lwa-project/analog_receiver/ARX Rev I/Documentation/Pictures/TB-409-74+ GALI-74+ Eval Boad IMG_9608.JPG

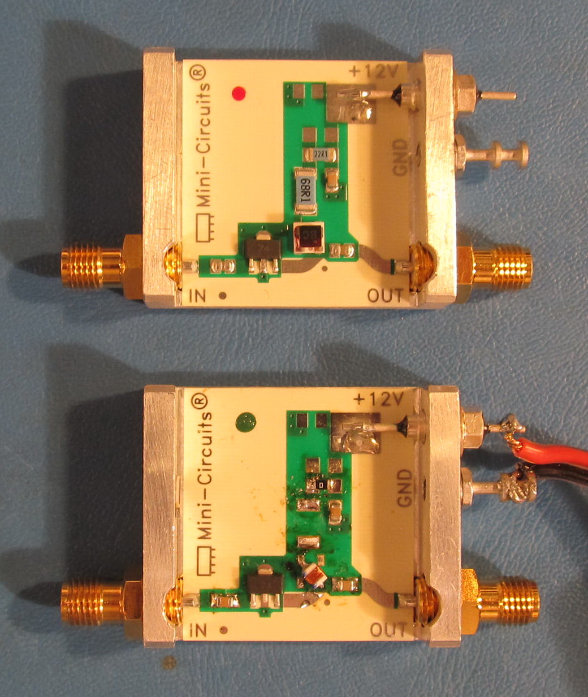
ARX Rev I/Documentation/Pictures/TB-409-74+ GALI-74+ Eval Boad IMG_9608.JPG
