lwa-project/analog_receiver/README.md

LWA Analog Receiver (ARX) Board
===============================
This repo contains the build files for Revision I of the LWA ARX board.
