lwa-project/analog_receiver/ARX Rev I/ARX Rev I Filter Plots/AIO_FB1_10MHz-HPF_2023-08-21_172632.png

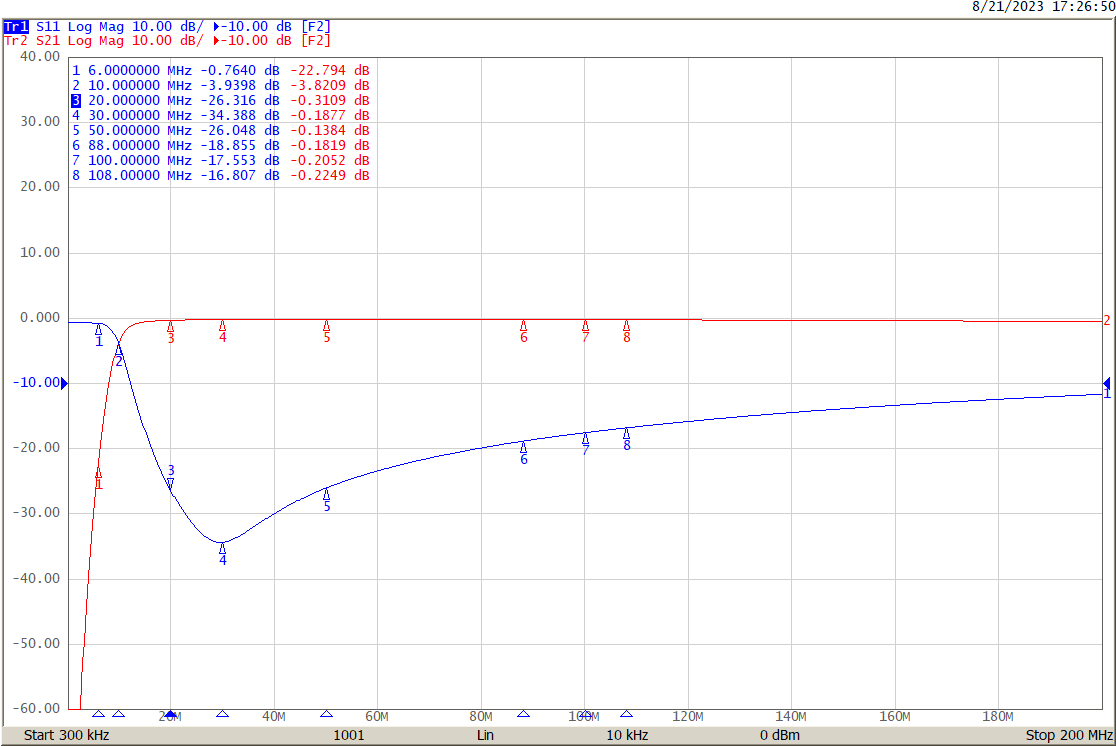
ARX Rev I/ARX Rev I Filter Plots/AIO_FB1_10MHz-HPF_2023-08-21_172632.png
