lwa-project/analog_receiver/ARX Rev I/ARX Rev I Filter Plots/AIO_FB1_30MHz-HPF_2023-08-21_173531.png

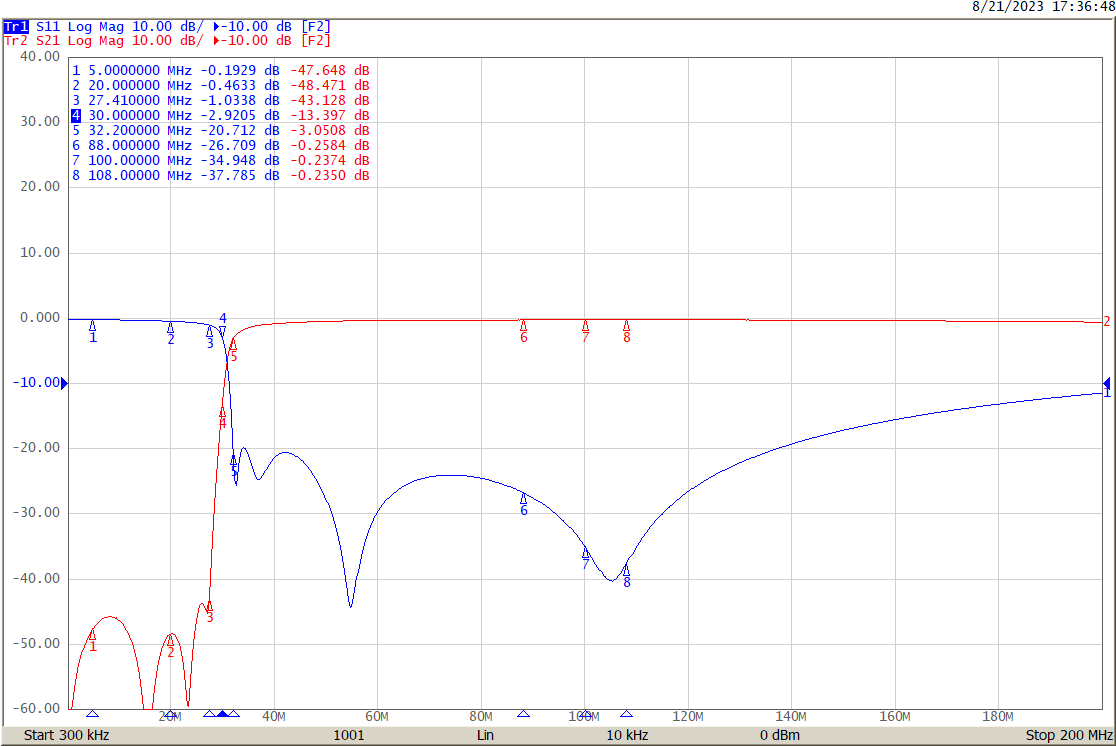
ARX Rev I/ARX Rev I Filter Plots/AIO_FB1_30MHz-HPF_2023-08-21_173531.png
