lwa-project/analog_receiver/ARX Rev I/ARX Rev I Filter Plots/AIO_FB1_83.7MHz-LPF_2023-08-21_172030.png

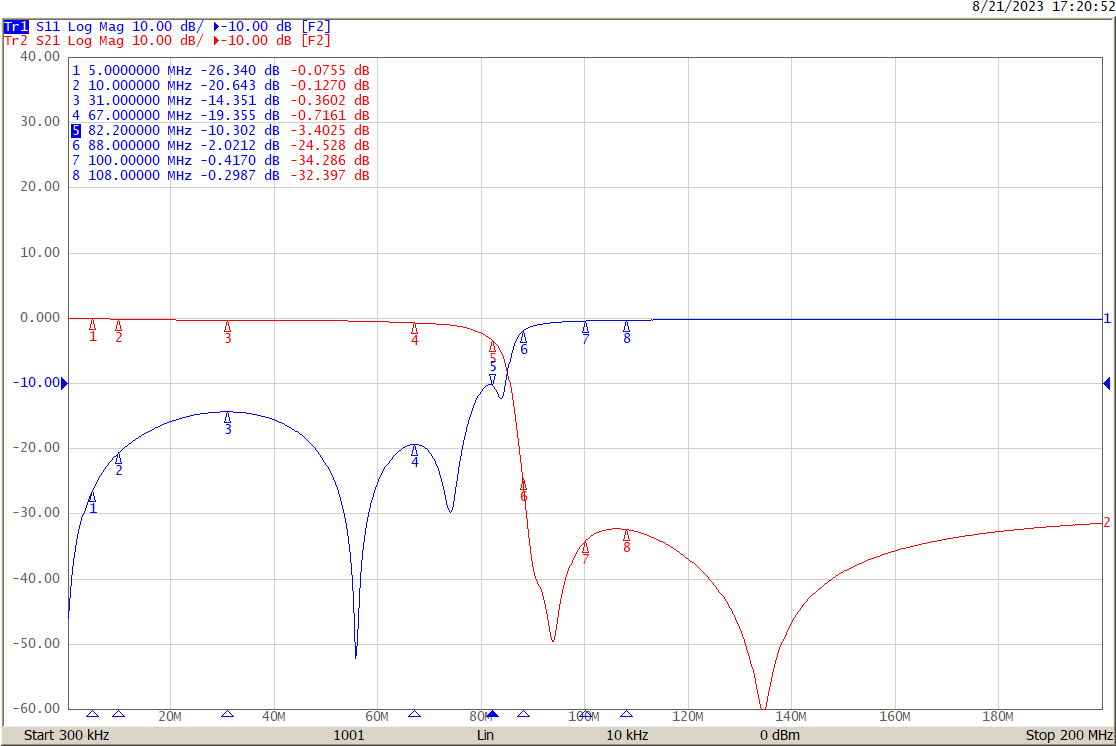
ARX Rev I/ARX Rev I Filter Plots/AIO_FB1_83.7MHz-LPF_2023-08-21_172030.png
