lwa-project/analog_receiver/ARX Rev I/ARX Rev I Filter Plots/AIO_FB5_3MHz-HPF_680pF_2023-09-18_232620.png

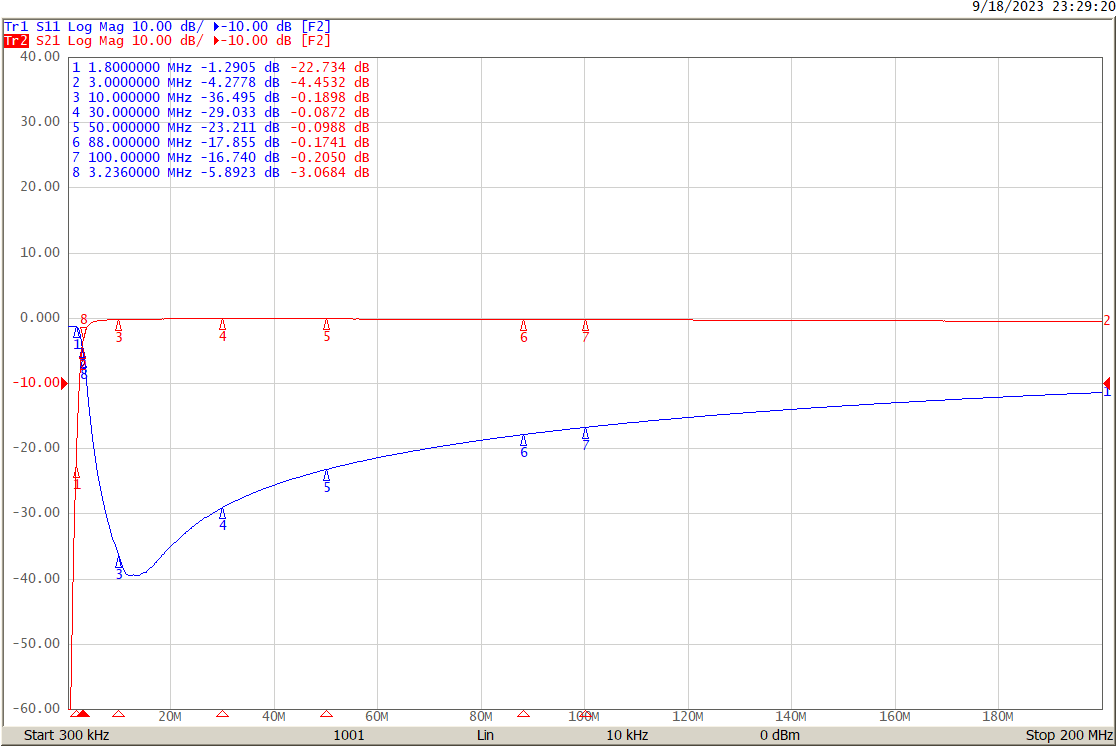
ARX Rev I/ARX Rev I Filter Plots/AIO_FB5_3MHz-HPF_680pF_2023-09-18_232620.png
