lwa-project/analog_receiver/ARX Rev I/ARX Rev I Filter Plots/AIO_FB5_73.5MHz-LPF_2023-08-29_225510.png

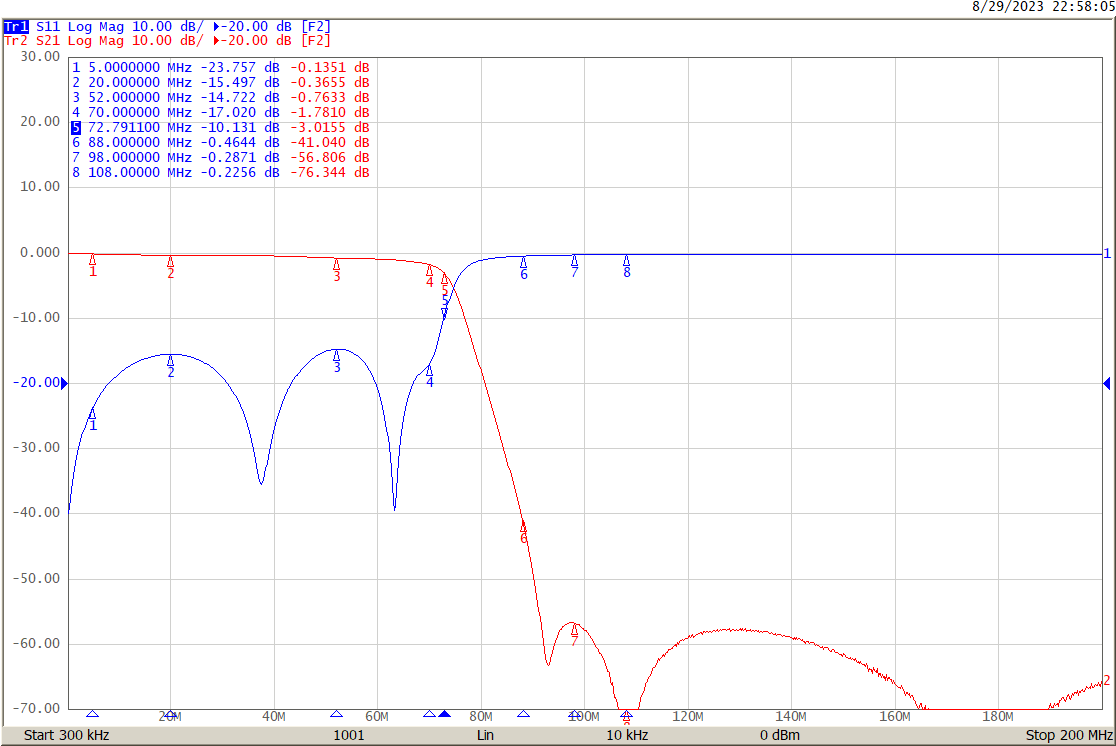
ARX Rev I/ARX Rev I Filter Plots/AIO_FB5_73.5MHz-LPF_2023-08-29_225510.png
