lwa-project/analog_receiver/ARX Rev I/ARX.jpg

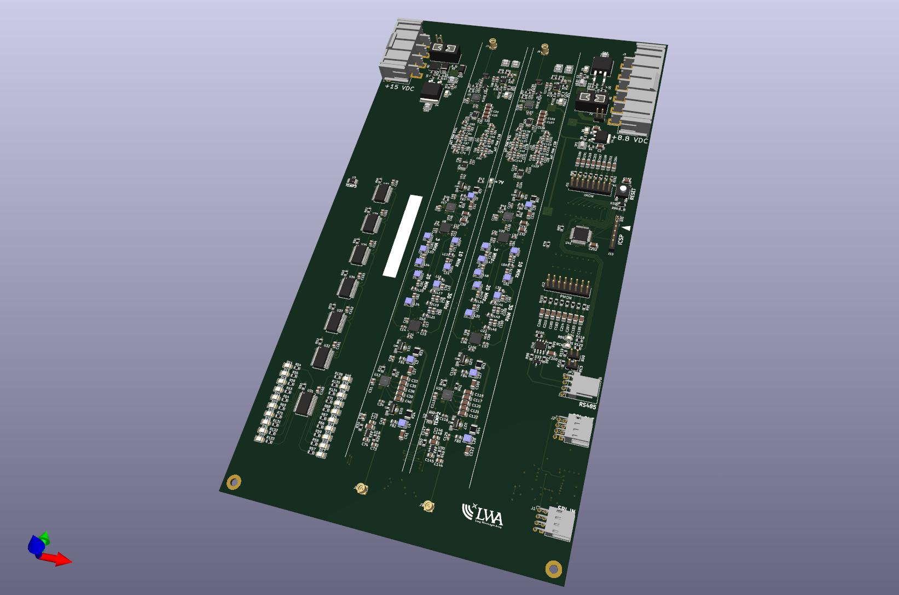
ARX Rev I/ARX.jpg
