lwa-project/analog_receiver/ARX Rev I/ARX_3D_View.png

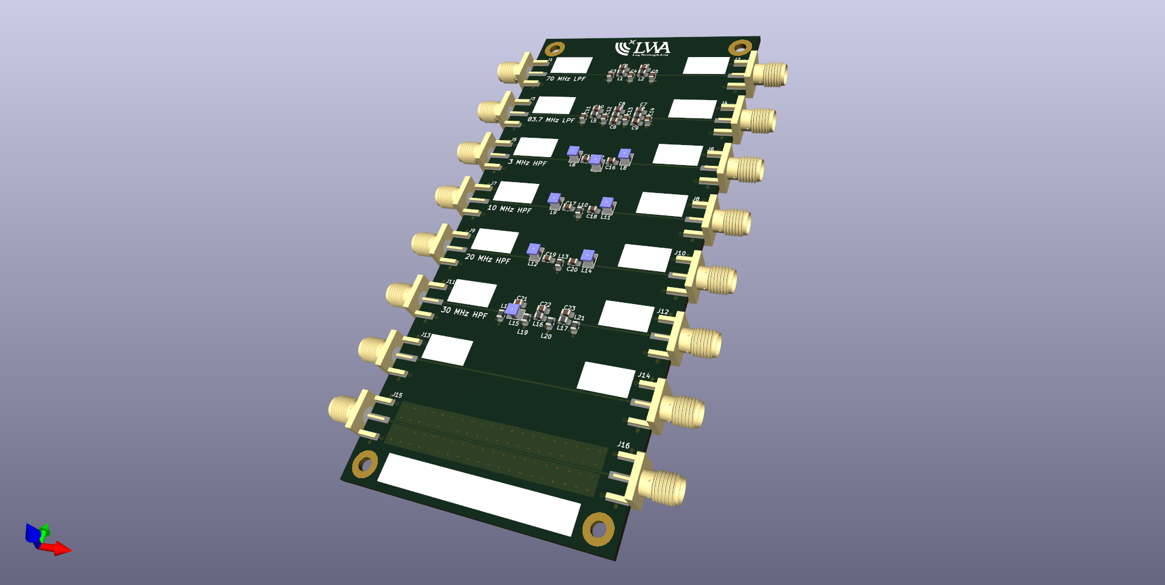
ARX Rev I/ARX_3D_View.png
