lwa-project/analog_receiver/ARX Rev I/Documentation/ARX Rev G Layer Stack.JPG

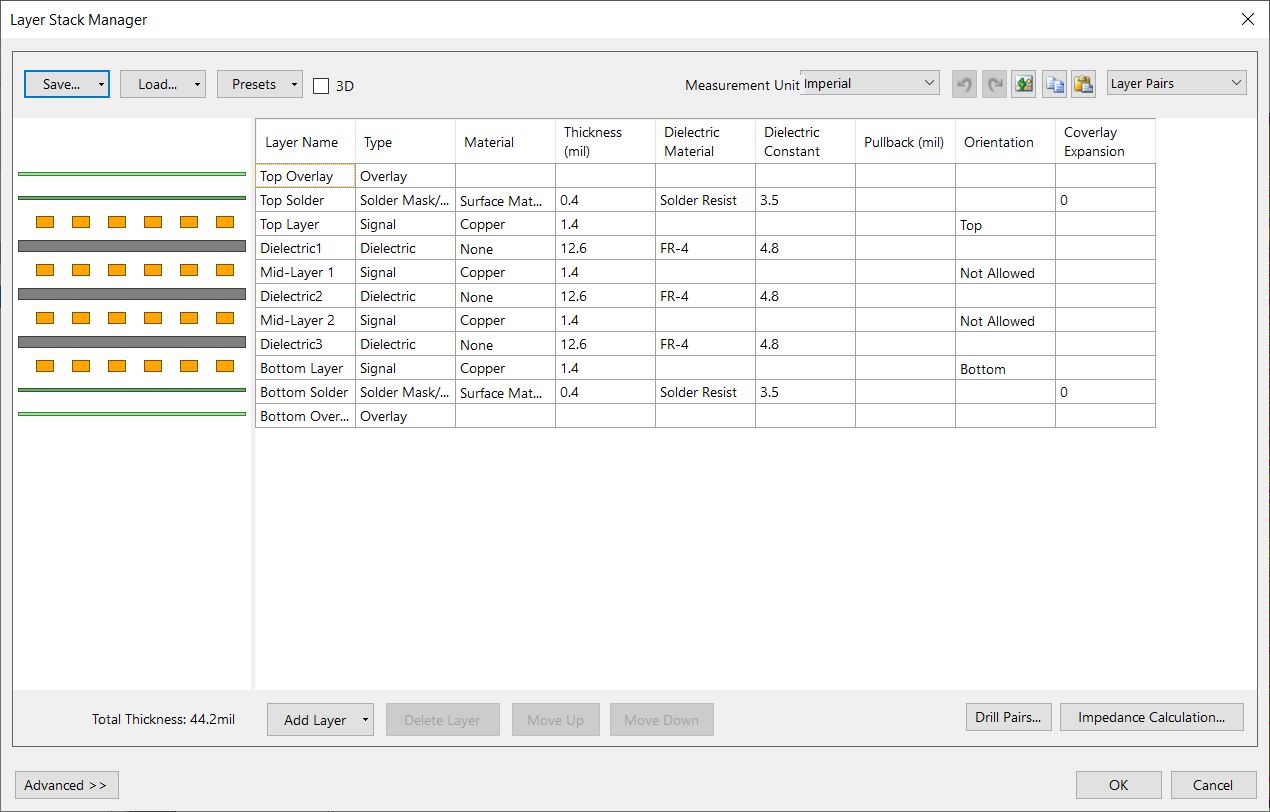
ARX Rev I/Documentation/ARX Rev G Layer Stack.JPG
