lwa-project/analog_receiver/ARX Rev I/Documentation/RevG Buffer/Buffer Fiasco.png

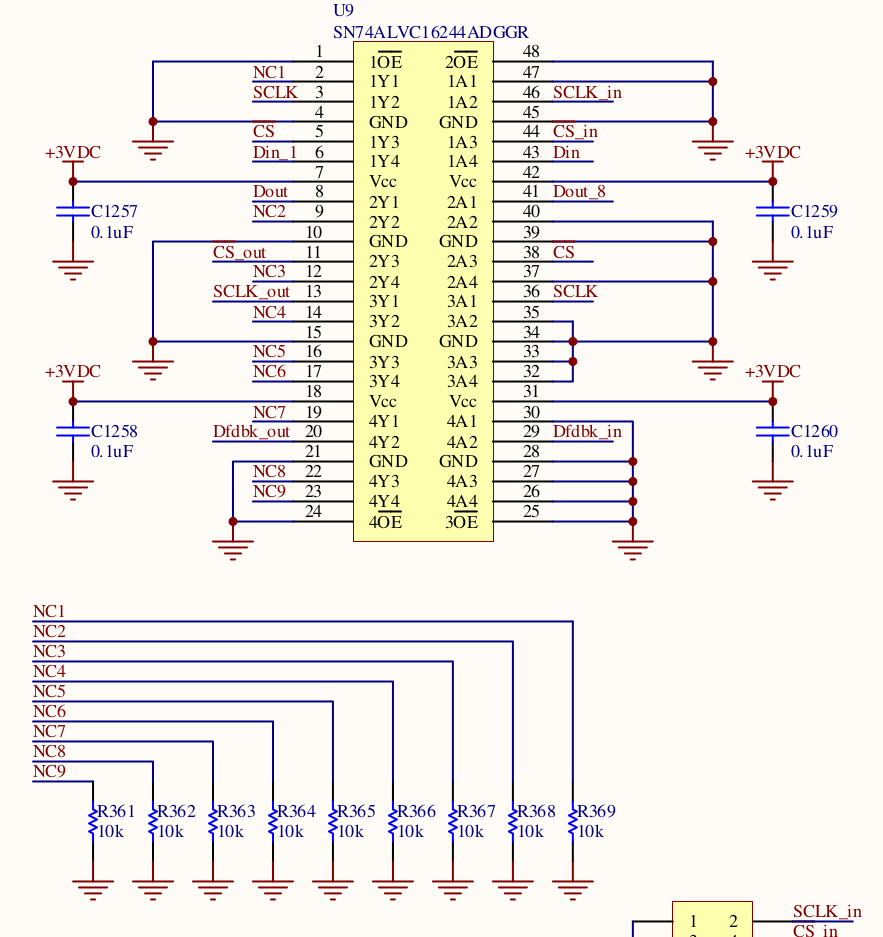
ARX Rev I/Documentation/RevG Buffer/Buffer Fiasco.png
