lwa-project/analog_receiver/ARX Rev I/Filter Designs/ARX Rev. I Filters/HighPass Filters/Schematics Catalog Values/3MHz_HPF_Schematic.png

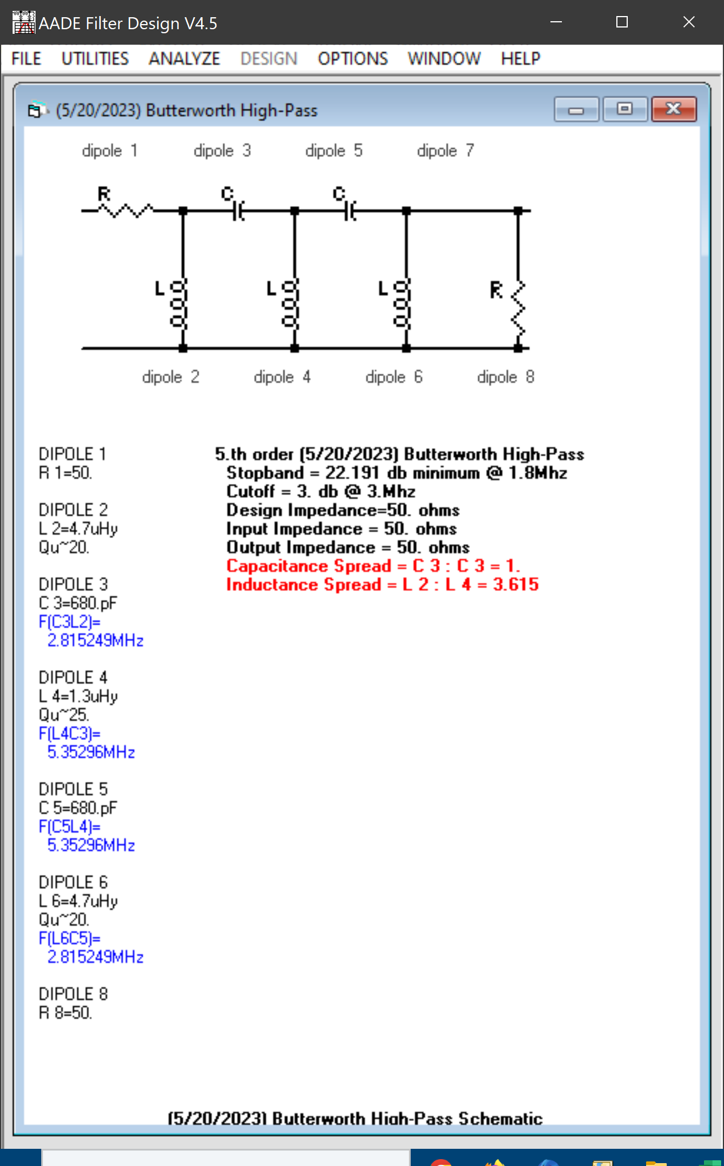
ARX Rev I/Filter Designs/ARX Rev. I Filters/HighPass Filters/Schematics Catalog Values/3MHz_HPF_Schematic.png
