lwa-project/analog_receiver/ARX Rev I/Filter Designs/ARX Rev. I Filters/LowPass Filters/Schematic Catalog Values/70MHz_LPF_Schematic.png

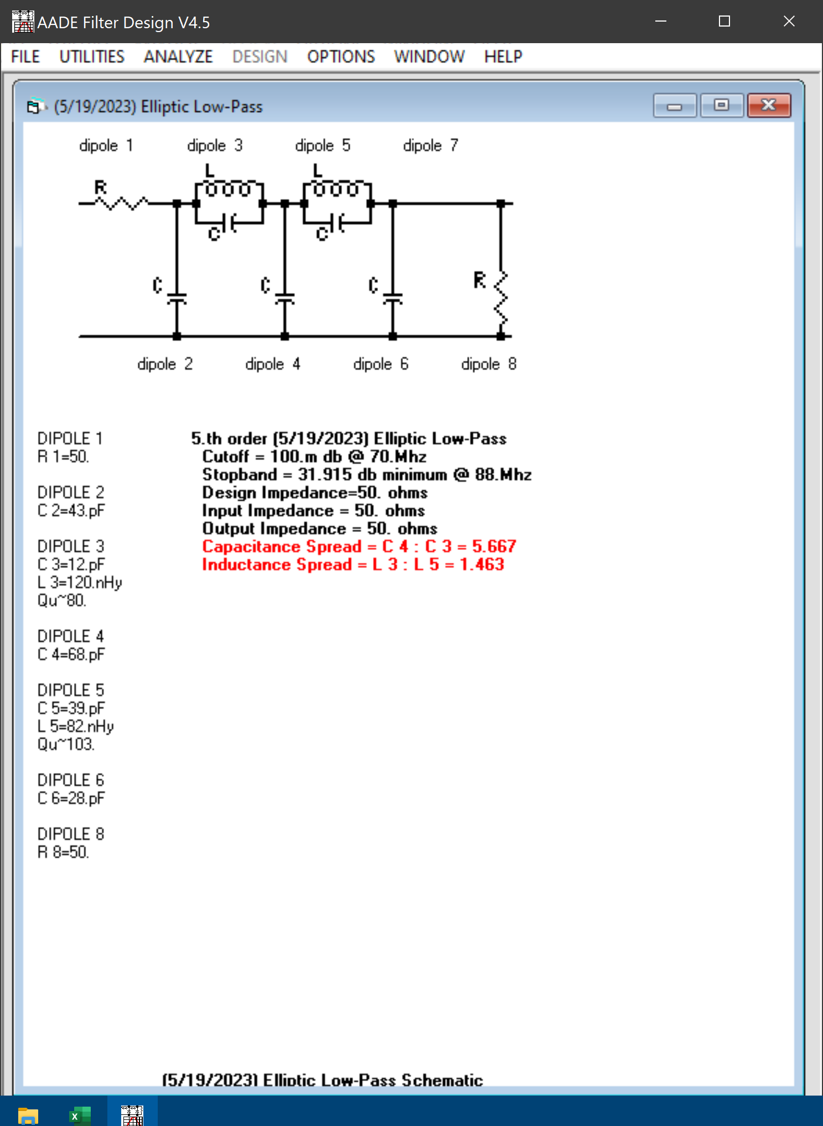
ARX Rev I/Filter Designs/ARX Rev. I Filters/LowPass Filters/Schematic Catalog Values/70MHz_LPF_Schematic.png
