lwa-project/analog_receiver/ARX Rev I/Output Files/3D Views/3D Top View.jpg

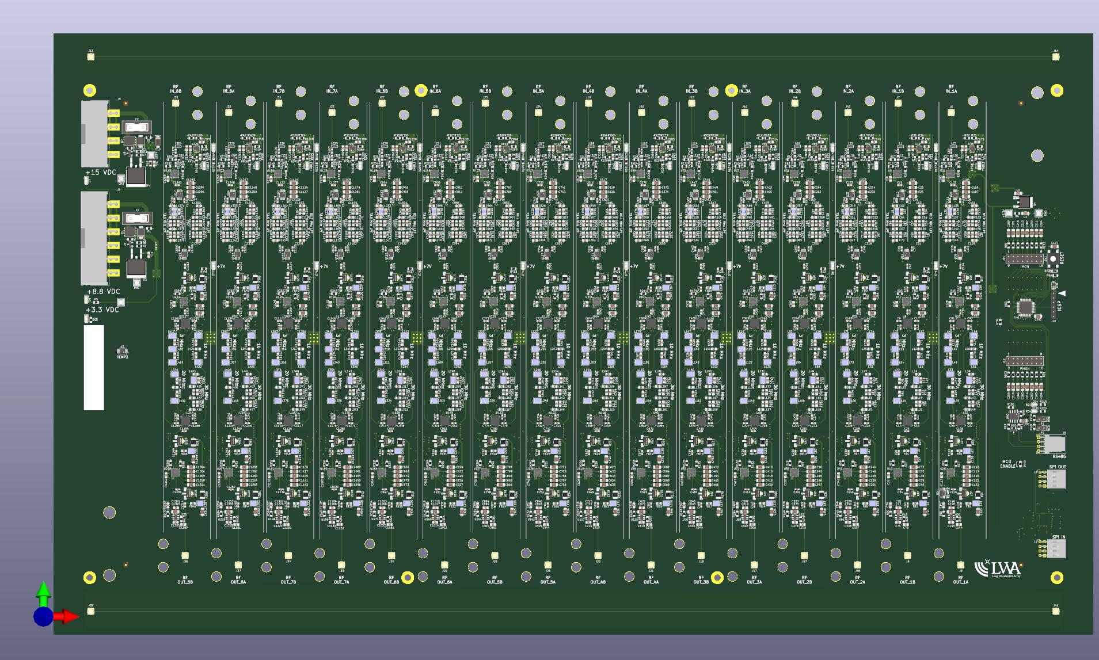
ARX Rev I/Output Files/3D Views/3D Top View.jpg
