lwa-project/analog_receiver/ARX Rev I/Filter Designs/ARX Rev. I Filters/LPF-HPF Filter Designs.xls

Sheet: LPF
Dipole | Calc. | Catalog | Size | SRF | Q | Cost | Dipole | Calc. | Catalog | Size | SRF | Q | Cost
Elliptic LPF, Fc=70 MHz @ 0.1 dB, Fs=88@ 30 dB, Order 5 |  |  |  |  |  |  | Elliptic LPF, Fc=80 MHz @ 0.1 dB, Fs=98MHz @ 30 dB, Order 5
C2 | 43.1p | 43p | 0805 |  |  | $0.29 | C2 | 37.0p | 36p | 0805 |  |  | $0.06
C3 | 12.0p | 12p | 0805 |  |  | $0.06 | C3 | 11.6p | 12p | 0805 |  |  | $0.09
L3 | 126n | 120n | 0805HP | 1265 | 80 | $0.87 | L3 | 108n | 100n | 0805HP | 1400 | 100 | $0.87
C4 | 65.9p | 68p | 0805 |  |  | $0.09 | C4 | 56.2p | 56p | 0805 |  |  | $0.08
C5 | 39.1p | 39p | 0805 |  |  | $0.06 | C5 | 39.9p | 39p | 0805 |  |  | $0.08
L5 | 79n | 82n | 0805HP | 1525 | 103 | $0.87 | L5 | 64.1n | 62n | 0805HP | 1820 | 114 | $0.87
C6 | 27.9p | 27p | 0805 |  |  | $0.06 | C6 | 22.6p | 23p | 0805 |  |  | $0.29
 |  |  |  |  | Total | $2.29 |  |  |  |  |  | Total | $2.33

Sheet: HPF
Dipole | Calc. | Catalog | Size | SRF | Q | Cost | Dipole | Calc. | Catalog | Size | SRF | Q | Cost | h
Butterworth HPF, Fc=3 MHz @ 3.0 dB, Fs=1.8 MHz @ 20 dB, Order 5 |  |  |  |  |  |  | Butterworth HPF, Fc=10 MHz @ 3.0 dB, Fs=6 MHz @ 20 dB, Order 5
L2 | 4294n | 4700n | 1008CS | 90 | 20 |  | L2 | 1288n | 1300n | 1008CS | 200 | 25
C3 | 656.07p | 680p | 0805 |  |  |  | C3 | 196.82p | 200p | 0805
L4 | 1327n | 1300n | 1008CS | 200 | 25 |  | L4 | 398n | 390n | 0805HP | 700 | 52
C5 | 656.07p | 680p | 0805 |  |  |  | C5 | 196.82p | 200p | 0805
L6 | 4294n | 4700n | 1008CS | 90 | 20 |  | L6 | 1288n | 1300n | 1008CS | 200 | 25
 |  |  |  |  | Total | $0.00 |  |  |  |  |  | Total | $0.00
Butterworth HPF, Fc=20 MHz @ 3.0 dB, Fs=12 MHz @ 20 dB, Order 5 |  |  |  |  |  |  | Elliptic HPF, Fc=31 MHz @ 0.1 dB, Fs=26.5MHz @ 30 dB, Order 7
L2 | 644n | 680n | 0805HP | 535 | 46 |  | L2 | 247.62n | 250n | 0805HP | 873 | 74
C3 | 98.41p | 96p | 0805 |  |  |  | C3 | 83.42p | 82p | 0805
L4 | 199n | 200n | 0805HP | 950 | 75 |  | L3 | 1432n | 1300n | 1008CS | 200 | 25
C5 | 98.41p | 96p | 0805 |  |  |  | L4 | 178.9n | 180n | 0805HP | 1025
L6 | 644n | 680n | 0805HP | 535 | 46 |  | C5 | 132.55p | 130p | 0805
 |  |  |  |  |  |  | L5 | 279n | 270n | 0805HP | 830 | 75
 |  |  |  |  | Total | $0.00 | L6 | 208n | 200n | 0805HP | 950 | 75
 |  |  |  |  |  |  | C7 | 123.64p | 120p | 0805
 |  |  |  |  |  |  | L7 | 387n | 390n | 0805HP | 700 | 52
 |  |  |  |  |  |  | L8 | 364n | 390n | 0805HP | 700 | 52
 |  |  |  |  |  |  |  |  |  |  |  | Total | $0.00

Sheet: Residual
Chebyshev LPF, Fc=70 MHz @ 0.1 dB, Fs=88 MHz @ 30 dB, Order 9 |  |  |  |  |  |  | Chebyshev LPF, Fc=80 MHz @ 0.1 dB, Fs=88 MHz @ 30 dB, Order 11
C2 | 54.37 | 56.00 | 0805 |  |  | $0.07 | C2 | 47.87 | 47.00 | 0805 |  |  | $0.09
L3 | 164.00 | 180.00 | 0805HP | 1025 | 77 | $0.87 | L3 | 144.46 | 150.00 | 0805HP | 1150 | 80 | $0.87
C4 | 97.06 | 100.00 | 0805 |  |  | $0.07 | C4 | 85.60 | 82.00 | 0805 |  |  | $0.06
L5 | 183.79 | 180.00 | 0805HP | 1025 | 77 | $0.87 | L5 | 162.46 | 180.00 | 0805HP | 1025 | 77 | $0.87
C6 | 100.28 | 100.00 | 0805 |  |  | $0.07 | C6 | 89.04 | 91.00 | 0805 |  |  | $0.20
L7 | 183.79 | 180.00 | 0805HP | 1025 | 77 | $0.87 | L7 | 164.72 | 180.00 | 0805HP | 1025 | 77 | $0.87
C8 | 97.06 | 100.00 | 0805 |  |  | $0.07 | C8 | 89.04 | 91.00 | 0805 |  |  | $0.20
L9 | 164.00 | 180.00 | 0805HP | 1025 | 77 | $0.87 | L9 | 162.46 | 180.00 | 0805HP | 1025 | 77 | $0.87
C10 | 54.37 | 56.00 | 0805 |  |  | $0.07 | C10 | 85.60 | 82.00 | 0805 |  |  | $0.06
 |  |  |  |  | Total | $3.84 | L11 | 144.46 | 150.00 | 0805HP | 1150 | 80 | $0.87
 |  |  |  |  |  |  | C12 | 47.87 | 47.00 | 0805 |  |  | $0.09
 |  |  |  |  |  |  |  |  |  |  |  | Total | $5.03
