lwa-project/analog_receiver/ARX Rev I/Project PCB Libraries/3D Models/mf-msmf050.stp

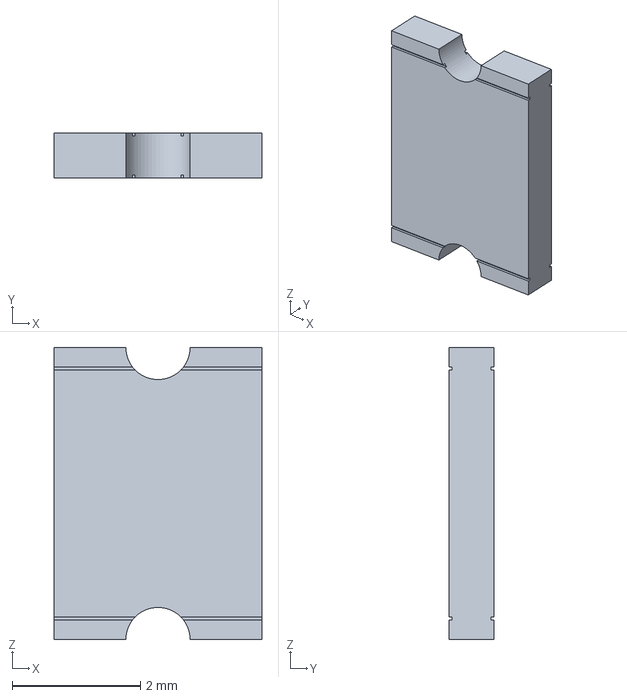
[picture p22: CAD file, 2025-10-08]
ARX Rev I/Project PCB Libraries/3D Models/mf-msmf050.stp
3.24 x 0.7 x 4.55 mm
