lwa-project/analog_receiver/ARX Rev I/Project PCB Libraries/3D Models/0ZCJ0050AF2E.STEP

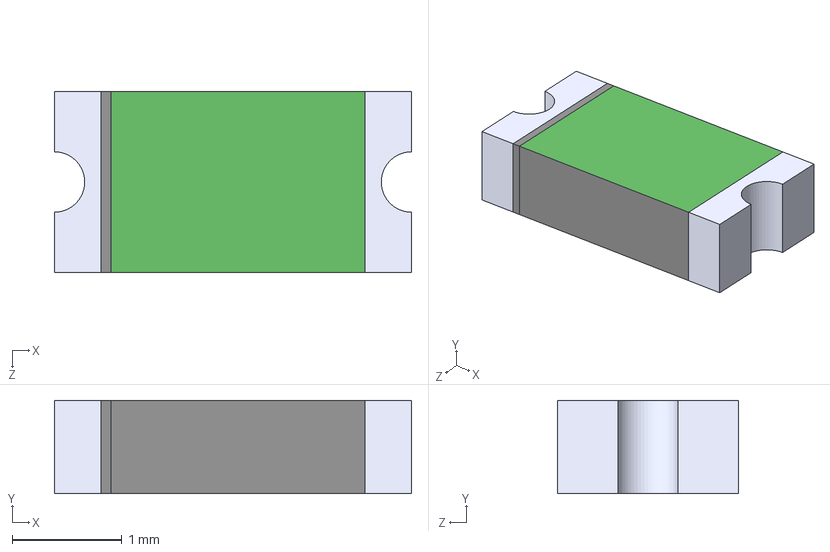
[picture p23: CAD file, 2025-10-08]
ARX Rev I/Project PCB Libraries/3D Models/0ZCJ0050AF2E.STEP
3.25 x 0.85 x 1.65 mm
