lwa-project/analog_receiver/ARX Rev I/Project PCB Libraries/3D Models/DRB0008A.stp

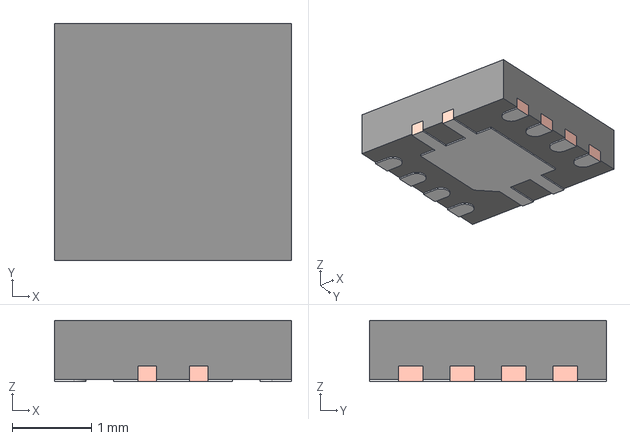
[picture p24: CAD file, 2025-10-08]
ARX Rev I/Project PCB Libraries/3D Models/DRB0008A.stp
3.00 x 3.00 x 0.775 mm
BODY-SON
FRAME-DRB0008A
