lwa-project/analog_receiver/ARX Rev I/Project PCB Libraries/3D Models/keystone-PN3034TR.STEP

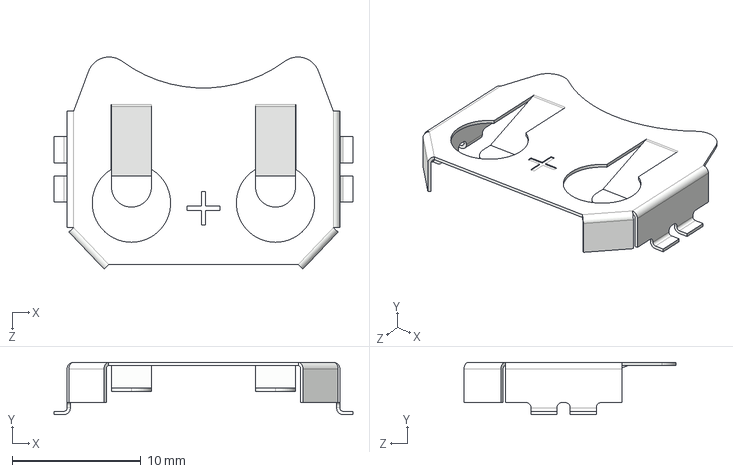
[picture p25: CAD file, 2025-10-08]
ARX Rev I/Project PCB Libraries/3D Models/keystone-PN3034TR.STEP
23.2 x 4.06 x 16.5 mm
