lwa-project/analog_receiver/ARX Rev I/Project PCB Libraries/3D Models/LGA-32.STEP

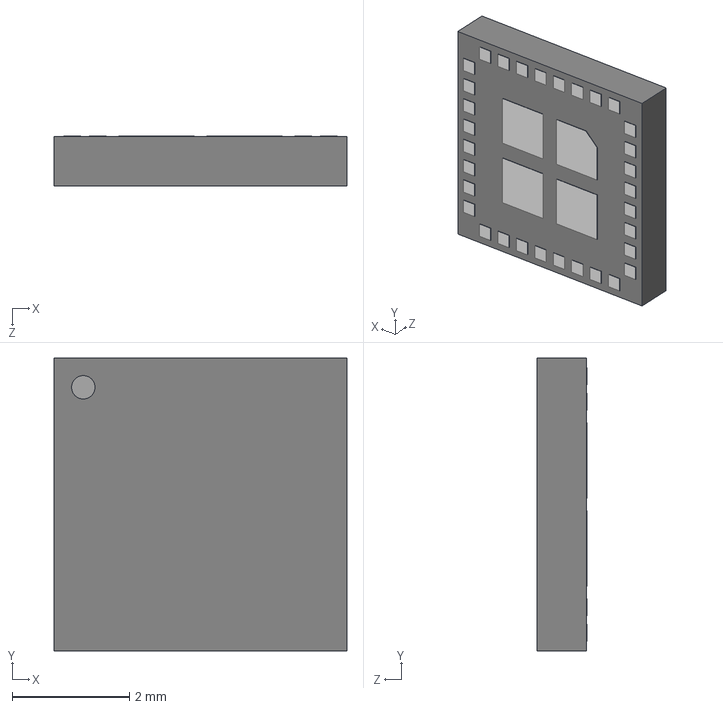
[picture p26: CAD file, 2025-10-08]
ARX Rev I/Project PCB Libraries/3D Models/LGA-32.STEP
5.00 x 5.00 x 0.85 mm
