lwa-project/analog_receiver/ARX Rev I/Project PCB Libraries/3D Models/142-0701-201.stp

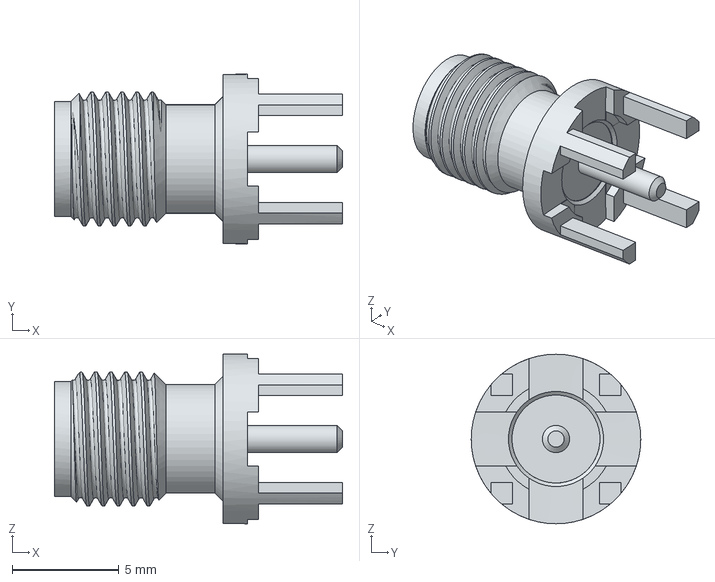
[picture p27: CAD file, 2025-10-08]
ARX Rev I/Project PCB Libraries/3D Models/142-0701-201.stp
13.5 x 7.92 x 7.92 mm
