lwa-project/analog_receiver/ARX Rev I/Project PCB Libraries/3D Models/BUSSMAN FUSE.STEP

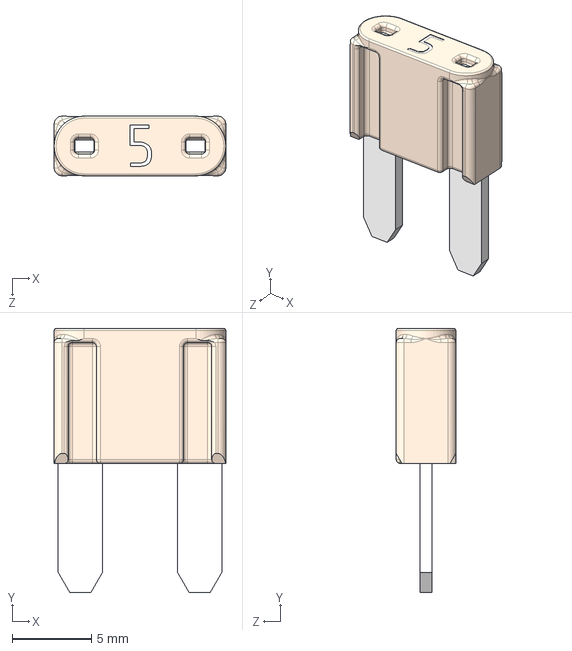
[picture p28: CAD file, 2025-10-08]
ARX Rev I/Project PCB Libraries/3D Models/BUSSMAN FUSE.STEP
10.8 x 16.6 x 3.76 mm
