lwa-project/analog_receiver/ARX Rev I/Project PCB Libraries/3D Models/CD636-1.STEP

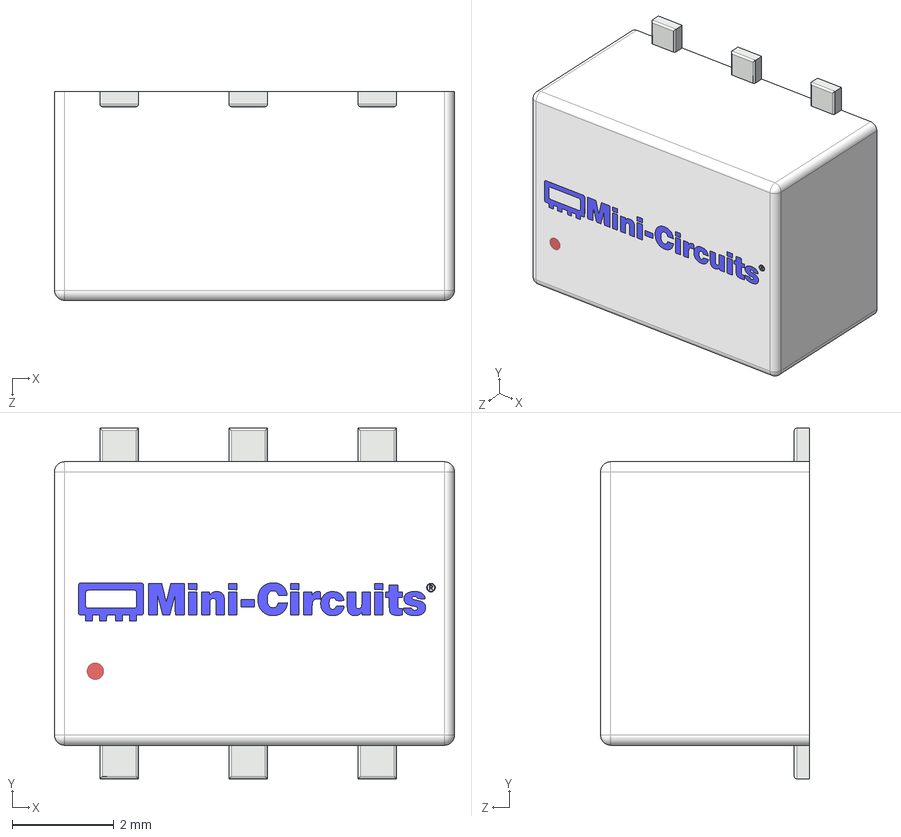
[picture p29: CAD file, 2025-10-08]
ARX Rev I/Project PCB Libraries/3D Models/CD636-1.STEP
7.87 x 6.90 x 4.11 mm
