lwa-project/analog_receiver/ARX Rev I/Project PCB Libraries/3D Models/MODII-826470-4-h-3d.stp

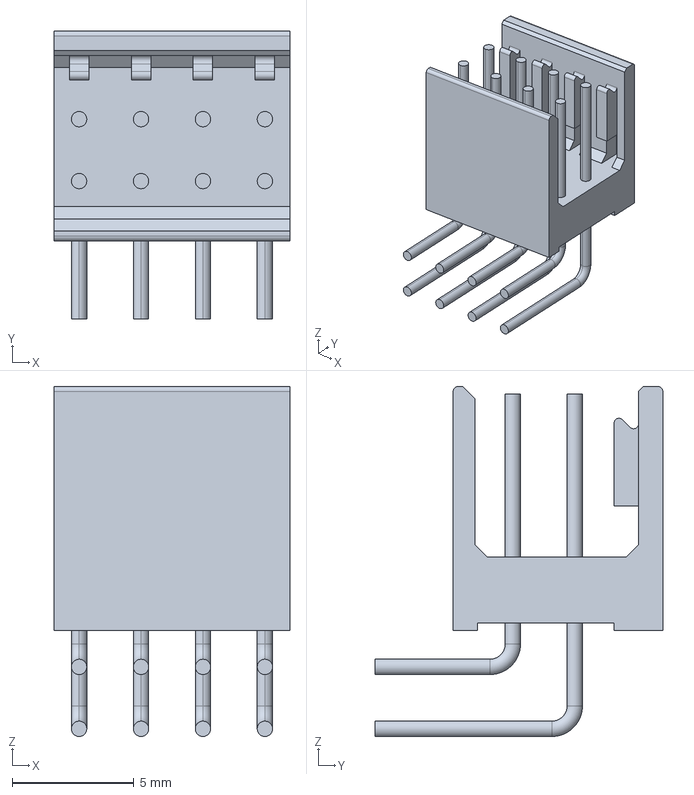
[picture p30: CAD file, 2025-10-08]
ARX Rev I/Project PCB Libraries/3D Models/MODII-826470-4-h-3d.stp
9.66 x 11.8 x 14.4 mm
