lwa-project/analog_receiver/ARX Rev I/Project PCB Libraries/3D Models/R_2512_6332Metric.step

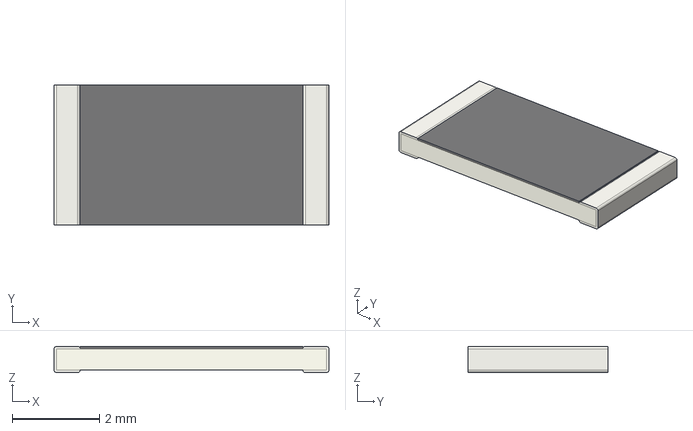
[picture p31: CAD file, 2025-10-08]
ARX Rev I/Project PCB Libraries/3D Models/R_2512_6332Metric.step
6.30 x 3.20 x 0.6 mm
