lwa-project/analog_receiver/ARX Rev I/Project PCB Libraries/3D Models/2035-09-sm-rplf.stp

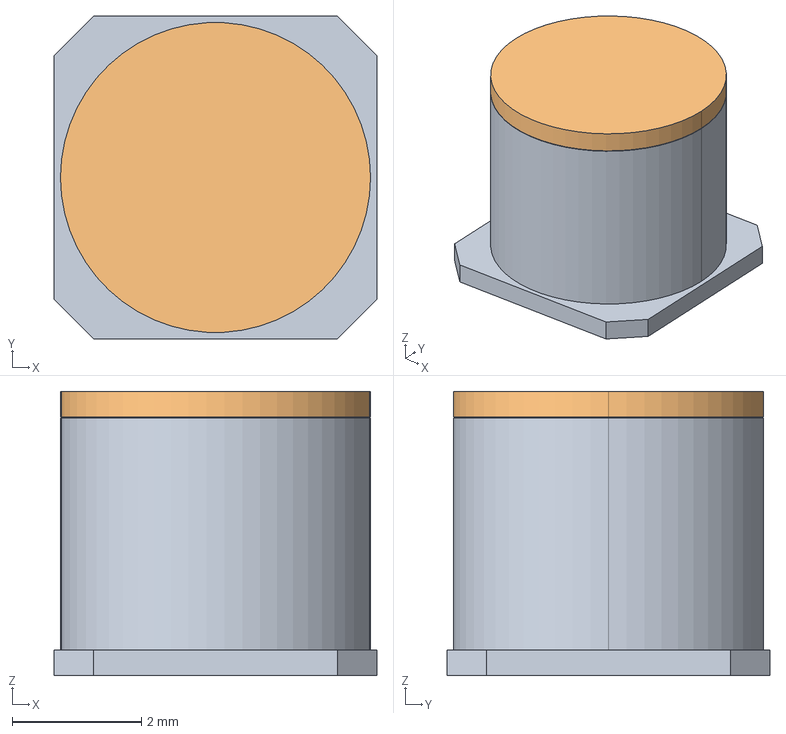
[picture p32: CAD file, 2025-10-08]
ARX Rev I/Project PCB Libraries/3D Models/2035-09-sm-rplf.stp
5.00 x 5.00 x 4.40 mm
