lwa-project/analog_receiver/ARX Rev I/Project PCB Libraries/3D Models/CUI_CVS-1508.step

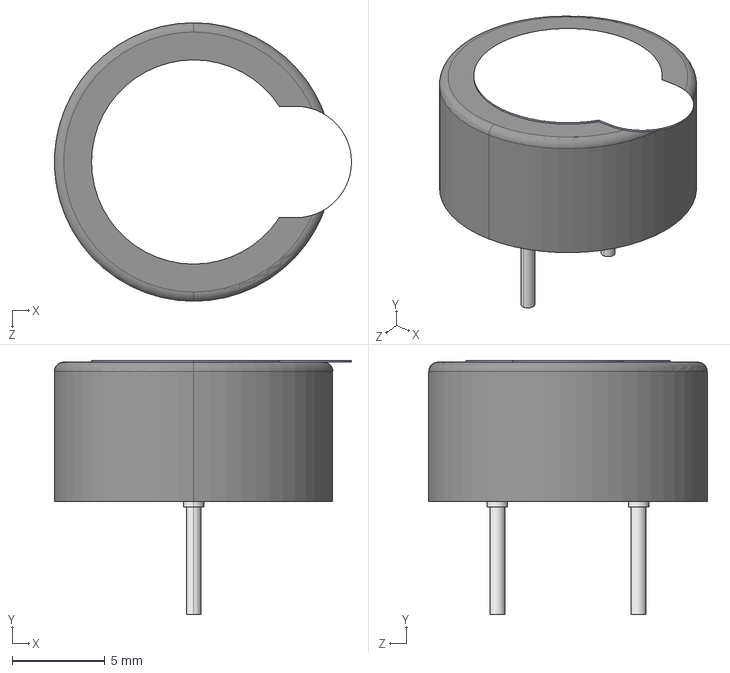
[picture p33: CAD file, 2025-10-08]
ARX Rev I/Project PCB Libraries/3D Models/CUI_CVS-1508.step
16.0 x 13.7 x 15.0 mm
