lwa-project/analog_receiver/ARX Rev I/Project PCB Libraries/3D Models/s1621-46r.stp

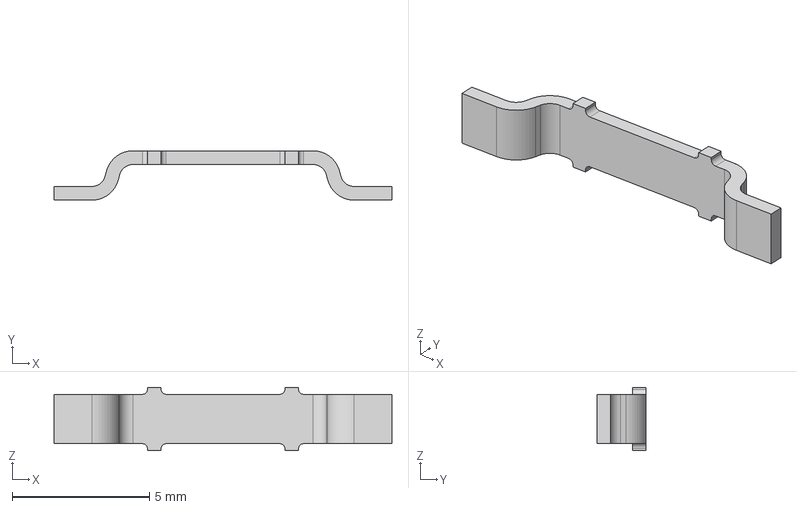
[picture p34: CAD file, 2025-10-08]
ARX Rev I/Project PCB Libraries/3D Models/s1621-46r.stp
12.3 x 1.80 x 2.30 mm
