lwa-project/analog_receiver/ARX Rev I/Project PCB Libraries/3D Models/B3FS_101.step

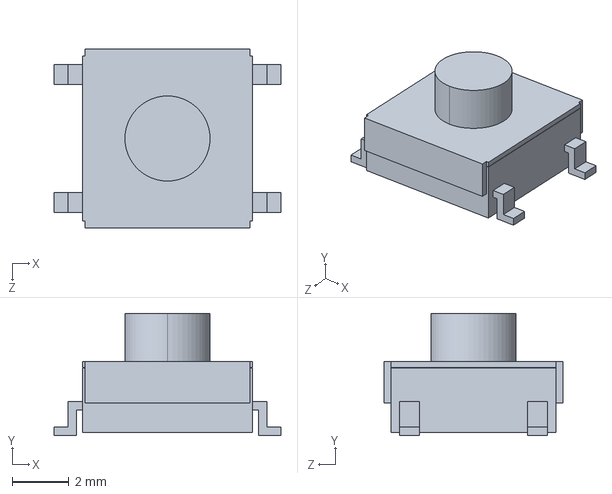
[picture p35: CAD file, 2025-10-08]
ARX Rev I/Project PCB Libraries/3D Models/B3FS_101.step
8.00 x 4.30 x 6.30 mm
