lwa-project/analog_receiver/ARX Rev I/Project PCB Libraries/3D Models/Coilcraft-1205POC.step

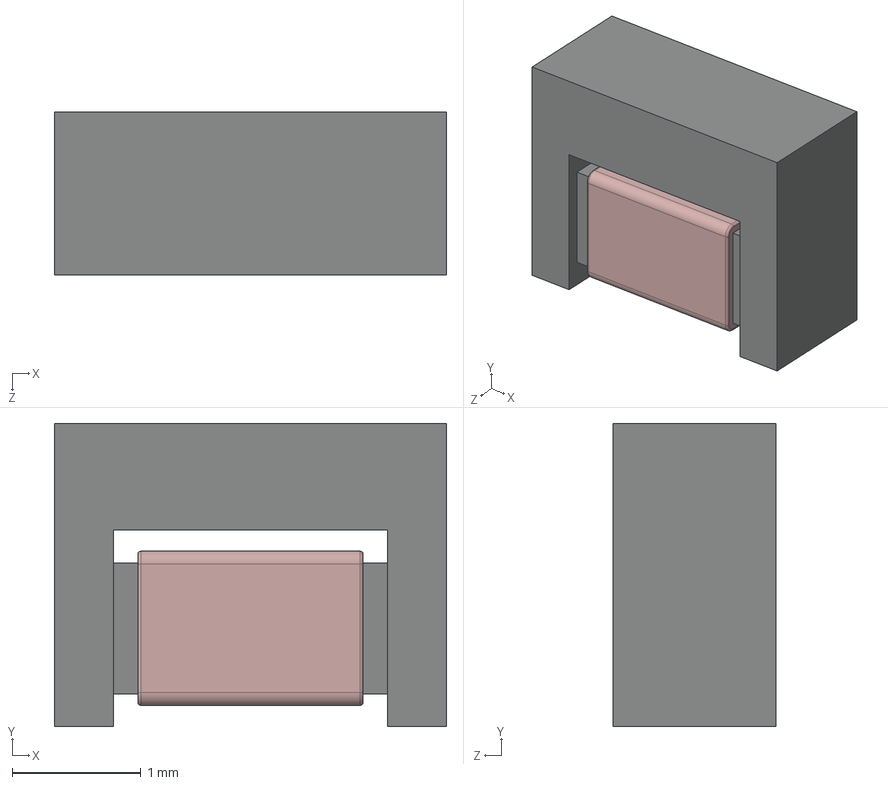
[picture p36: CAD file, 2025-10-08]
ARX Rev I/Project PCB Libraries/3D Models/Coilcraft-1205POC.step
3.05 x 2.36 x 1.27 mm
