lwa-project/analog_receiver/ARX Rev I/Project PCB Libraries/3D Models/PAT1210.STEP

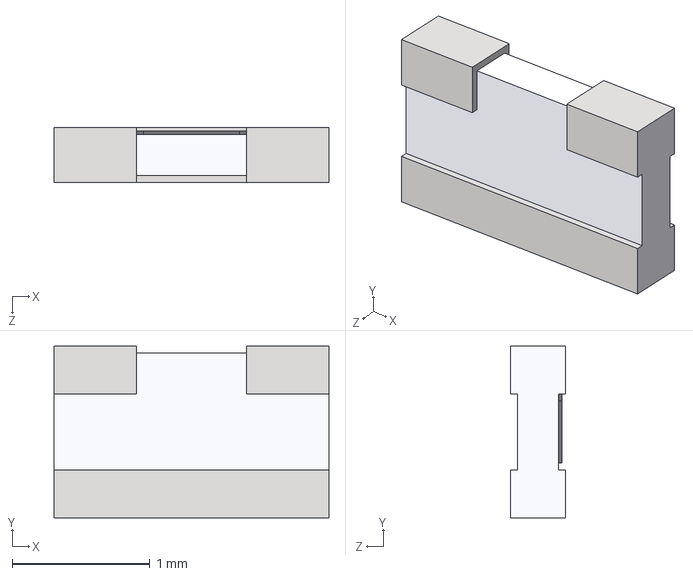
[picture p37: CAD file, 2025-10-08]
ARX Rev I/Project PCB Libraries/3D Models/PAT1210.STEP
2.00 x 1.25 x 0.4 mm
