lwa-project/analog_receiver/ARX Rev I/Project PCB Libraries/3D Models/Coilcraft-1008HT.STEP

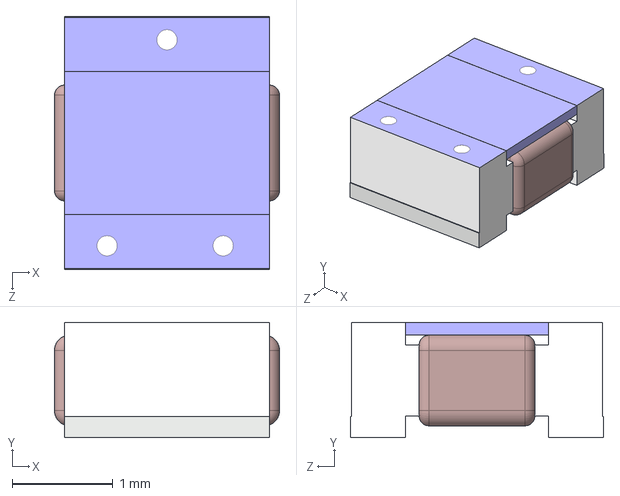
[picture p38: CAD file, 2025-10-08]
ARX Rev I/Project PCB Libraries/3D Models/Coilcraft-1008HT.STEP
2.23 x 1.14 x 2.51 mm
