lwa-project/analog_receiver/ARX Rev I/Project PCB Libraries/3D Models/PT10xV10-A_w_axle-1.STEP

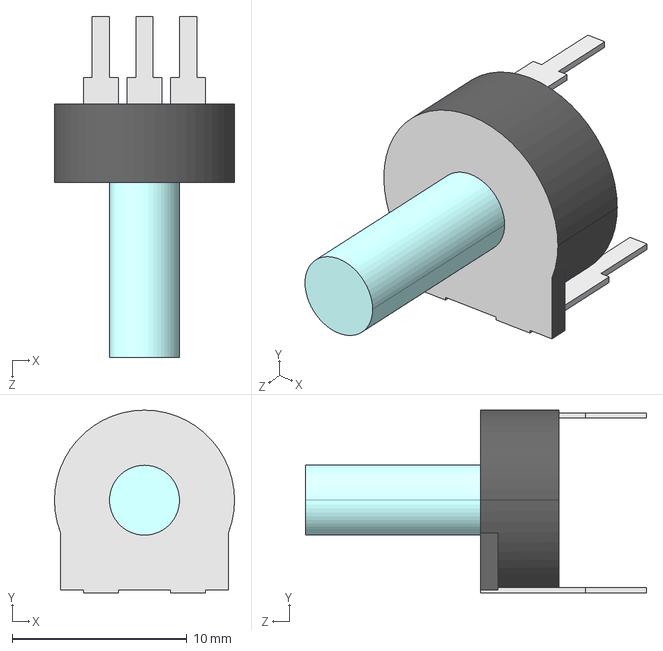
[picture p39: CAD file, 2025-10-08]
ARX Rev I/Project PCB Libraries/3D Models/PT10xV10-A_w_axle-1.STEP
10.3 x 10.5 x 19.5 mm
