lwa-project/analog_receiver/ARX Rev I/Project PCB Libraries/3D Models/HC49_US-SM.STEP

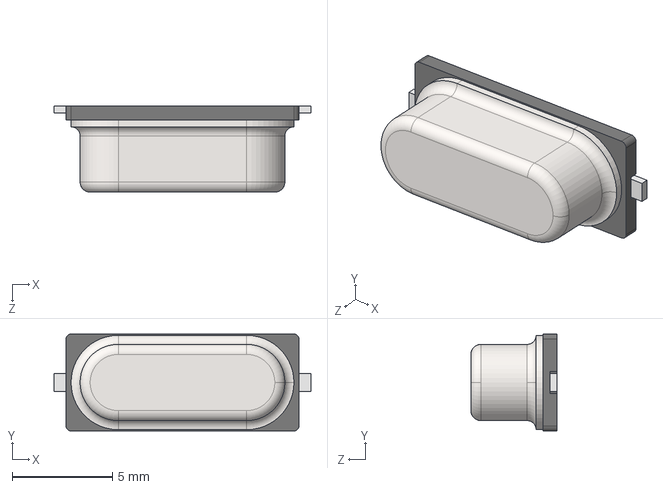
[picture p40: CAD file, 2025-10-08]
ARX Rev I/Project PCB Libraries/3D Models/HC49_US-SM.STEP
12.8 x 4.83 x 4.30 mm
