lwa-project/analog_receiver/ARX Rev I/Project PCB Libraries/3D Models/Molex SMA 73251-1150-SMA.STEP

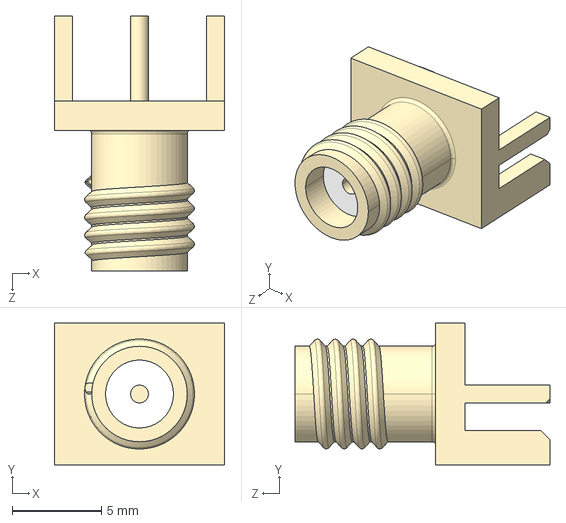
[picture p42: CAD file, 2025-10-08]
ARX Rev I/Project PCB Libraries/3D Models/Molex SMA 73251-1150-SMA.STEP
9.53 x 7.93 x 14.3 mm
