lwa-project/analog_receiver/ARX Rev I/Project PCB Libraries/3D Models/Coilcraft-1008CS.STEP

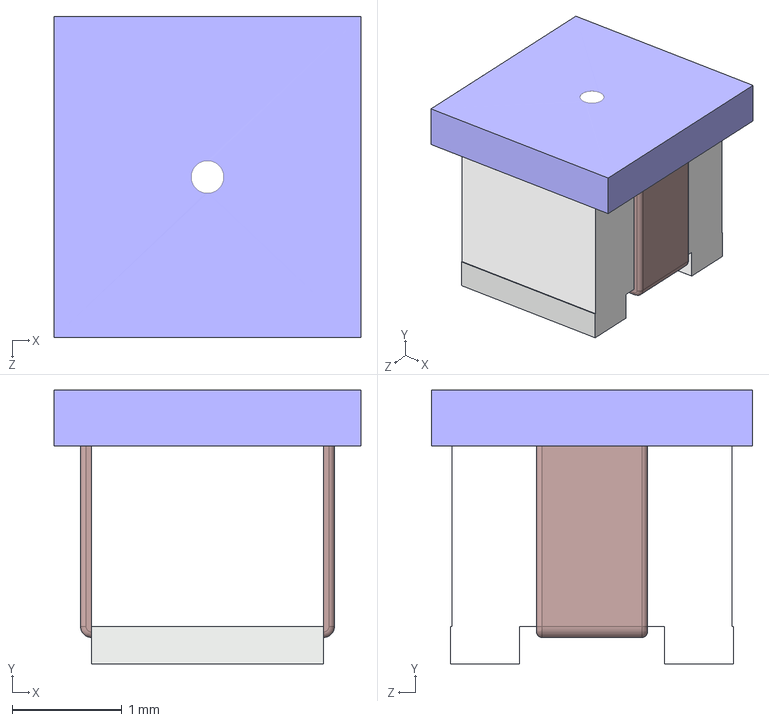
[picture p43: CAD file, 2025-10-08]
ARX Rev I/Project PCB Libraries/3D Models/Coilcraft-1008CS.STEP
2.79 x 2.49 x 2.92 mm
