lwa-project/analog_receiver/ARX Rev I/Project PCB Libraries/3D Models/s1751-46r.stp

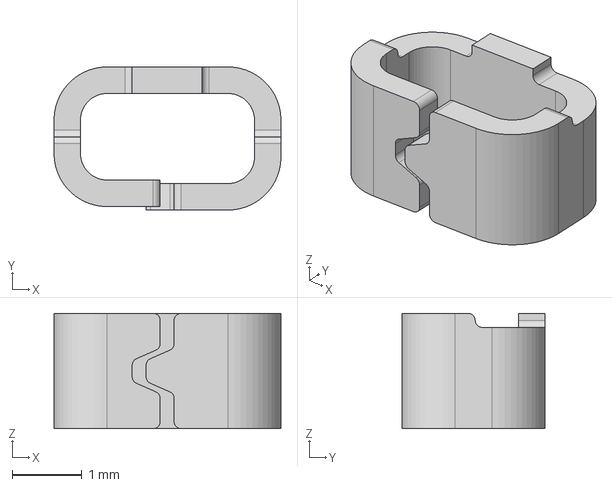
[picture p44: CAD file, 2025-10-08]
ARX Rev I/Project PCB Libraries/3D Models/s1751-46r.stp
3.25 x 2.05 x 1.65 mm
