lwa-project/analog_receiver/ARX Rev I/Project PCB Libraries/3D Models/Micro_USB_A_10103594.STEP

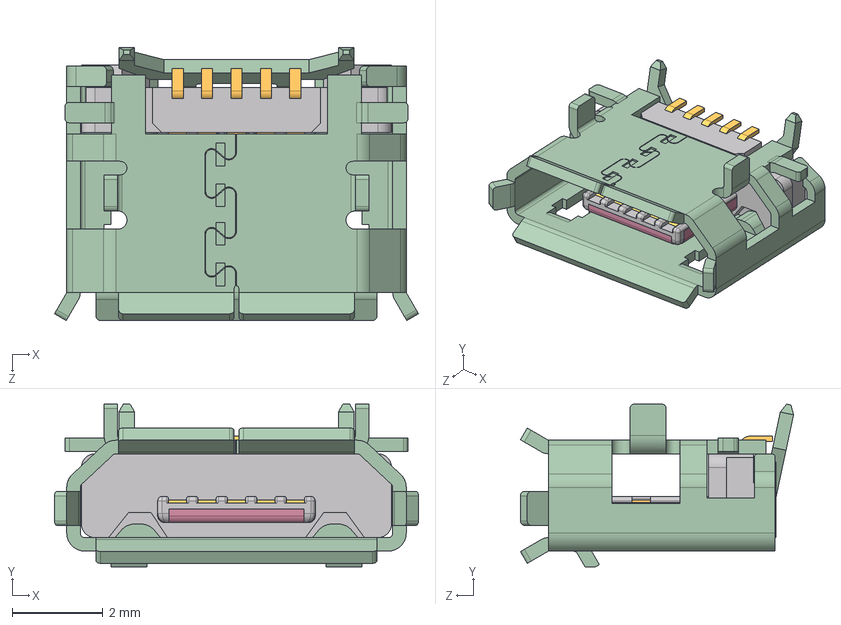
[picture p45: CAD file, 2025-10-08]
ARX Rev I/Project PCB Libraries/3D Models/Micro_USB_A_10103594.STEP
8.04 x 3.60 x 6.03 mm
User Library-10103594_MICRO-USB-SCOKET-HOUSING
User Library-10103594_MICRO-USB-SCOKET-INSERT-TML
User Library-10103594_SHIELD
User Library-10103594_SUS_PLATE
