lwa-project/analog_receiver/ARX Rev I/Project PCB Libraries/3D Models/Terminal 282834-2-c-3d.stp

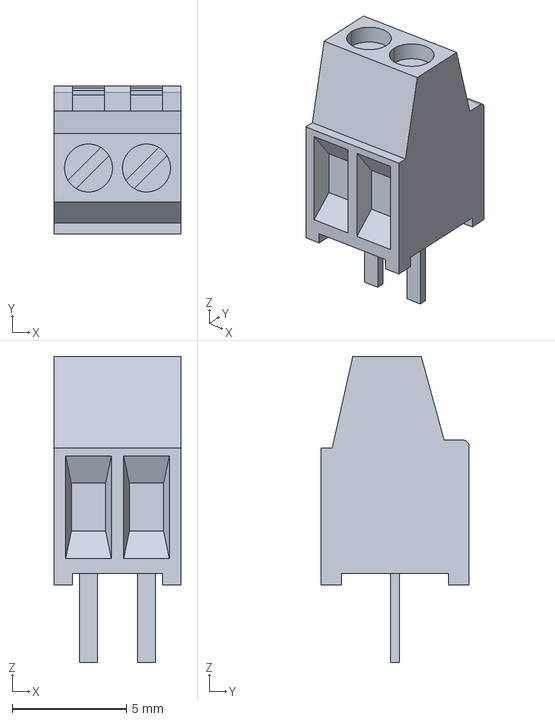
[picture p46: CAD file, 2025-10-08]
ARX Rev I/Project PCB Libraries/3D Models/Terminal 282834-2-c-3d.stp
5.54 x 6.50 x 13.4 mm
