lwa-project/analog_receiver/ARX Rev I/Project PCB Libraries/3D Models/c-5555165-1-e-3d.stp

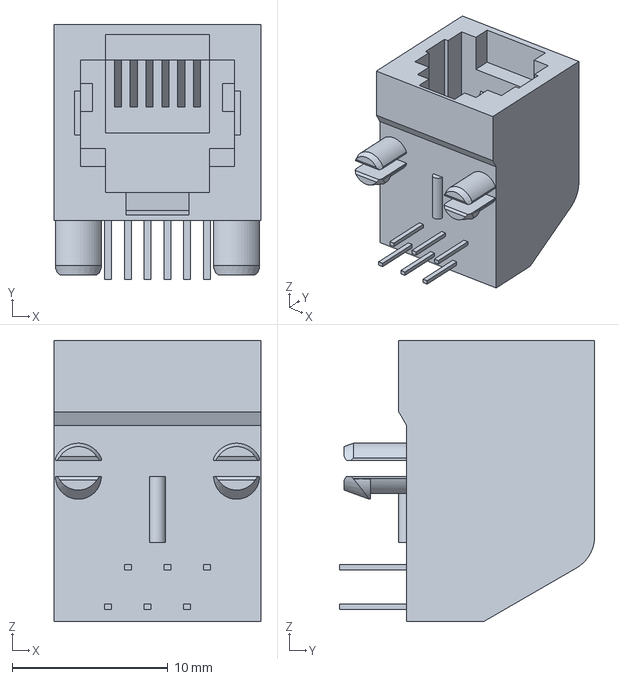
[picture p47: CAD file, 2025-10-08]
ARX Rev I/Project PCB Libraries/3D Models/c-5555165-1-e-3d.stp
13.3 x 16.4 x 18.0 mm
