lwa-project/analog_receiver/ARX Rev I/Project PCB Libraries/3D Models/Female Header 2x4_2.54 mm.stp

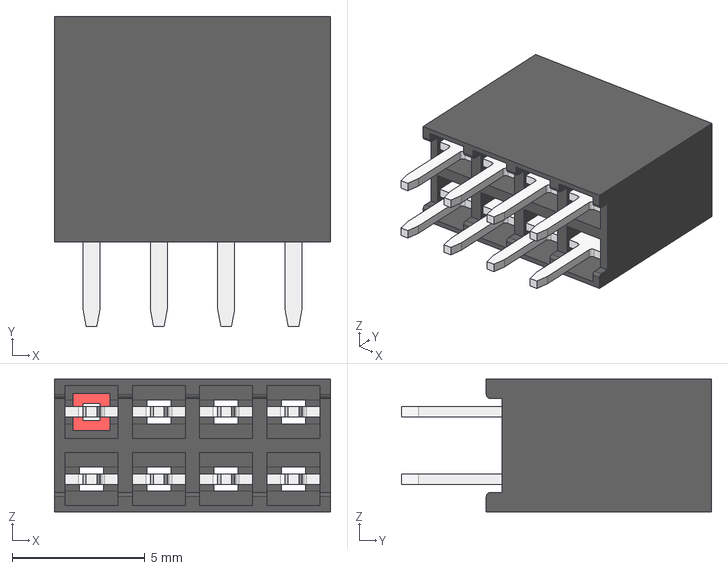
[picture p48: CAD file, 2025-10-08]
ARX Rev I/Project PCB Libraries/3D Models/Female Header 2x4_2.54 mm.stp
10.4 x 11.7 x 5.00 mm
