lwa-project/analog_receiver/ARX Rev I/Project PCB Libraries/3D Models/C_0805_2012Metric.step

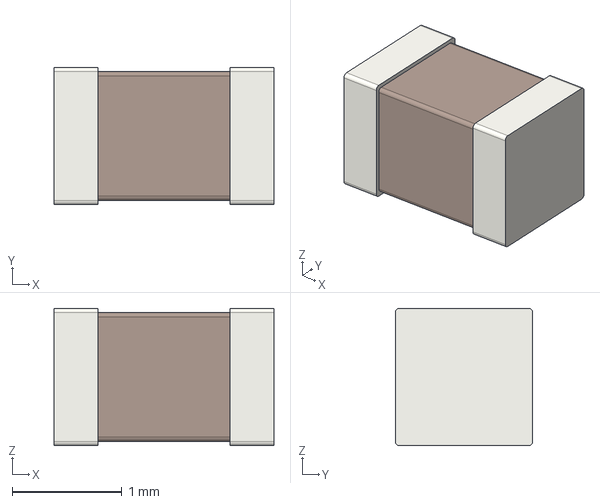
[picture p49: CAD file, 2025-10-08]
ARX Rev I/Project PCB Libraries/3D Models/C_0805_2012Metric.step
2.00 x 1.25 x 1.25 mm
