lwa-project/analog_receiver/ARX Rev I/Project PCB Libraries/3D Models/CONSMA020.062-G--3DModel-STEP-56544.STEP

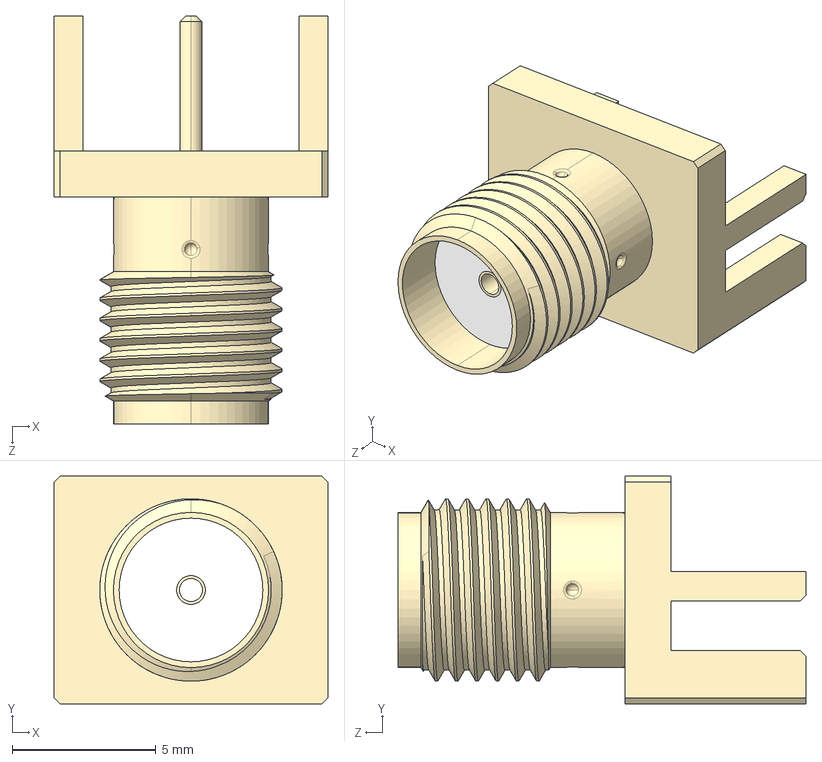
[picture p50: CAD file, 2025-10-08]
ARX Rev I/Project PCB Libraries/3D Models/CONSMA020.062-G--3DModel-STEP-56544.STEP
9.52 x 7.92 x 14.2 mm
