lwa-project/analog_receiver/ARX Rev I/Project PCB Libraries/3D Models/DG983-2.STEP

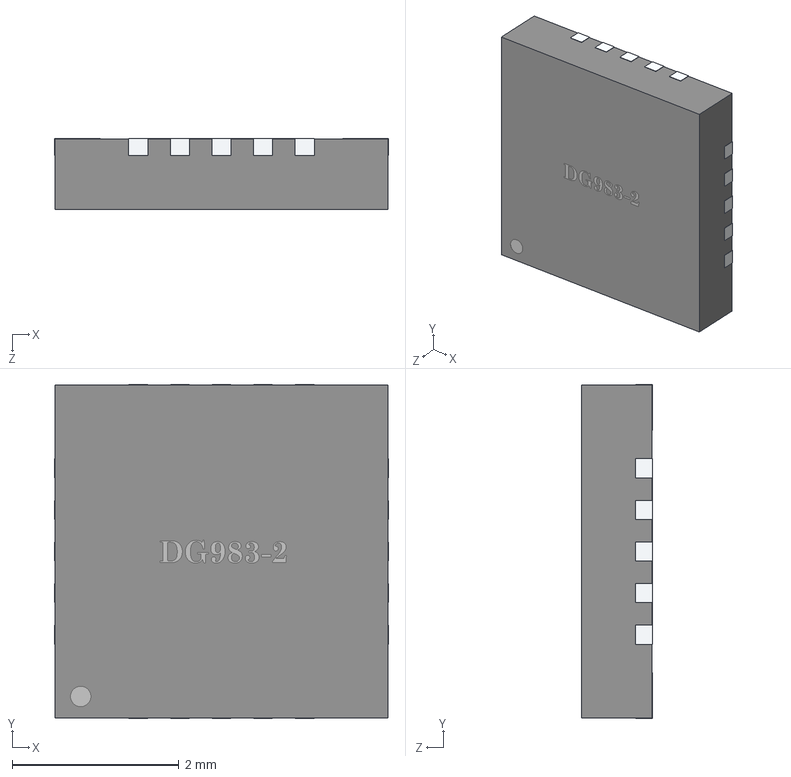
[picture p51: CAD file, 2025-10-08]
ARX Rev I/Project PCB Libraries/3D Models/DG983-2.STEP
4.01 x 4.01 x 0.855 mm
