lwa-project/analog_receiver/ARX Rev I/Project PCB Libraries/3D Models/b3fs-1012.stp

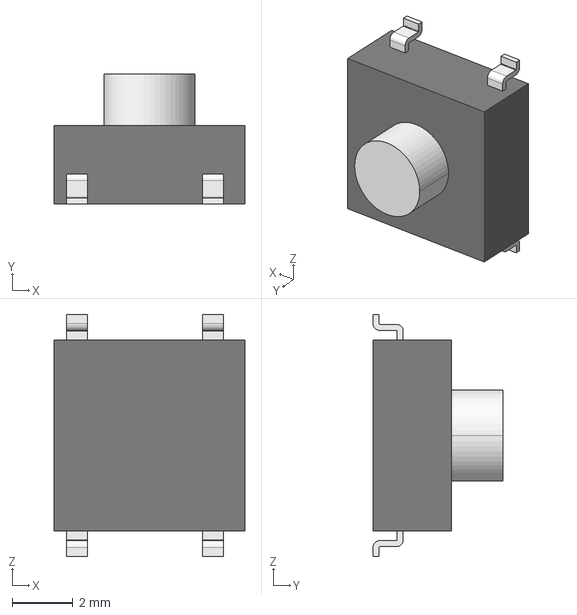
[picture p52: CAD file, 2025-10-08]
ARX Rev I/Project PCB Libraries/3D Models/b3fs-1012.stp
6.30 x 4.30 x 8.00 mm
