lwa-project/analog_receiver/ARX Rev I/Project PCB Libraries/3D Models/Coilcraft-1008PS.STEP

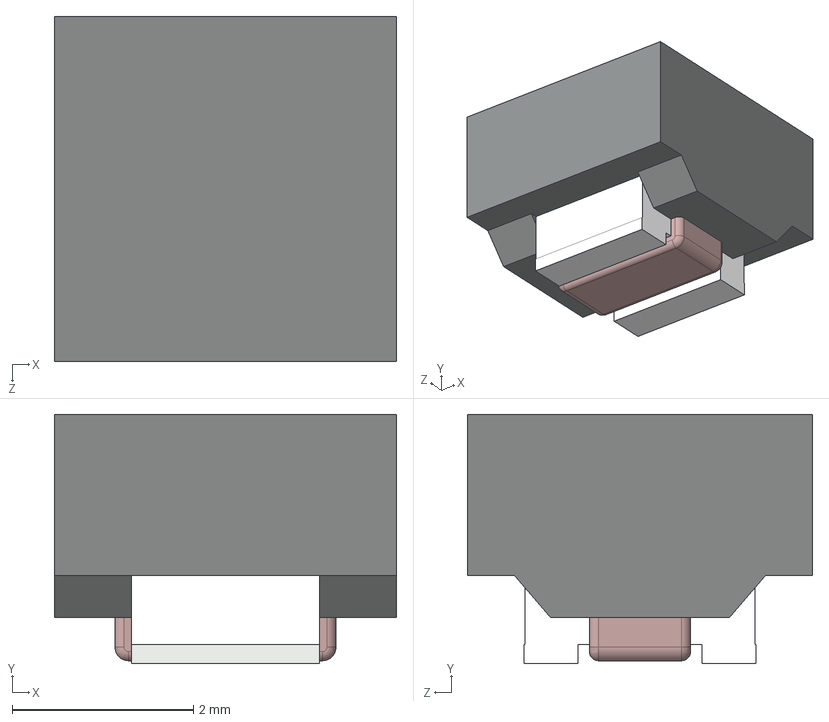
[picture p53: CAD file, 2025-10-08]
ARX Rev I/Project PCB Libraries/3D Models/Coilcraft-1008PS.STEP
3.78 x 2.75 x 3.81 mm
