lwa-project/analog_receiver/ARX Rev I/Project PCB Libraries/3D Models/Molex Power 431601104.stp

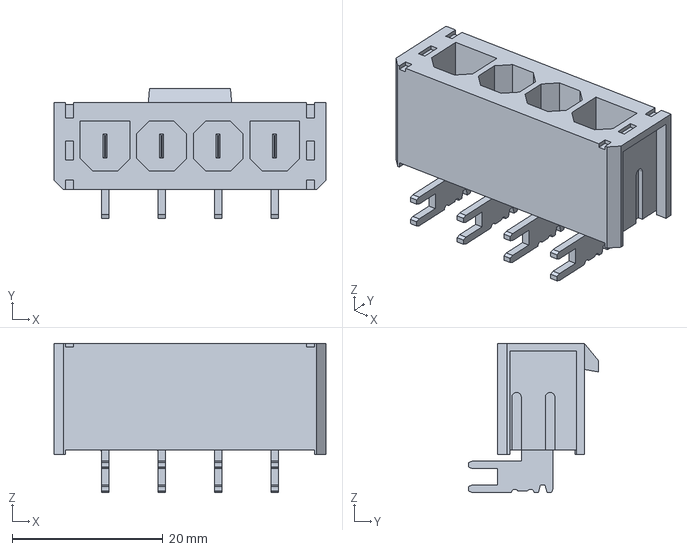
[picture p54: CAD file, 2025-10-08]
ARX Rev I/Project PCB Libraries/3D Models/Molex Power 431601104.stp
36.1 x 17.2 x 19.8 mm
