lwa-project/analog_receiver/ARX Rev I/Project PCB Libraries/3D Models/DB9M.stp

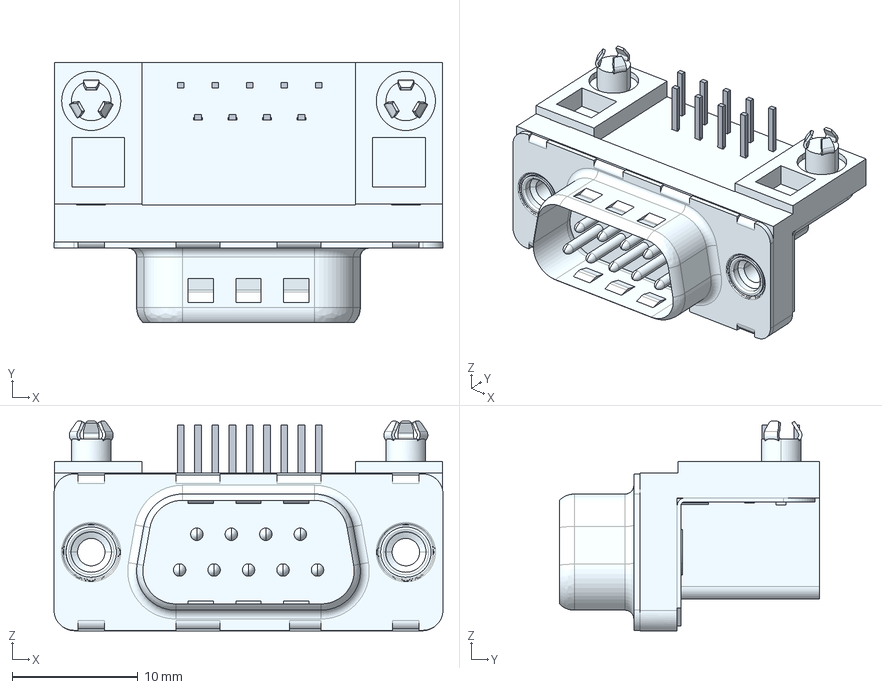
[picture p55: CAD file, 2025-10-08]
ARX Rev I/Project PCB Libraries/3D Models/DB9M.stp
30.9 x 20.7 x 16.6 mm
