lwa-project/analog_receiver/ARX Rev I/Project PCB Libraries/3D Models/C_1206_3216Metric.step

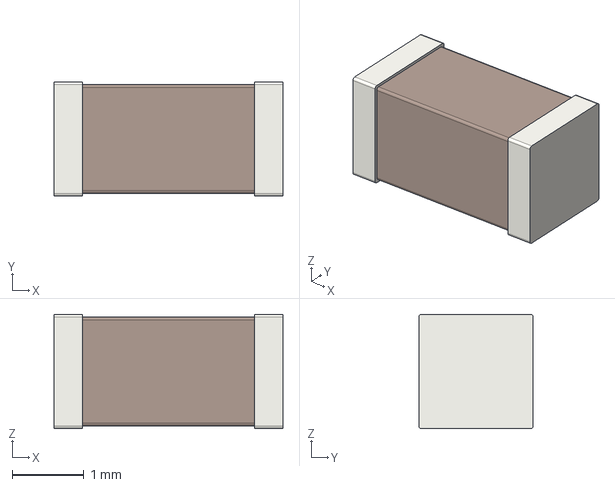
[picture p56: CAD file, 2025-10-08]
ARX Rev I/Project PCB Libraries/3D Models/C_1206_3216Metric.step
3.20 x 1.60 x 1.60 mm
