lwa-project/analog_receiver/(list of files, cad)

Other CAD files:
ARX Rev I/Project PCB Libraries/3D Models/022124042.stp
ARX Rev I/Project PCB Libraries/3D Models/431603104.stp
ARX Rev I/Project PCB Libraries/3D Models/431603106.stp
ARX Rev I/Project PCB Libraries/3D Models/459120007.stp
