lwa-project/analog_receiver/ARX Rev I/Documentation/Reports/ARX Coupling Capacitors Evaluation/ARX Coupling Capacitor Evaluation Final 17Sep2024.pdf

File: ARX Coupling Capacitor Evaluaon Final 17Sep2024.docx, Page 1

Coupling Capacitor Evaluaon Whitham D. Reeve

Coupling Capacitor Applicaon:
Coupling capacitors isolate components, such as RF switches, a&enuators and RF amplifiers, from undesired dc voltages. Ideally, a coupling capacitor has reactance that decreases with frequency throughout the desired frequency range according to 1/2πfC where C is the capacitance and f is the frequency. However, praccal capacitors have equivalent series resistance (ESR), equivalent series inductance (ESL), and a self-resonant frequency (SRF). The SRF is the frequency at which the capacive reactance equals (and cancels) the inducve reactance. At the SRF, the capacitor’s impedance equals the ESR and above the SRF, the capacitor has inducve reactance.

ARX Rev. G and Rev. H Coupling Capacitors:
For reference, the coupling capacitors used in the Rev. G ARX are 1000 pF (1 nF) whereas in the Rev. H ARX they are 0.1 μF (100 nF).

ARX Rev. I Requirements:
The design frequency range of the ARX is 3 to 100 MHz. The coupling capacitors are chosen to have ≤ 1 ohm impedance (≤ 2% of 50 ohms system impedance) at 3 MHz. The 1 ohm impedance is a tradeoff between large capacitors that have higher ESR and lower SRF and small capacitors with relavely high capacive reactance that would introduce impedance mismatching at the lower frequencies.

The simple circuit shown le? has 50 + j0 ohms source and load impedances and a capacitor with 0 – j1 ohms impedance (at 3 MHz) connecng them. The impedance seen by the source is 50 – J1 ohms and |Z| = 50.01 ohms. The return loss seen by the source at the juncon of the source and capacitor is 40 dB, indicang that the capacitor introduces negligible impedance mismatch. If the capacitor impedance is increased to 0 – j3 ohms, |Z| = 50.09 ohms and the return loss reduces to 30.5 dB.

At higher frequencies, the capacive reactance is (theorecally) lower and the return loss is higher. However, praccal capacitors have an SRF and inducve component at higher frequencies as shown below. Ideally, for the ARX applicaon, the capacitor SRF would be ≥ 100 MHz but this is not achievable with ordinary ceramic capacitors in the values required. The actual capacitors selected for the ARX are discussed in the next secon.

Selected Capacitors: The theorecal reactance at 3 MHz of a 0.047 μF (47 nF) capacitor is 1.1 ohms, slightly higher than the maximum given above; therefore, a value of 0.068 μF (68 nF) is selected, which has theorecal reactance of 0.78 ohms at 3 MHz. To protect the GALI-74+ amplifiers outputs from possible transient voltage damage, 5X to 10X larger capacitors are used on the amplifier outputs as recommended in the Mini-Circuits (MCL) applicaon note Transient Protec

on of Darlington Gain Block Amplifiers, page 10 (see References); note that these recommendaons are dated 2015 and MCL did not provide a definive answer to inquiries about the applicability of this recommendaon to current GALI-74+ products. Therefore, a conservave approach is taken

File: ARX Coupling Capacitor Evaluaon Final 17Sep2024.docx, Page 2 to ensure there are no problems. The selected value for the amplifier output coupling capacitors is 0.47 μF (7X the input capacitor value).

Refer to the master system block diagram in the Reports folder. The Rev. I ARX RF path contains 14 coupling capacitors, 11 with 0.068 μF capacitance and 3 with 0.47 μF capacitance. The goal is to find mul-layer ceramic capacitors (MLCC) that meet the reactance requirements from 3 to 100 MHz. All capacitors are size 0805, and a tolerance of ±10% and X7R dielectric are acceptable (capacitance variaon due to applied voltage is not expected to be important).

Manufacturers Evaluated:
Invesgaon of Kemet, Kyocera, Murata, TDK and Wurth showed that all ordinary ceramic capacitors in the desired capacitance ranges have SRF far below 100 MHz. However, these capacitors sll are usable if the reactance throughout the frequency range 3 to 100 MHz meets the 1 ohm requirement menoned above; in other words, the 2% impedance requirement must be achieved throughout the enre operang frequency range even though the SRF requirement cannot be met by available parts. It is noted that if the impedance requirement is met at the 3 and 100 MHz endpoints, it will be met at all frequencies in between because the transion from capacive to inducve reactance, and minimum impedance, occurs between the two endpoints for the capacitors being considered.

Silicon RF capacitors were invesgated and rejected because of their extremely high costs. Detailed frequencydependent data for MLCCs are available from capacitor manufacturers but, for most of them, the data are not readily accessible. TDK and Wurth Elektronik are excepons. Wurth data, including SRF plots and other data, were the easiest to access and use through their REDEXPERT online so?ware (see References). The analysis below is based on Wurth capacitors.

Wurth Capacitors:
Wurth manufacturers several types of MLCCs. Its line of WCAP-CSRF High Frequency capacitors is specifically designed for RF applicaons but are available with a maximum value of only 33 pF. However, its line of WCAP-CSGP General Purpose capacitors reaches 47 μF in a voltage rang of 16 Vdc and a temperature rang of –55 to +125 °C.

For the 0.068 μF capacitor, Wurth p/n 885012207044, the plo&ed impedance (below-le?) is 0.845 ohms at 3 MHz and 0.181 ohms at 100 MHz. For the 0.47 μF capacitor, p/n 885012207049, the plo&ed impedance (below-right) is 0.129 ohms at 3 MHz and 0.176 ohms at 100 MHz. These two capacitors meet the requirements previously stated.

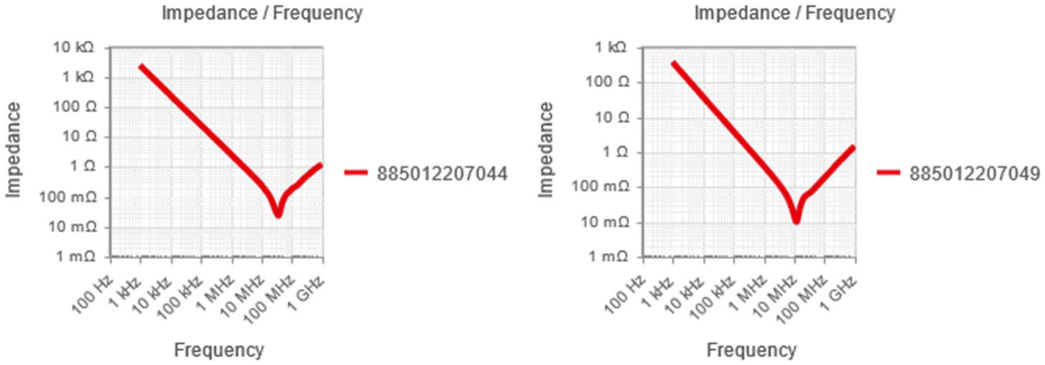
[picture p60: figure]
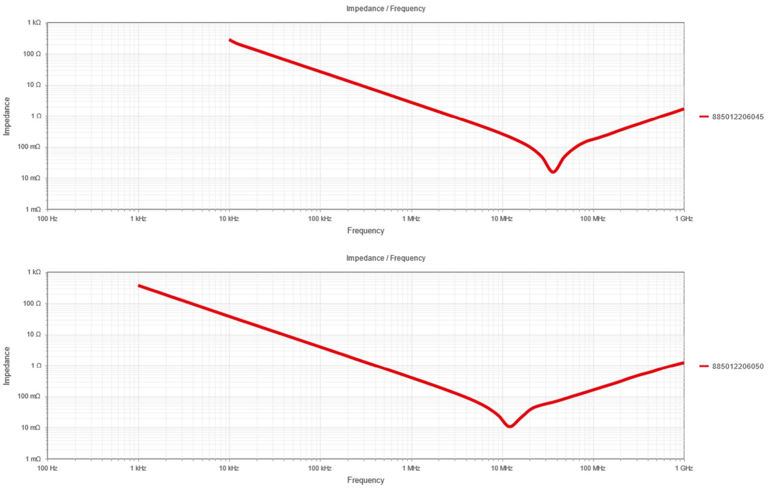
[picture p61: figure]

File: ARX Coupling Capacitor Evaluaon Final 17Sep2024.docx, Page 3

The Wurth capacitors in 0603, 16 Vdc, X7R and ±10% tolerance also were examined. These capacitors have a smaller footprint and less pad capacitance than the 0805 sizes. The plo&ed impedance for the 0.068 μF capacitor in 0603, p/n 885012206045 (upper image below) is 0.851 ohms at 3 MHz and 0.180 ohms at 100 MHz. For the 0.47 μF capacitor in 0603, p/n 885012206050, the plo&ed impedance (lower image below) is 0.124 ohms at 3 MHz and 0.165 ohms at 100 MHz. These two capacitors meet the requirements previously stated.

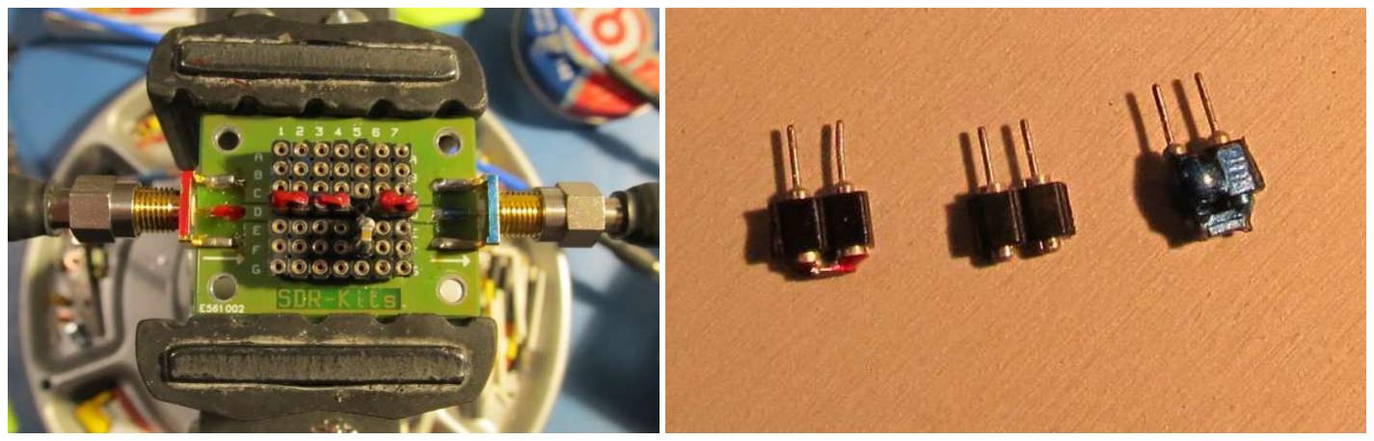
[picture p62: figure]
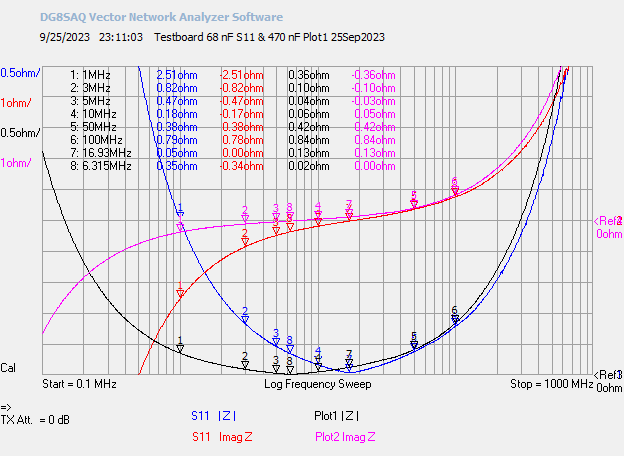
[picture p63: figure]

File: ARX Coupling Capacitor Evaluaon Final 17Sep2024.docx, Page 4

Measurements: Samples of the 0.068 and 0.47 μF capacitors in size 0805 were obtained and measured in a simple shop-built test fixture with a DG8SAQ VNWA vector network analyzer. S-parameter and equivalent impedance measurements and inseron loss were made over the frequency range 100 kHz to 1000 MHz.

The test fixture was made from a PCB with SMA connectors and 0.1 inch pitch socket strips (below-le? with a capacitor under test). A plug-in fixture like this has some inherent variability but does provide sufficient accuracy for the comparisons with factory capacitor measurements. The calibraon components (Short, Open, Load, Thru) and capacitors were soldered to 2-pin pin strips (below-right).

The sockets and pin strips allow easy calibraon and the capacitors to be installed in both shunt and series configuraons. In the shunt configuraon, the primary measurement was S11 reflecon coefficient displayed as impedance magnitude |Z| and imaginary impedance ImagZ in ohms. In the series configuraon, the primary measurement was S21 transmission coefficient displayed in dB. The plots below show |Z| and ImagZ in the upper plot and S21 in the lower plot.

The blue trace in the is
the impedance
magnitude |Z| and the
red trace is the reactance ImagZ of the 68 nF
capacitor and the black
and magenta traces are
of the 470 nF capacitor.

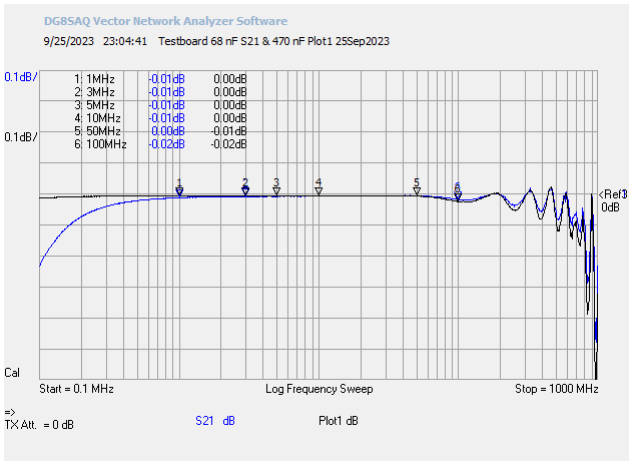
[picture p64: figure]

File: ARX Coupling Capacitor Evaluaon Final 17Sep2024.docx, Page 5

The blue and black traces
are the transmission
coefficients (S21) in dB of the 68 nF and 470 nF
capacitors, respecvely.

The vercal scale per division for each trace is shown along the upper-le? edge. The frequency range is shown along the bo&om horizontal scale as Start and Stop frequencies. Note that the Wurth plots in the previous secon use a logarithmic vercal scale whereas the measurements use a linear vercal scale.

The transions from capacive to inducve reactance for both capacitors are clearly seen at the center of the dips in |Z| and zero values for ImagZ. The SRF of the 68 nF capacitor is approximately 16.9 MHz (marker 7) and of the 470 nF cap is approximately 6.3 MHz (marker 8), very similar to the Wurth data. The measured reactance of the Wurth 68 nF capacitor at 1 MHz is –j2.51 ohms (red marker 1), equivalent to a capacitance of 63.4 nF, and comparable to –j2.58 ohms from the Wurth data. Similarly, the measured reactance of the Wurth 470 nF capacitor is –j0.36 ohms (magenta marker 1) at 1 MHz, equivalent to a capacitance of 44.2 nF and comparable to –j0.38 ohms from the Wurth data.

References:
- Mini-Circuits, APPLICATION NOTE: Transient Protecon of Darlington Gain Block Amplifiers, AN-60-034 Rev. : A M150261 (04/14/15) File: AN60034.DOC
- Wurth Elektronik REDEXPERT website: h&ps://redexpert.we-online.com/we-redexpert/en/#/redexpertembedded

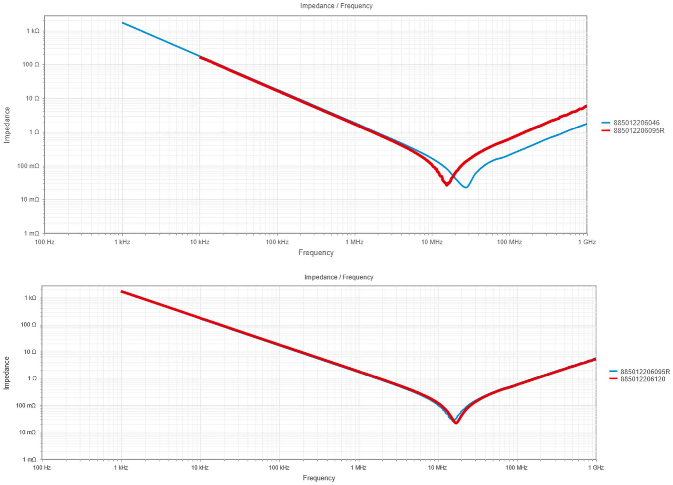
[picture p65: figure]

File: ARX Coupling Capacitor Evaluaon Final 17Sep2024.docx, Page 6

Addendum ~ 17 September 2024:

Increasing the input coupling capacitors from 0.068 to 0.100 μF was considered during Prototype tesng to determine if the original capacitors affected the input impedance. Three Wurth capacitors were considered with voltage rangs of 16 V, 50 V and 100 V as follows:
p/n 885012206046: 0.100 μF, 0603, 16 Vdc, X7R, ±10% tolerance
p/n 885012206095R: 0.100 μF, 0603, 50 Vdc, X7R, ±10% tolerance
p/n 885012206120: 0.100 μF, 0603, 100 V, X7R, ±10% tolerance.

Note that all X7R capacitors are subject to capacitance change due to their operang environment – parcularly bias voltage and temperature – but this is not considered a factor in their applicaon here.

The plo&ed impedance of the 16 V 0.100 μF capacitor (blue trace in image directly below) is approximately 0.538 ohms at 3 MHz and 0.195 ohms at 100 MHz. The plo&ed impedance of the 50 V 0.100 μF capacitor (red trace in image directly below) is approximately 0.538 ohms at 3 MHz and 0.647 ohms at 100 MHz. The plo&ed impedance of the 100 V 0.100 μF capacitor(red trace in the bo&om image) is approximately the same at both frequencies.

File: ARX Coupling Capacitor Evaluaon Final 17Sep2024.docx, Page 7

All three capacitors meet the requirements previously stated (≤ 1 ohm impedance at high and low frequencies). The 100 V part is recommended for the input circuit because it is exposed to the 15 Vdc FEE voltage and transients from the outside plant; the 100 V rang provides addional margin.

File: ARX Coupling Capacitor Evaluaon Final 17Sep2024.docx, Page 8

Document Informaon
Author: Whitham D. Reeve
Revisions: 0.0 (Original dra? started, 05 Sep 2023) 0.1 (Added Wurth capacitor data, 07 Sep 2023)
0.2 (Corrected p/n for the Wurth 0.068 μF capacitor, 15 Sep 2023) 0.3 (Added measurements, 25 Sep 2023)
0.4 (Added test fixture images & descripon, 26 Sep 2023)
0.5 (Distribuon, 29 Sep 2023)
0.6 (Added plots and impedances for 0603 Wurth capacitors, 5 Dec 2023) 0.7 (Addendum for 0.100 μF capacitors, 17 Sep 2024)

Word count: 1340
File size (bytes): 3210314
