lwa-project/analog_receiver/ARX Rev I/Documentation/Reports/ARX PCB Stackup Evaluation/ARX Board Stackup Evaluation 07Dec2023.pdf

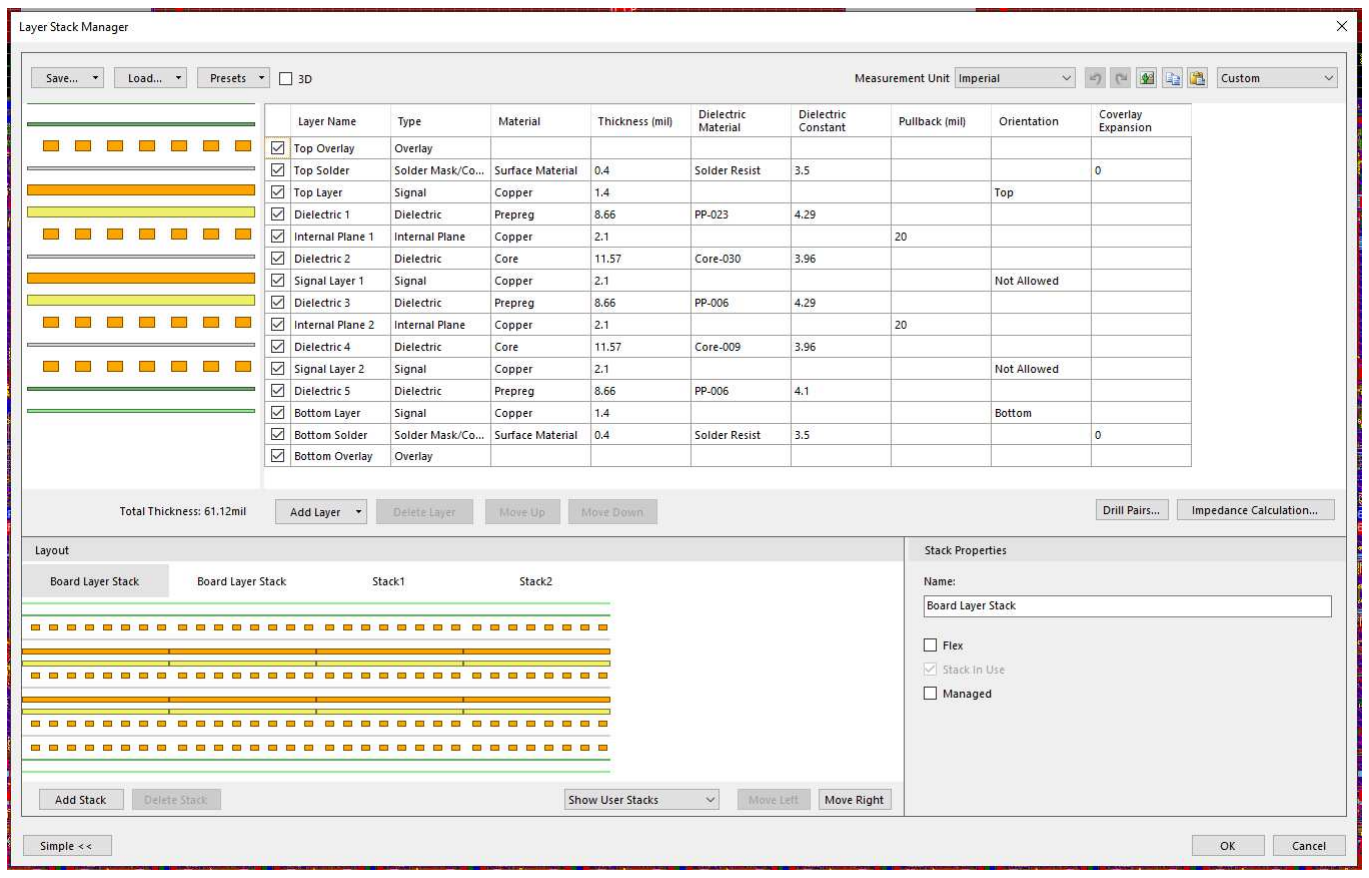
[picture p88: figure]

File: Board Stackup Evaluaon.docx, Page 1

### Board Stackup Evaluaon

### PCB Layering:

The Rev. F (and presumably G) uses a 4-layer PCBs and Rev. H uses a 6-layer. Because of the need for diagnoscs and associated roung, a 6-layer PCB will be used for Rev. I, similar to Rev. H.

### Stackup comparison:

The Rev. H stackup is shown below based on the Alum files.

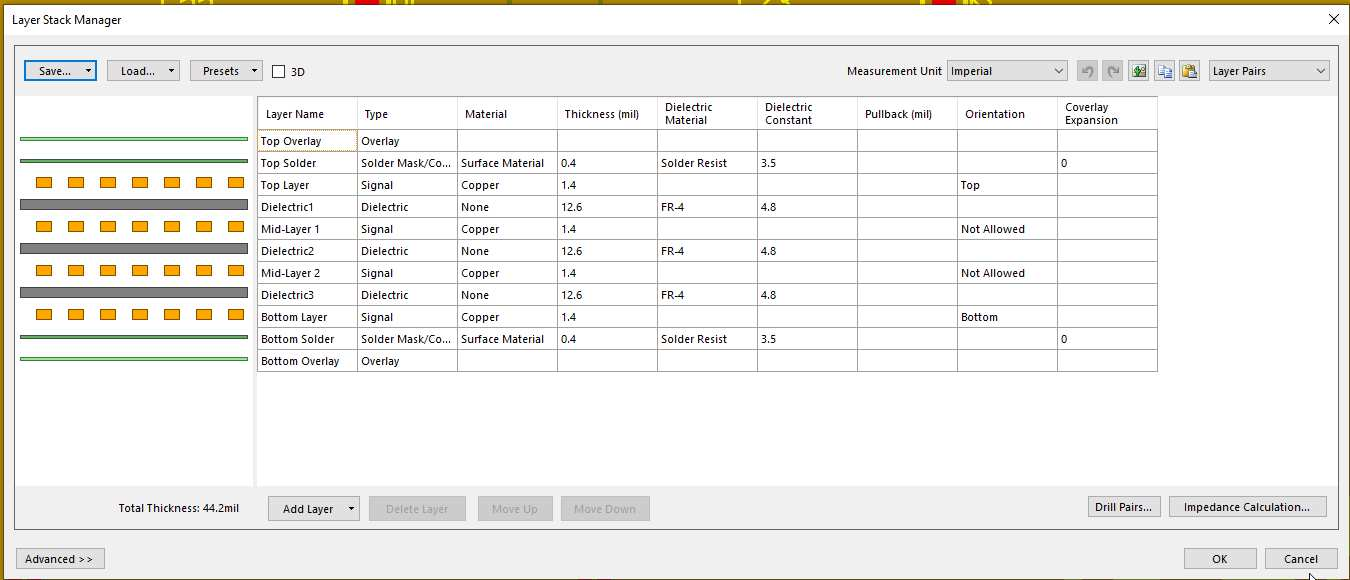
[picture p89: figure]

File: Board Stackup Evaluaon.docx, Page 2

Although it will not be used, the Rev. F stackup is shown below for reference.

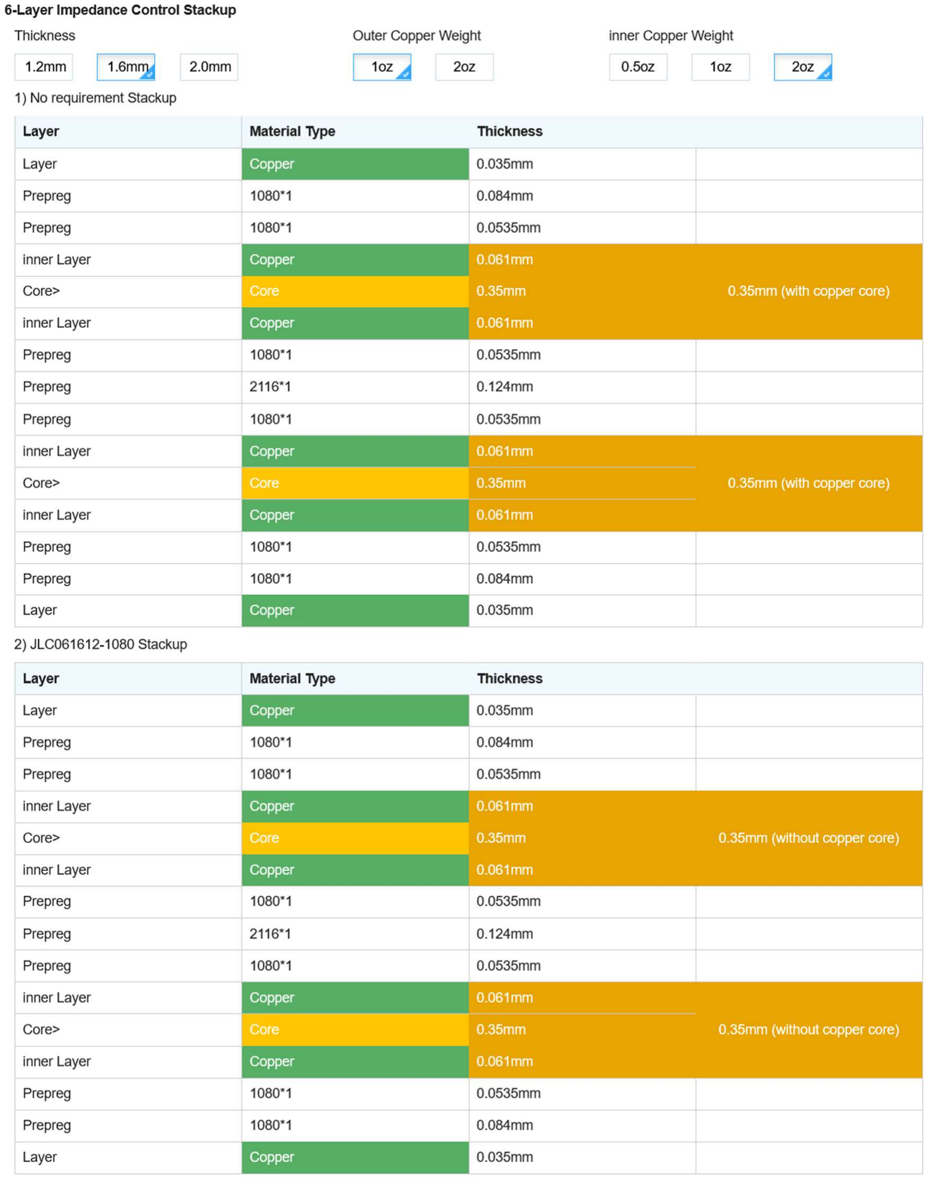
[picture p90: figure]

File: Board Stackup Evaluaon.docx, Page 3

### Rev. I PCB manufacturing:

JLCPCB manufactured the PCBs for Filter Evaluaon and the products were sasfactory, so they were invesgated for manufacturing the ARX Rev. I prototype PCBs. The PCBs will be 6-layer, 1.6 mm thick with 1 oz copper on the outer layers and 2 oz copper on the inner layers. JLCPCB has only one “Impedance Controlled” 6-layer stackup for the required configuraon as shown below. Note that the “No requirement stackup” is idencal to the “JLC061612-1080 stackup”.

File: Board Stackup Evaluaon.docx, Page 4

### Comparison of Rev. H ARX 6-layer stackup with JLCPCB 6-layer stackup:

Rev. H | JLCPCB | JLC061612-1080 Stackup
Layer name | Type | Material | Thickness (mil) | Dielectric material | Dielectric constant | Layer | Material | Thickness (mil) | Dielectric constant
Top overlay | Overlay
Top solder | Soldermask | Surface material | 0.4 | Solder resist | 3.5 | Coating | C2 | 0.6 | 3.8
Top layer | Signal | Copper | 1.4 | | | Signal | Copper | 1.38
Dielectric 1 | Dielectric | Prepreg | 8.66 | PP-023 | 4.29 | Dielectric | Prepreg | 5.4 | 3.91
Internal plane 1 | Internal plane | Copper | 2.1 | | | Internal plane | Copper | 2.4
Dielectric 2 | Dielectric | Core | 11.57 | Core-030 | 3.96 | Dielectric | Core | 13.78 | 4.6
Signal layer 1 | Signal | Copper | 2.1 | | | Signal | Copper | 2.4
Dielectric 3 | Dielectric | Prepreg | 8.66 | PP-006 | 4.29 | Dielectric | Prepreg | 9.1 | 3.91 + 4.16 + 3.91
Internal plane 2 | Internal plane | Copper | 2.1 | | | Internal plane | Copper | 2.4
Dielectric 4 | Dielectric | Core | 11.57 | Core-009 | 3.96 | Dielectric | Core | 13.78 | 4.6
Signal layer 2 | Signal | Copper | 2.1 | | | Signal | Copper | 2.4
Dielectric 5 | Dielectric | Prepreg | 8.66 | PP-006 | 4.1 | Dielectric | Prepreg | 5.4 | 3.91
Bottom layer | Signal | Copper | 1.4 | | | Signal | Copper | 1.38
Bottom solder | Soldermask | Surface material | 0.4 | Solder resist | 3.5 | Coating | C2 | 0.6 | 3.8
Bottom overlay | Overlay
| | Total thickness | 61.12 | | | | Total thickness | 61.02

File: Board Stackup Evaluaon.docx, Page 5

### Document Informaon

### Author: Whitham D. Reeve

### Revisions: 0.0 (Original draC started, 07 Dec 2023)

### Word count: 357

### File size (bytes): 2489429
