lwa-project/analog_receiver/ARX Rev I/Documentation/Mechanical Details/ARX Rev. F RF Connector Cabling Holes.pdf

H

G

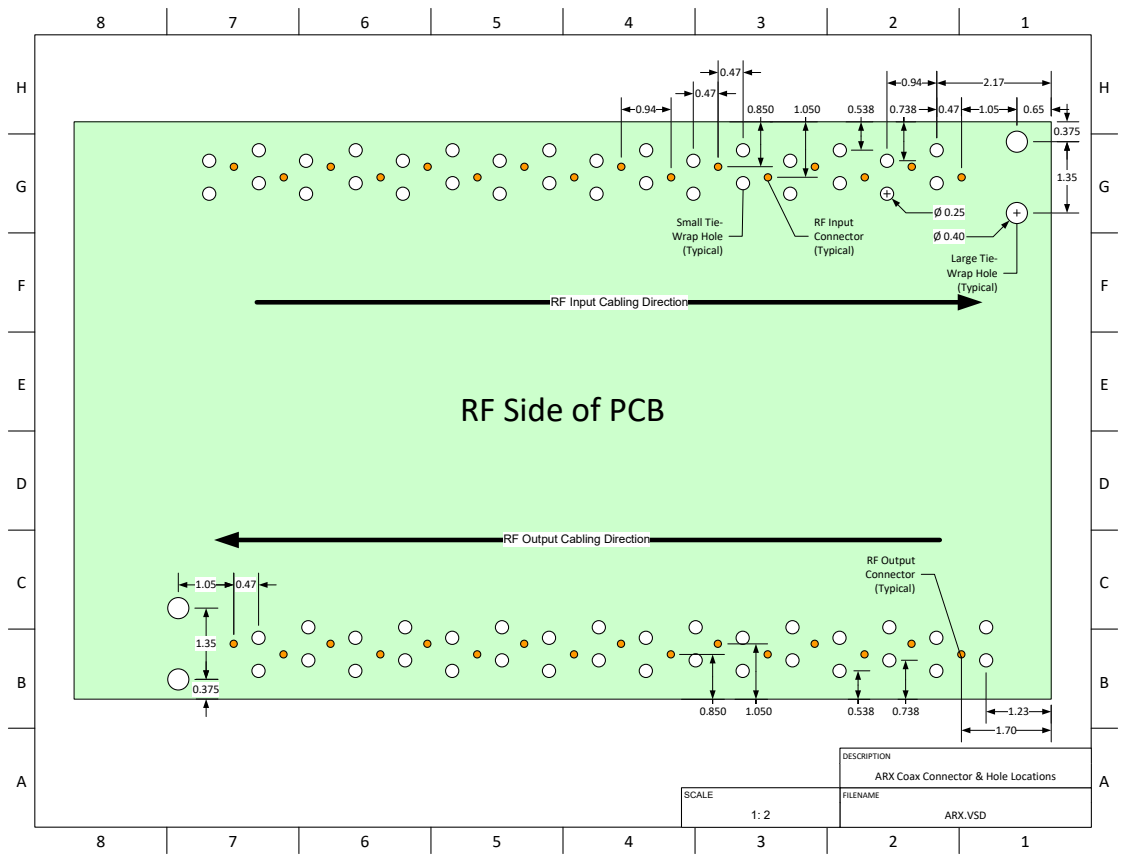
[picture p95: page 1]
FILENAME; ARX.VSD; RF Input Connector; (Typical); Large Tie-; Wrap Hole (Typical); Small Tie- Wrap Hole (Typical); RF Output Connector (Typical); SCALE

RF Input Cabling Direction

RF Side of PCB

RF Output Cabling Direction

DESCRIPTION
ARX Coax Connector & Hole Locations
