lwa-project/analog_receiver/ARX Rev I/Documentation/Rev H PDF Files/ARX_RevH-schematics20210725.pdf

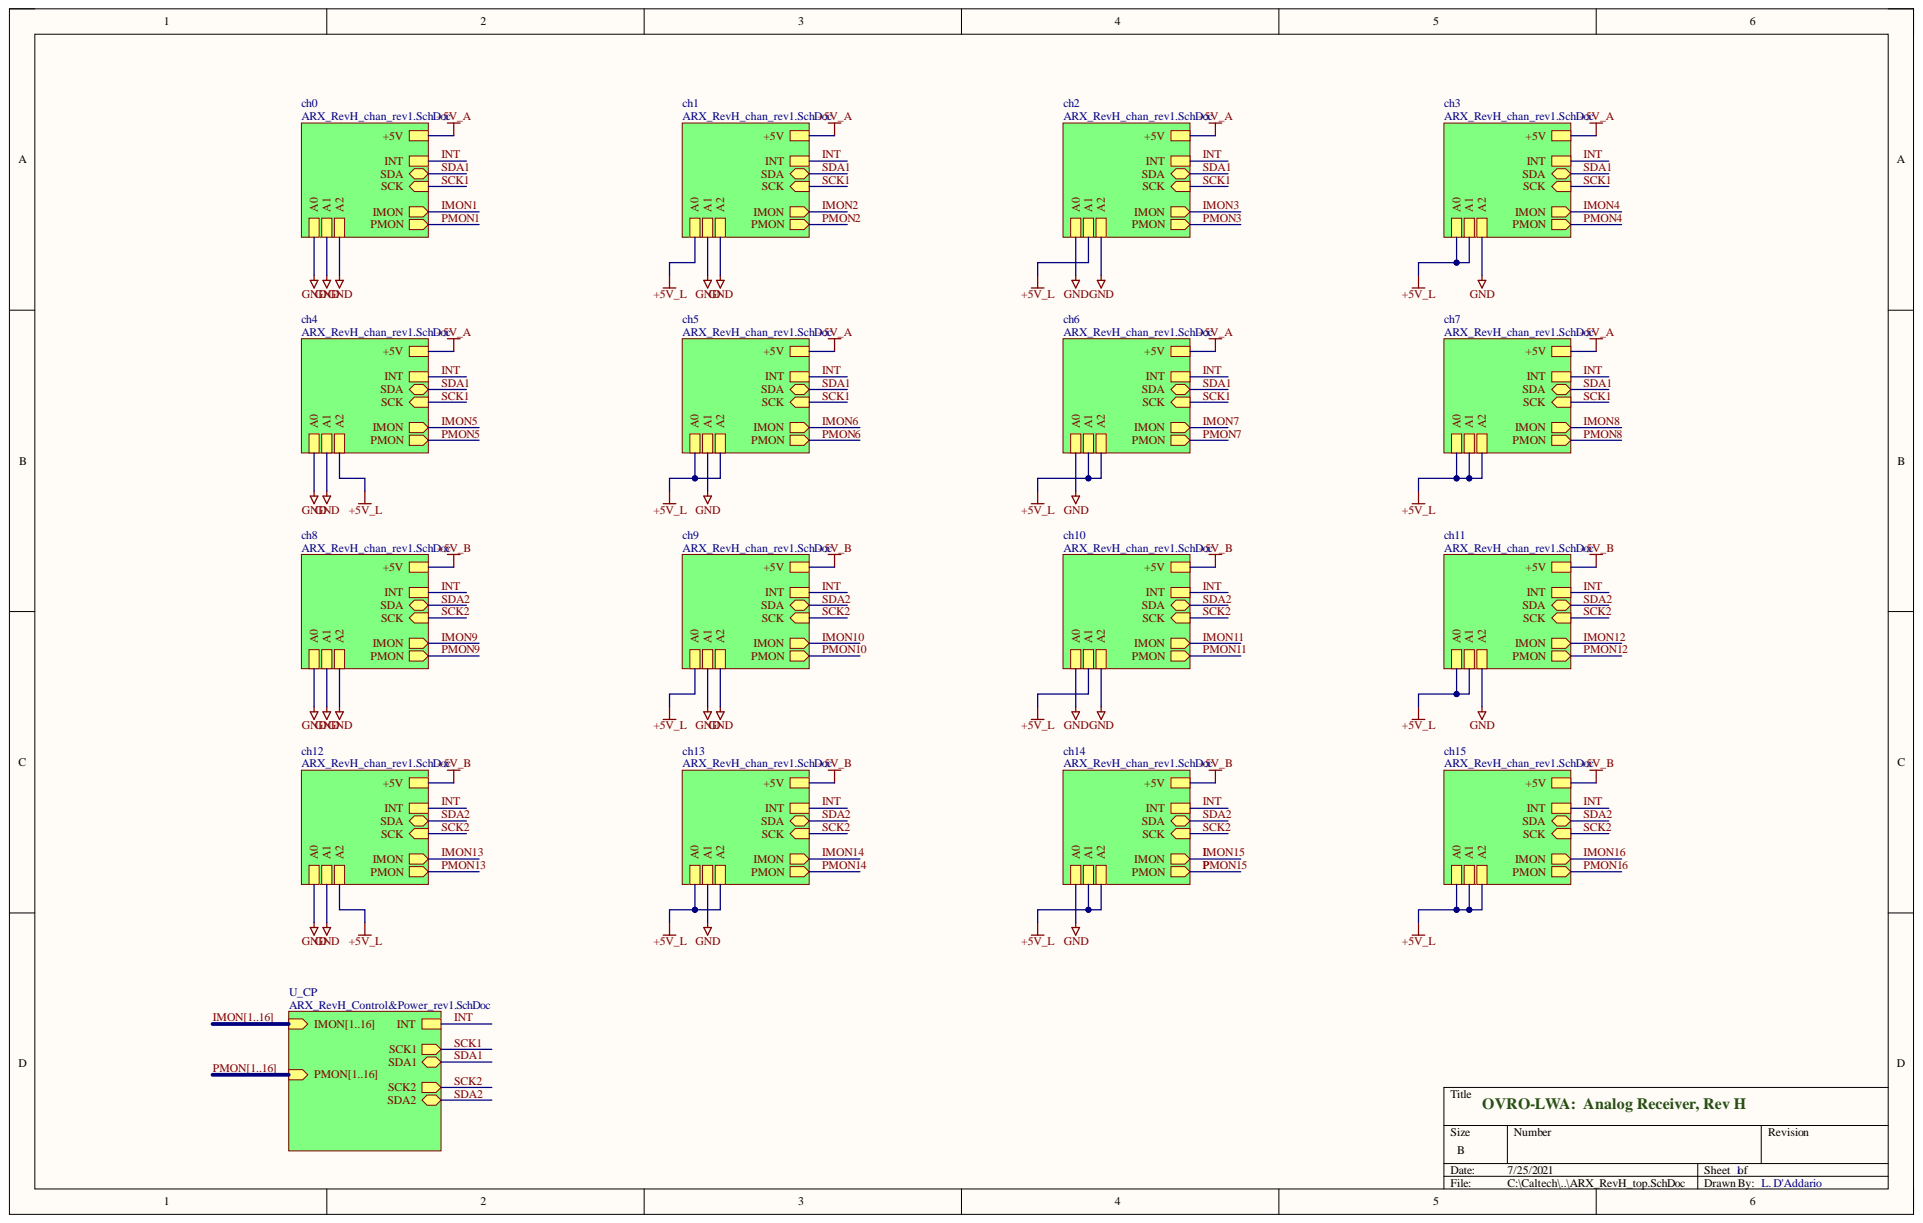
[picture p96: page 1]

Title
OVRO-LWA: Analog Receiver, Rev H

Size B | Number | Revision

Date: 7/25/2021 | Sheet of 1
File: C:\Caltech\..\ARX_RevH_top.SchDoc | Drawn By: L. D'Addario

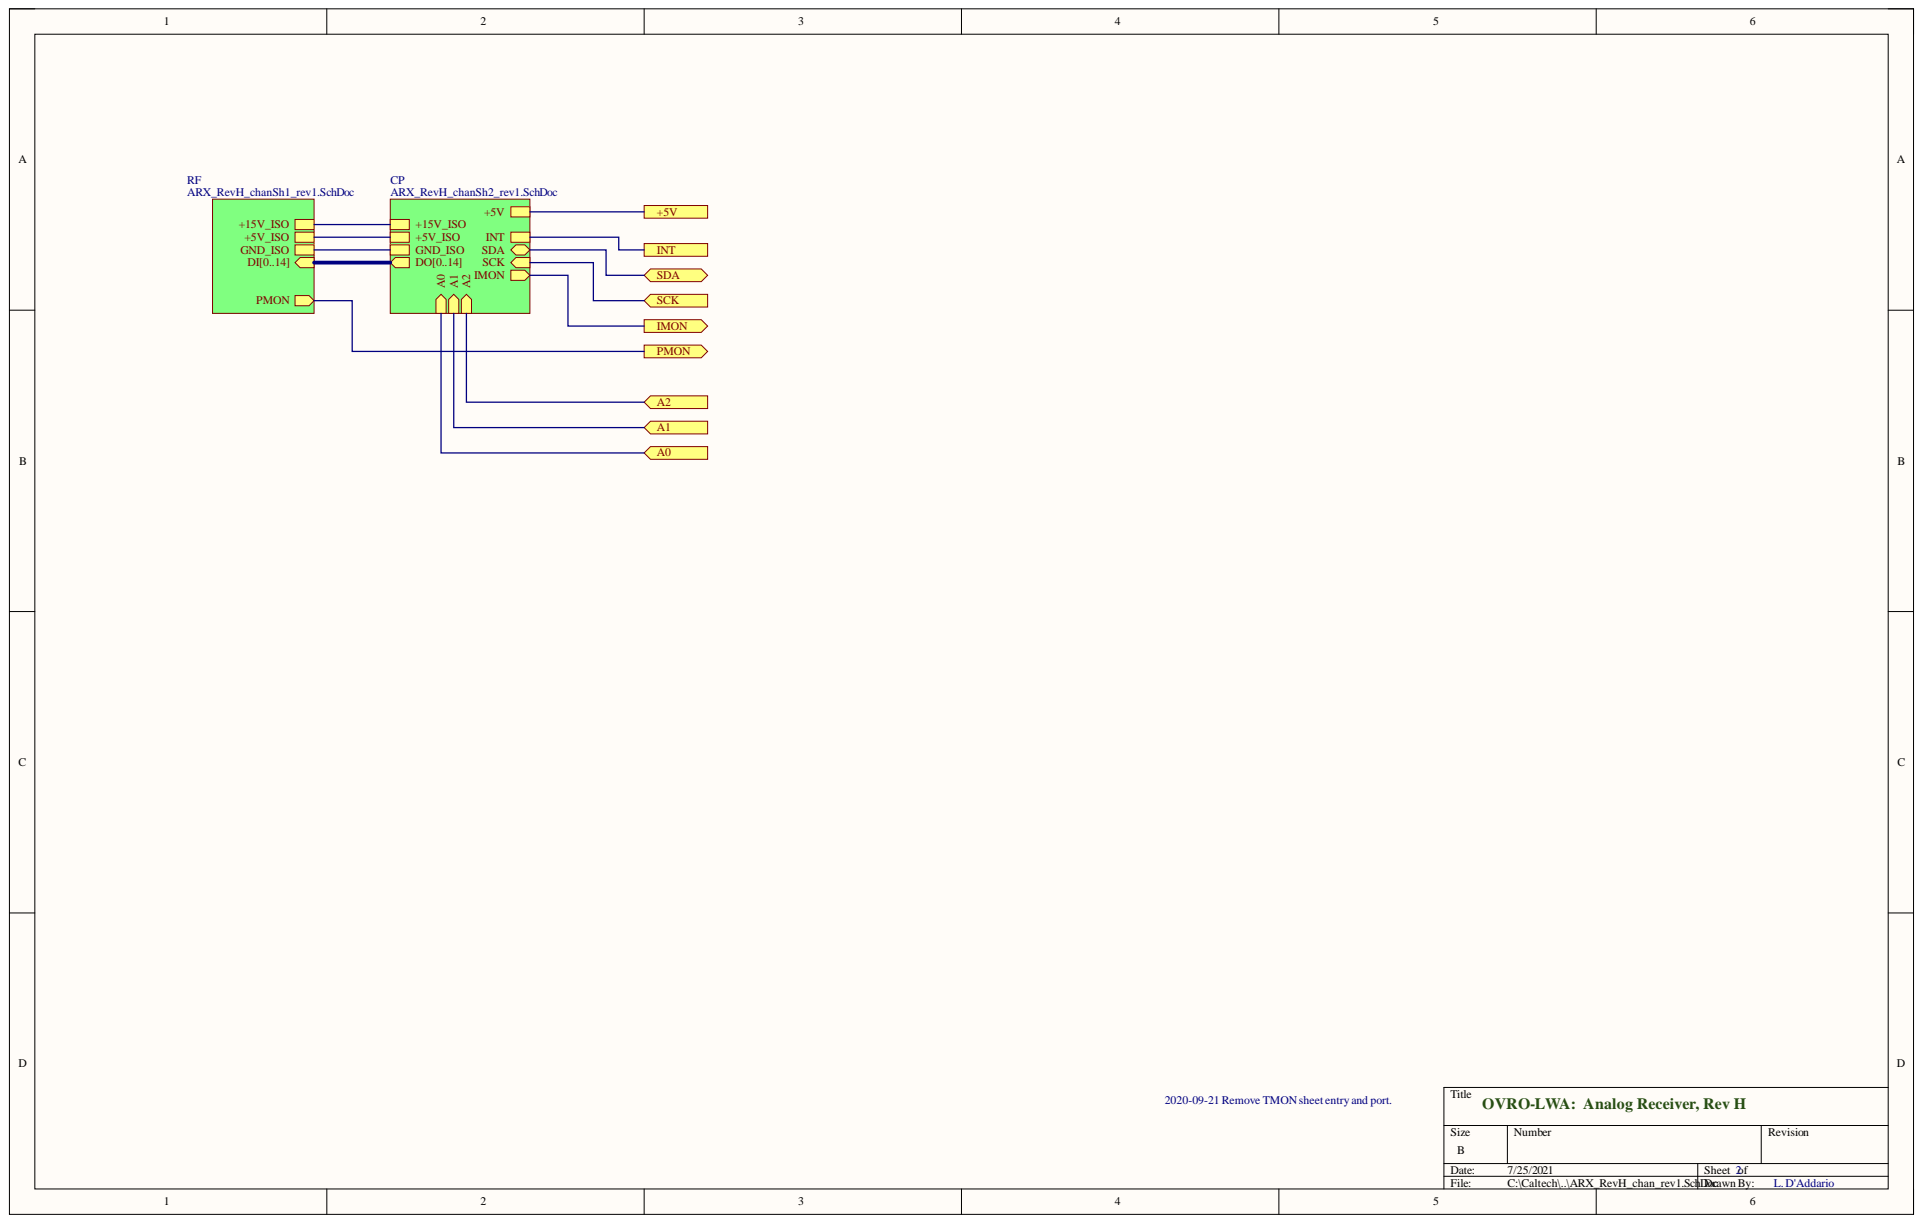
[picture p97: page 2]

2020-09-21 Remove TMONsheet entry and port.

Title
OVRO-LWA: Analog Receiver, Rev H

Size B | Number | Revision

Date: 7/25/2021 | Sheet of 2
File: C:\Caltech\..\ARX_RevH_chan_rev1.SchDDorcawn By: | L. D'Addario

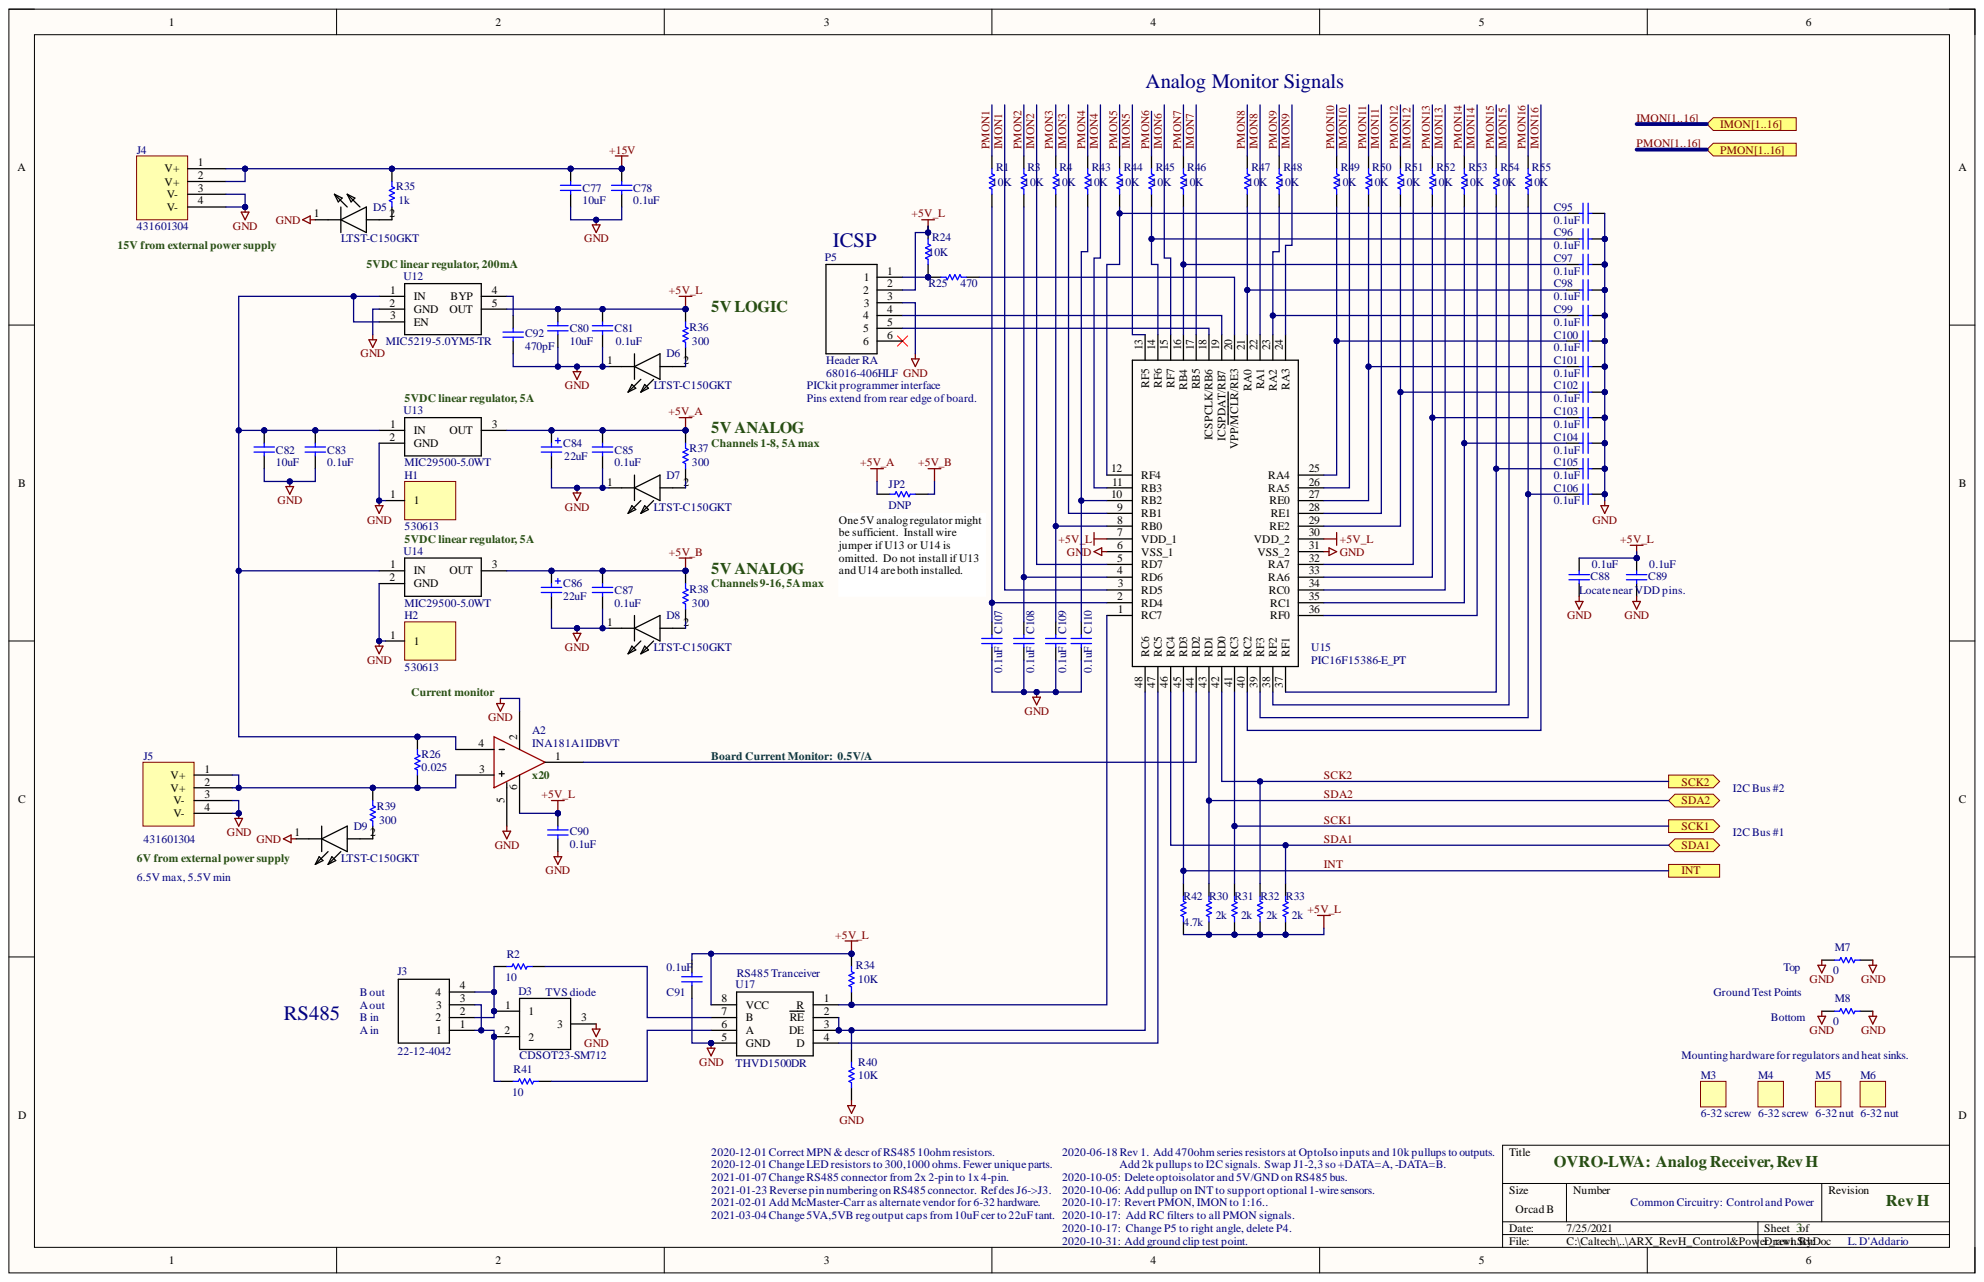
[picture p98: page 3]

15V from external power supply

Header RA
68016-406HLF
PICkit programmer interface
Pins extend from rear edge of board.

One 5V analog regulator might
be sufficient. Install wire
jumper if U13 or U14 is
omitted. Do not install if U13
and U14 are both installed.

Board Current Monitor: | GND 0.5V/A

SDA2

SCK1

6V from external power supply

INT
+5V_L | INT

Mounting hardware for regulators and heat sinks.

2020-12-01 Correct MPN & descr ofRS485 10ohm resistors.
2020-12-01 ChangeLED resistorsto 300,1000 ohms. Fewer unique parts.
2021-01-07 ChangeRS485 connector from 2x 2-pin to 1x 4-pin.
2021-01-23 Reverse pin numbering on RS485 connector. Ref desJ6->J3.
2021-02-01 Add McMaster-Carr as alternate vendor for 6-32 hardware.
2021-03-04 Change 5VA,5VB reg output capsfrom 10uF cer to 22uF tant.

2020-06-18 Rev 1. Add 470ohm seriesresistors at OptoIso inputs and 10k pullupsto outputs.

Title
OVRO-LWA: Analog Receiver, Rev H

2020-10-05: Delete optoisolator and 5V/GND on RS485 bus.
2020-10-06: Add pullup on INT to support optional 1-wire sensors.
2020-10-17: Revert PMON, IMON to 1:16..
2020-10-17: Add RC filters to all PMON signals.
2020-10-17: Change P5 to right angle, delete P4.
2020-10-31: Add ground clip test point.

Add 2k pullupsto I2C signals. Swap J1-2,3 so +DATA=A, -DATA=B.

Size Orcad B | Number Common Circuitry: Control and Power | Revision Rev H

Date: 7/25/2021 | Sheet of 3
File: C:\Caltech\..\ARX_RevH_Control&PoweDr_rraewv1n.SBcyh:Doc | L. D'Addario

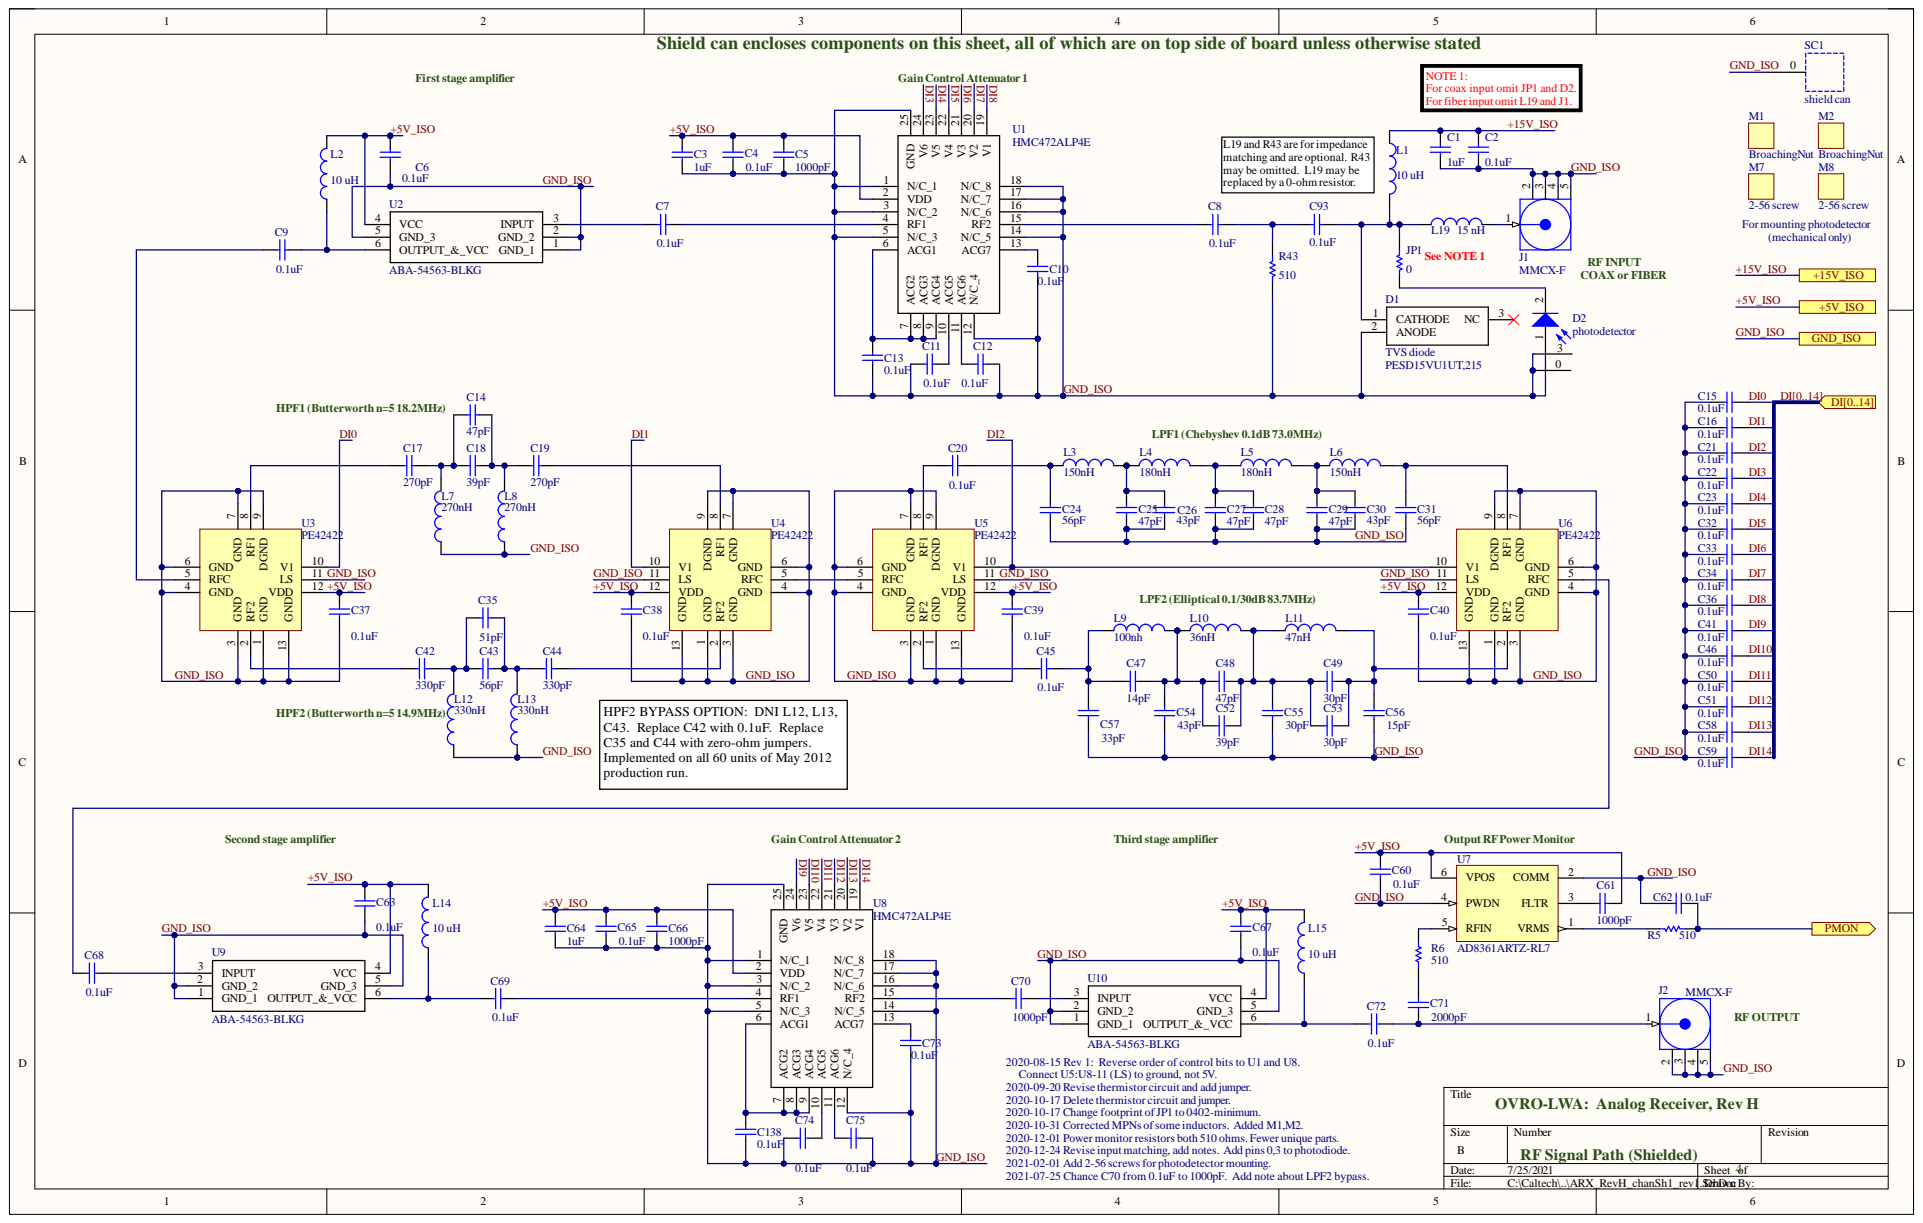
[picture p99: page 4]

Shield can encloses components on this sheet, all of which are on top side of board unless otherwise stated

NOTE 1:
For coax input omit JP1 and D2.
Forfiberinput omit L19 and J1.

L19 and R43 are forimpedance
matching and are optional. R43
may be omitted. L19 may be
replaced by a 0-ohm resistor.

OUTPUT_&_VCC 6 GND_3 5 VCC 4 | | | | | N/C_3 5 | 510

GND 3 GND 4 RFC 5 GND G

HPF2 BYPASS OPTION: DNI L12, L13,
C43. Replace C42 with 0.1uF. Replace
C35 and C44 with zero-ohm jumpers.
Implemented on all 60 units of May 2012
production run.

2020-08-15 Rev 1: Reverse order of control bits to U1 and U8.
Connect U5:U8-11 (LS) to ground, not 5V.
2020-09-20 Revise thermistor circuit and add jumper.
2020-10-17 Delete thermistor circuit and jumper.
2020-10-17 Change footprint ofJP1 to 0402-minimum.
2020-10-31 Corrected MPNs ofsome inductors. Added M1,M2.
2020-12-01 Power monitorresistors both 510 ohms. Fewer unique parts.
2020-12-24 Revise inputmatching, add notes. Add pins 0,3 to photodiode.
2021-02-01 Add 2-56 screwsfor photodetector mounting.
2021-07-25 Chance C70 from 0.1uF to 1000pF. Add note about LPF2 bypass.

OVRO-LWA: Analog Receiver, Rev H

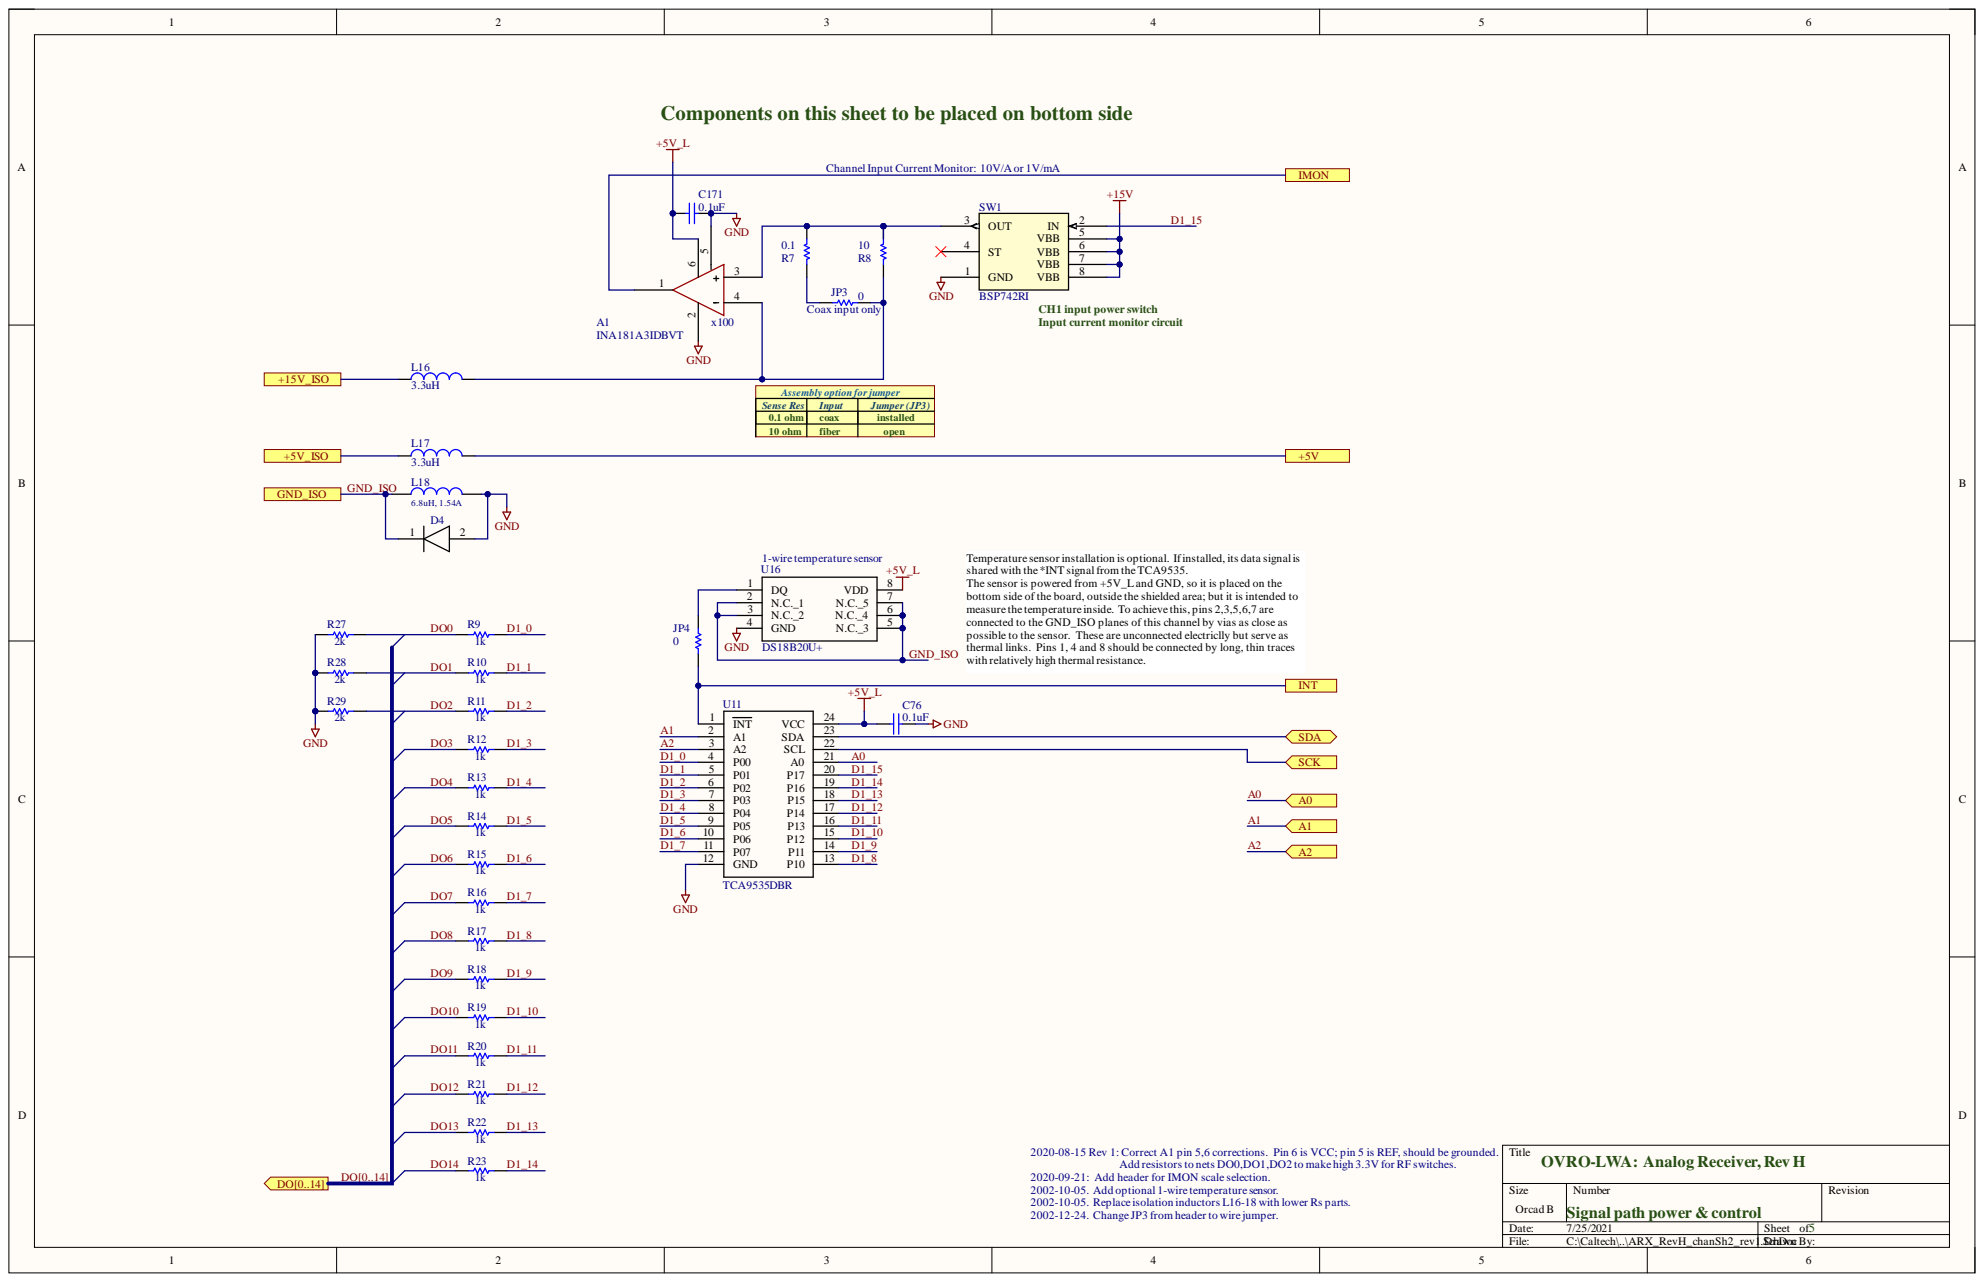
[picture p100: page 5]

Components on this sheet to be placed on bottom side

ChannelInput Current Monitor: 10V/Aor 1V/mA

CH1 input power switch
Input current monitor circuit

Sense Res | Input | Jumper (JP3)
0.1 ohm | coax | installed
10 ohm | fiber | open

Assembly option for jumper

Temperature sensor installation is optional. Ifinstalled, its data signal is
shared with the *INT signalfrom theTCA9535.
The sensor is powered from +5V_Land GND, so it is placed on the
bottom side of the board, outside the shielded area; but it is intended to
measure the temperature inside. To achieve this, pins 2,3,5,6,7 are
connected to the GND_ISO planes of this channel by vias as close as
possible to the sensor. These are unconnected electriclly but serve as
thermal links. Pins 1, 4 and 8 should be connected by long, thin traces
with relatively high thermalresistance.

GND 4

2020-08-15 Rev 1: Correct A1 pin 5,6 corrections. Pin 6 is VCC; pin 5 is REF, should be grounded.

Title
OVRO-LWA: Analog Receiver, Rev H

2020-09-21: Add header for IMON scale selection.
2002-10-05. Add optional 1-wire temperature sensor.
2002-10-05. Replace isolation inductors L16-18 with lower Rs parts.
2002-12-24. Change JP3 from header to wire jumper.

Add resistorsto nets DO0,DO1,DO2 to make high 3.3V for RF switches.

Size Orcad B | Number Signal path power & control | Revision

Date: 7/25/2021 | Sheet of 5
File: C:\Caltech\..\ARX_RevH_chanSh2_rev1.SDcrhaDwoncBy:
