lwa-project/analog_receiver/ARX Rev I/Documentation/Reports/ARX System Block Diagram/ARX_BlockDiagram_20Apr2024.pdf

H

G

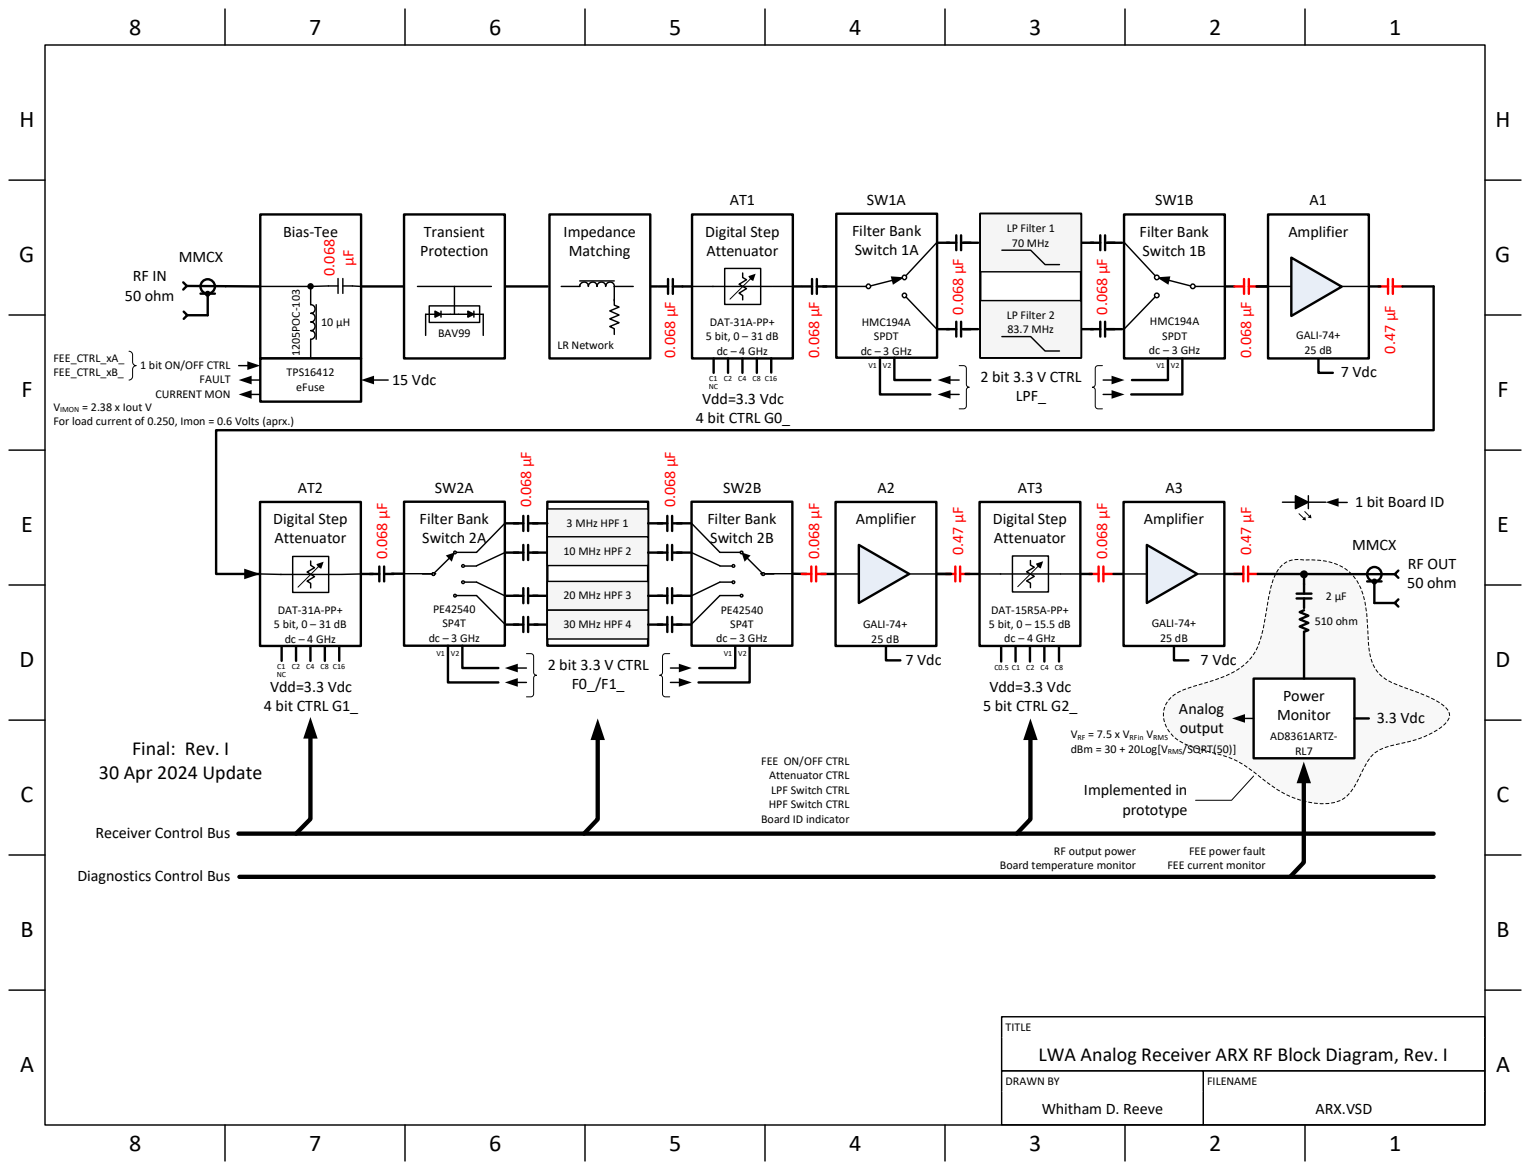
[picture p101: page 1]
RF OUT 50 ohm; FILENAME; ARX.VSD; DRAWN BY; Whitham D. Reeve; 15 Vdc; 7 Vdc; 7 Vdc7 Vdc; Vdd=3.3 Vdc 5 bit CTRL G2_; Final: Rev. I 30 Apr 2024 Update; Bias-Tee; Digital Step Attenuator; DAT-15R5A-PP+ 5 bit, 0 – 15.5 dB dc – 4 GHz; MMCX; LP Filter 1 70 MHz; LP Filter 2 83.7 MHz; Filter Bank Switch 1B; HMC194A SPDT dc – 3 GHz; Filter Bank Switch 1A; 3 MHz HPF 1; 10 MHz HPF 2; 20 MHz HPF 3; 30 MHz HPF 4; Filter Bank Switch 2B; PE42540 SP4T dc – 3 GHz; RF IN 50 ohm; TPS16412 eFuse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

1 bit ON/OFF CTRL

VIMON = 2.38 x Iout V
For load current of 0.250, Imon = 0.6 Volts (aprx.)

1 bit Board ID

VRF = 7.5 x VRFin VRMS
dBm = 30 + 20Log[VRMS/SQRT(50)]

FEE ON/OFF CTRL
Attenuator CTRL
LPF Switch CTRL
HPF Switch CTRL
Board ID indicator

Receiver Control Bus

Board temperature monitor

RF output power

FEE power fault
FEE current monitor

Diagnostics Control Bus

TITLE
LWA Analog Receiver ARX RF Block Diagram, Rev. I
