lwa-project/analog_receiver/ARX Rev I/7V_Reg.kicad_sch

## KiCad design ARX Rev I/7V_Reg.kicad_sch (2025-10-08)

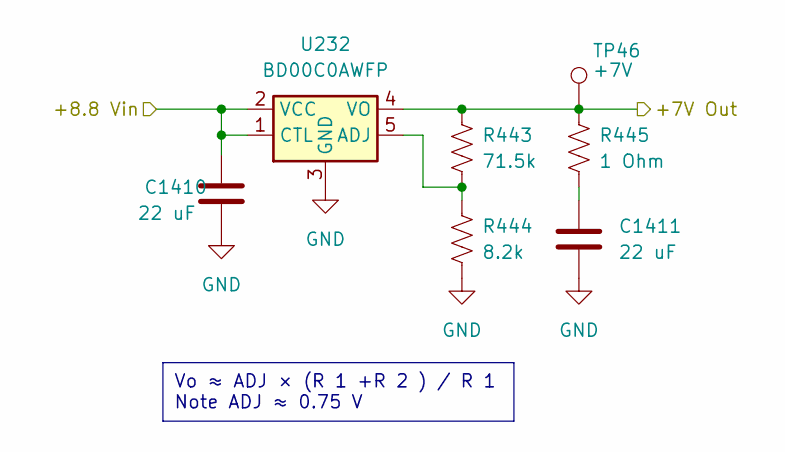
[picture p102: schematic 7V_Reg.kicad_sch]

Parts:
C1410, C1411: 22 uF; C_1206_3216Metric_Pad1.33x1.80mm_HandSolder; Tolerance 10%; Voltage Rating 16 V; MPN EMK316BB7226ML-T
R443: 71.5k; R_0805_2012Metric_Pad1.20x1.40mm_HandSolder; Tolerance 1%; MPN RC0805FR-0771K5L
R444: 8.2k; R_0805_2012Metric_Pad1.20x1.40mm_HandSolder; Tolerance 1%; MPN RC0805JR-078K2L
R445: 1 Ohm; R_0805_2012Metric_Pad1.20x1.40mm_HandSolder; Tolerance 1%; MPN RC0805FR-071RL
TP46: +7V; Harwin_TP_S1751-46R; MPN S1751-46R
U232: BD00C0AWFP; TO-252-4_Thermal_Vias; MPN BD00C0AWFP-CE2

Connections:
+7V Out: R443.1, R445.1, TP46.1, U232.4 (VO)
+8.8 Vin: C1410.1, U232.1 (CTL), U232.2 (VCC)
GND: C1410.2, C1411.2, R444.2, U232.3 (GND)
unnamed: C1411.1, R445.2
unnamed: R443.2, R444.1, U232.5 (ADJ)

Notes on the sheet:
Vo ≈ ADJ × (R 1 +R 2 ) / R 1 Note ADJ ≈ 0.75 V
