lwa-project/analog_receiver/ARX Rev I/ARX.kicad_sch

## KiCad design ARX Rev I/ARX.kicad_sch (2025-10-08)

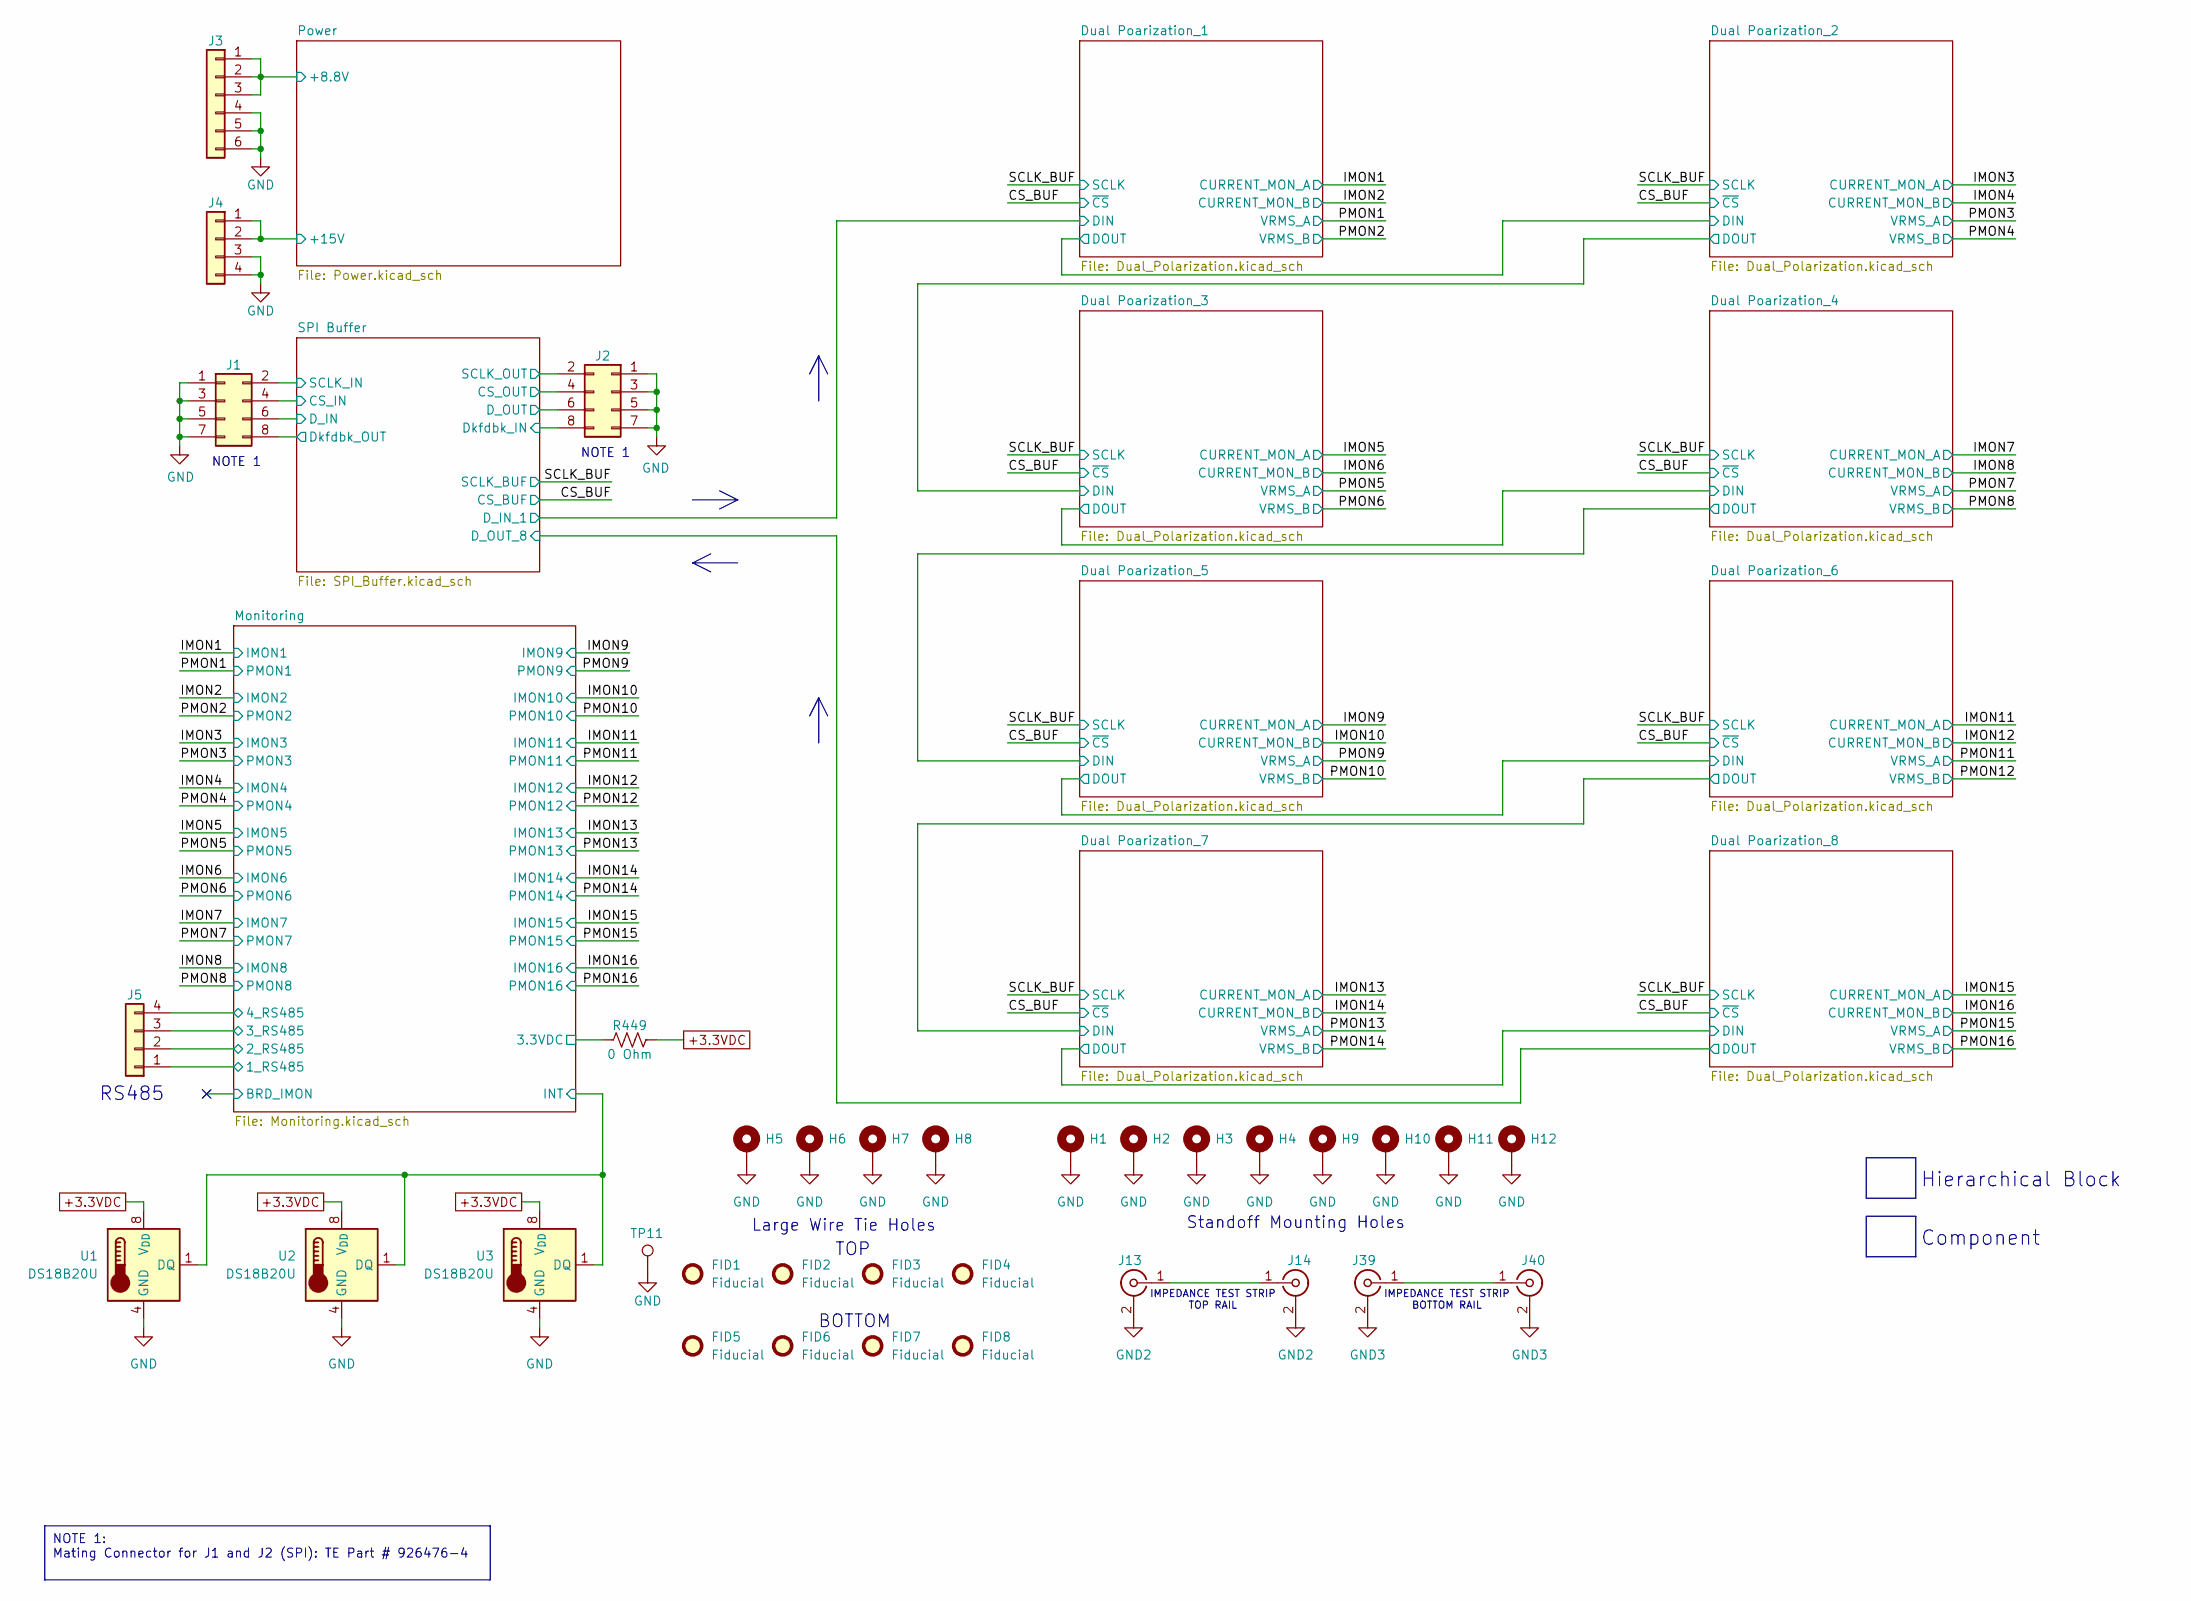
[picture p103: schematic ARX.kicad_sch]

Parts:
FID1, FID2, FID3, FID4, FID5, FID6, FID7, FID8: Fiducial; Fiducial_1mm_Mask3mm; MPN DNI
H1, H2, H3, H4, H9, H10, H11, H12: MountingHole_Pad; MountingHole_3.5mm_Pad
H5, H6, H7, H8: MountingHole_Pad; Large_Wiretie_Hole
J1, J2: 826470-4; AMPMODU_Mod II_826470-4_2x04_P2.54mm_Horizontal_Edge; MPN 826470-4
J3: Conn_01x06; Molex_Sabre_43160-3106_3D_Horizontal_ThermalVias; MPN 0431603106
J4: Conn_01x04; Molex_Sabre_43160-3104_3D_ThermalVias; Voltage Rating 600V; MPN 0431603104
J5: Conn_01x04; Molex_0022124042_1x04_P2.54mm_Horizontal; MPN 0022124042
J13, J14, J39, J40: Conn_Coaxial_Wiretie; MMCX_Molex_73415-1471_Vertical; MPN DNI
R449: 0 Ohm; R_0805_2012Metric_Pad1.20x1.40mm_HandSolder; Tolerance Jumper; Voltage Rating 150 V; MPN RC0805JR-070RL
TP11: GND; Harwin_TP_S1751-46R; MPN S1751-46R
U1, U2, U3: DS18B20U; MSOP-8_3x3mm_P0.65mm; MPN DS18B20U+

Connections:
1_RS485: J5.1
2_RS485: J5.2
3.3VDC: R449.2
3_RS485: J5.3
4_RS485: J5.4
+3.3VDC: R449.1, U1.8 (V_{DD}), U2.8 (V_{DD}), U3.8 (V_{DD})
+8.8V: J3.1, J3.2, J3.3
+15V: J4.1, J4.2
CS_IN: J1.4
CS_OUT: J2.4
D_IN: J1.6
D_OUT: J2.6
Dkfdbk_IN: J2.8
Dkfdbk_OUT: J1.8
GND: H1.1, H2.1, H3.1, H4.1, H5.1, H6.1, H7.1, H8.1, H9.1, H10.1, H11.1, H12.1, J1.1, J1.3, J1.5, J1.7, J2.1, J2.3, J2.5, J2.7, J3.4, J3.5, J3.6, J4.3, J4.4, TP11.1, U1.4 (GND), U2.4 (GND), U3.4 (GND)
GND2: J13.2 (Ext), J14.2 (Ext)
GND3: J39.2 (Ext), J40.2 (Ext)
INT: U1.1 (DQ), U2.1 (DQ), U3.1 (DQ)
unnamed: J13.1 (In), J14.1 (In)
unnamed: J39.1 (In), J40.1 (In)
SCLK_IN: J1.2
SCLK_OUT: J2.2

Notes on the sheet:
NOTE 1: Mating Connector for J1 and J2 (SPI): TE Part # 926476-4
BOTTOM
NOTE 1
IMPEDANCE TEST STRIP TOP RAIL
RS485
Standoff Mounting Holes
IMPEDANCE TEST STRIP BOTTOM RAIL
Component
TOP
Large Wire Tie Holes
Hierarchical Block
