lwa-project/analog_receiver/ARX Rev I/ARX_FilterProto_sch.kicad_sch

## KiCad design ARX Rev I/ARX_FilterProto_sch.kicad_sch (2025-10-08)

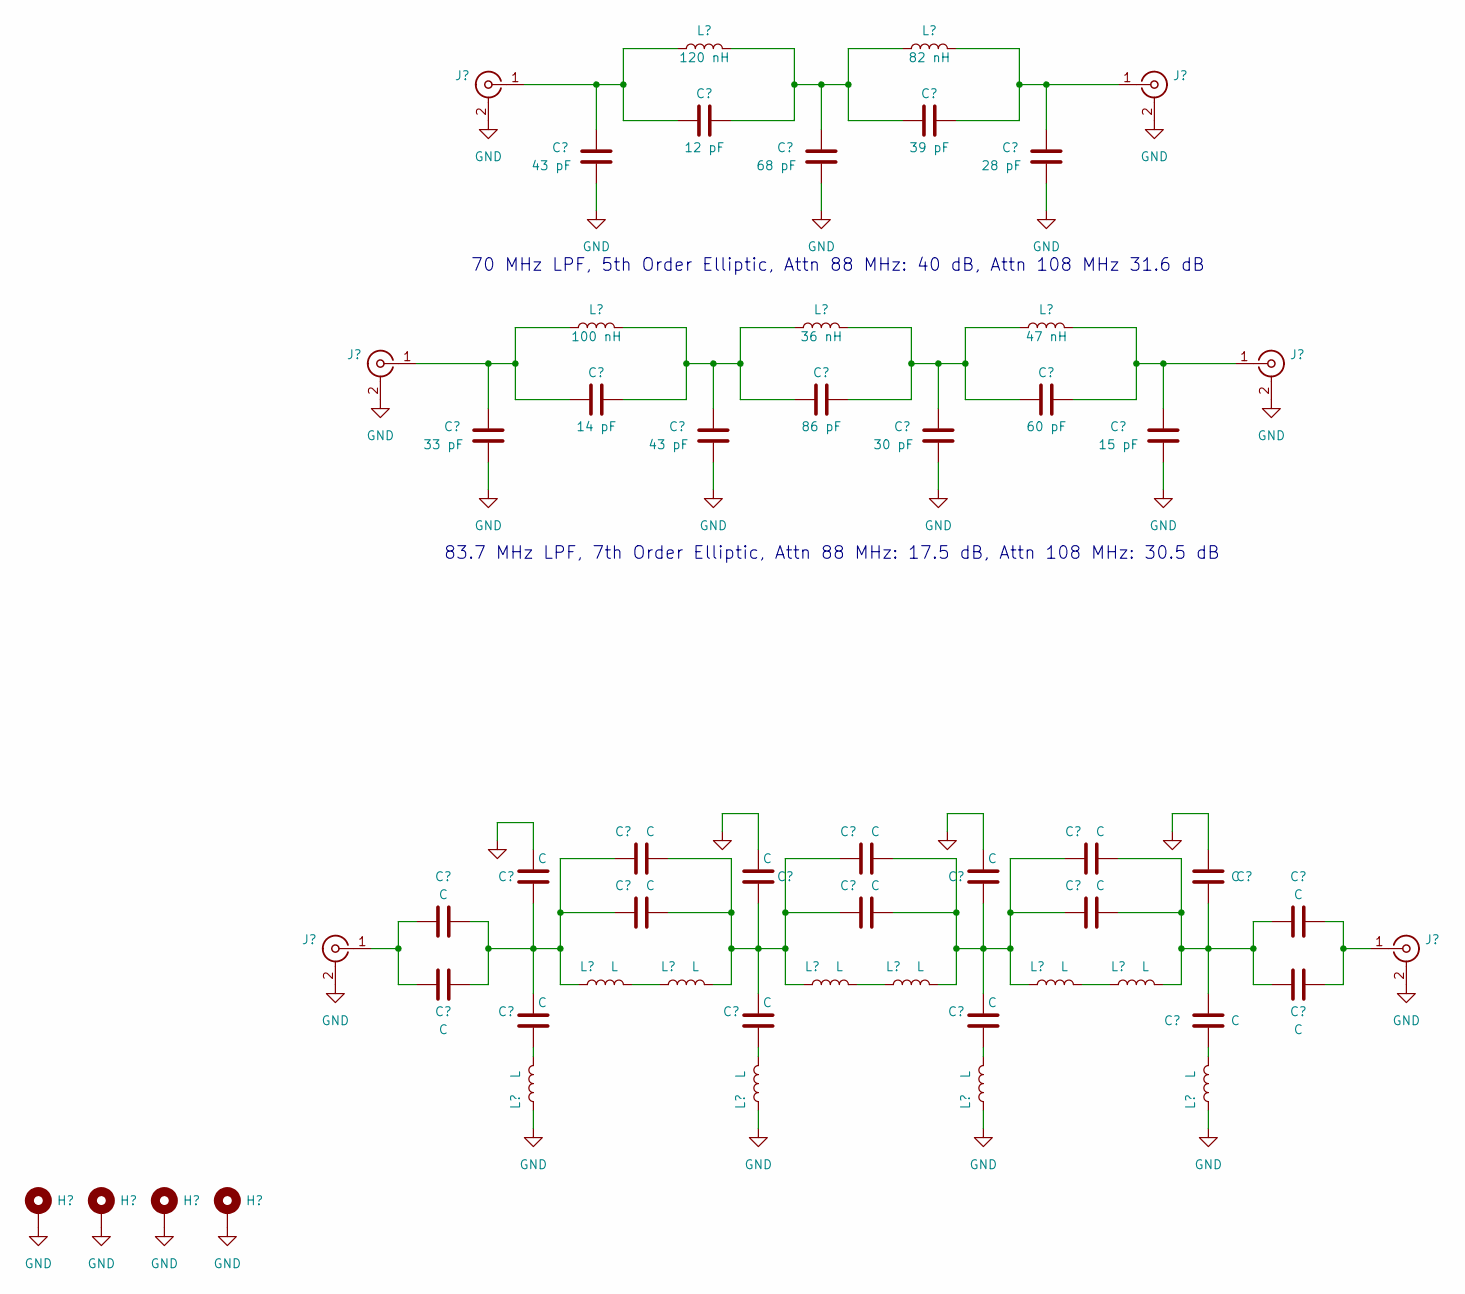
[picture p104: schematic ARX_FilterProto_sch.kicad_sch]

Parts:
C1: 39 pF; C_0805_2012Metric_Pad1.27x1.45mm_HandSolder
C2: 33 pF; C_0805_2012Metric_Pad1.27x1.45mm_HandSolder
C3: 14 pF; C_0805_2012Metric_Pad1.27x1.45mm_HandSolder
C4, C6: 43 pF; C_0805_2012Metric_Pad1.27x1.45mm_HandSolder
C5: 12 pF; C_0805_2012Metric_Pad1.27x1.45mm_HandSolder
C7: 86 pF; C_0805_2012Metric_Pad1.27x1.45mm_HandSolder
C8: 68 pF; C_0805_2012Metric_Pad1.27x1.45mm_HandSolder
C9: 30 pF; C_0805_2012Metric_Pad1.27x1.45mm_HandSolder
C10: 60 pF; C_0805_2012Metric_Pad1.27x1.45mm_HandSolder
C11: 15 pF; C_0805_2012Metric_Pad1.27x1.45mm_HandSolder
C12: 28 pF; C_0805_2012Metric_Pad1.27x1.45mm_HandSolder
C19, C20, C21, C22, C23, C24, C25, C26, C27, C28, C29, C30, C31, C32, C33, C34, C35, C36: C; C_0805_2012Metric_Pad1.27x1.45mm_HandSolder
H1, H2, H3, H4: MountingHole_Pad; MountingHole_3.2mm_M3_Pad_TopBottom
J1, J2, J3, J4, J5, J6: Conn_Coaxial; LINX_SMA_EL
L1: 82 nH; 1008CS_Handsolder
L2: 120 nH; 1008CS_Handsolder
L3: 100 nH; 1008CS_Handsolder
L4: 36 nH; 1008CS_Handsolder
L5: 47 nH; 1008CS_Handsolder
L11, L12, L13, L14, L15, L16, L17, L18, L19, L20: L; 1008CS_Handsolder

Connections:
GND: C2.1, C4.1, C6.1, C8.1, C9.1, C11.1, C12.1, C21.1, C25.1, C29.1, C33.1, H1.1, H2.1, H3.1, H4.1, J1.2 (Ext), J2.2 (Ext), J3.2 (Ext), J4.2 (Ext), J5.2 (Ext), J6.2 (Ext), L11.1, L14.1, L17.1, L20.1
unnamed: C1.1, C5.2, C8.2, L1.1, L2.2
unnamed: C1.2, C12.2, J2.1 (In), L1.2
unnamed: C2.2, C3.1, J5.1 (In), L3.1
unnamed: C3.2, C6.2, C7.1, L3.2, L4.1
unnamed: C4.2, C5.1, J1.1 (In), L2.1
unnamed: C7.2, C9.2, C10.1, L4.2, L5.1
unnamed: C10.2, C11.2, J6.1 (In), L5.2
unnamed: C19.1, C20.1, C21.2, C22.2, C23.1, C24.1, L12.1
unnamed: C19.2, C20.2, J3.1 (In)
unnamed: C22.1, L11.2
unnamed: C23.2, C24.2, C25.2, C26.2, C27.1, C28.1, L13.2, L15.1
unnamed: C26.1, L14.2
unnamed: C27.2, C28.2, C29.2, C30.2, C31.1, C32.1, L16.2, L18.1
unnamed: C30.1, L17.2
unnamed: C31.2, C32.2, C33.2, C34.2, C35.1, C36.1, L19.2
unnamed: C34.1, L20.2
unnamed: C35.2, C36.2, J4.1 (In)
unnamed: L12.2, L13.1
unnamed: L15.2, L16.1
unnamed: L18.2, L19.1

Notes on the sheet:
70 MHz LPF, 5th Order Elliptic, Attn 88 MHz: 40 dB, Attn 108 MHz 31.6 dB
83.7 MHz LPF, 7th Order Elliptic, Attn 88 MHz: 17.5 dB, Attn 108 MHz: 30.5 dB
