lwa-project/analog_receiver/ARX Rev I/ARX_HIgh Pass Filters.kicad_sch

## KiCad design ARX Rev I/ARX_HIgh Pass Filters.kicad_sch (2025-10-08)

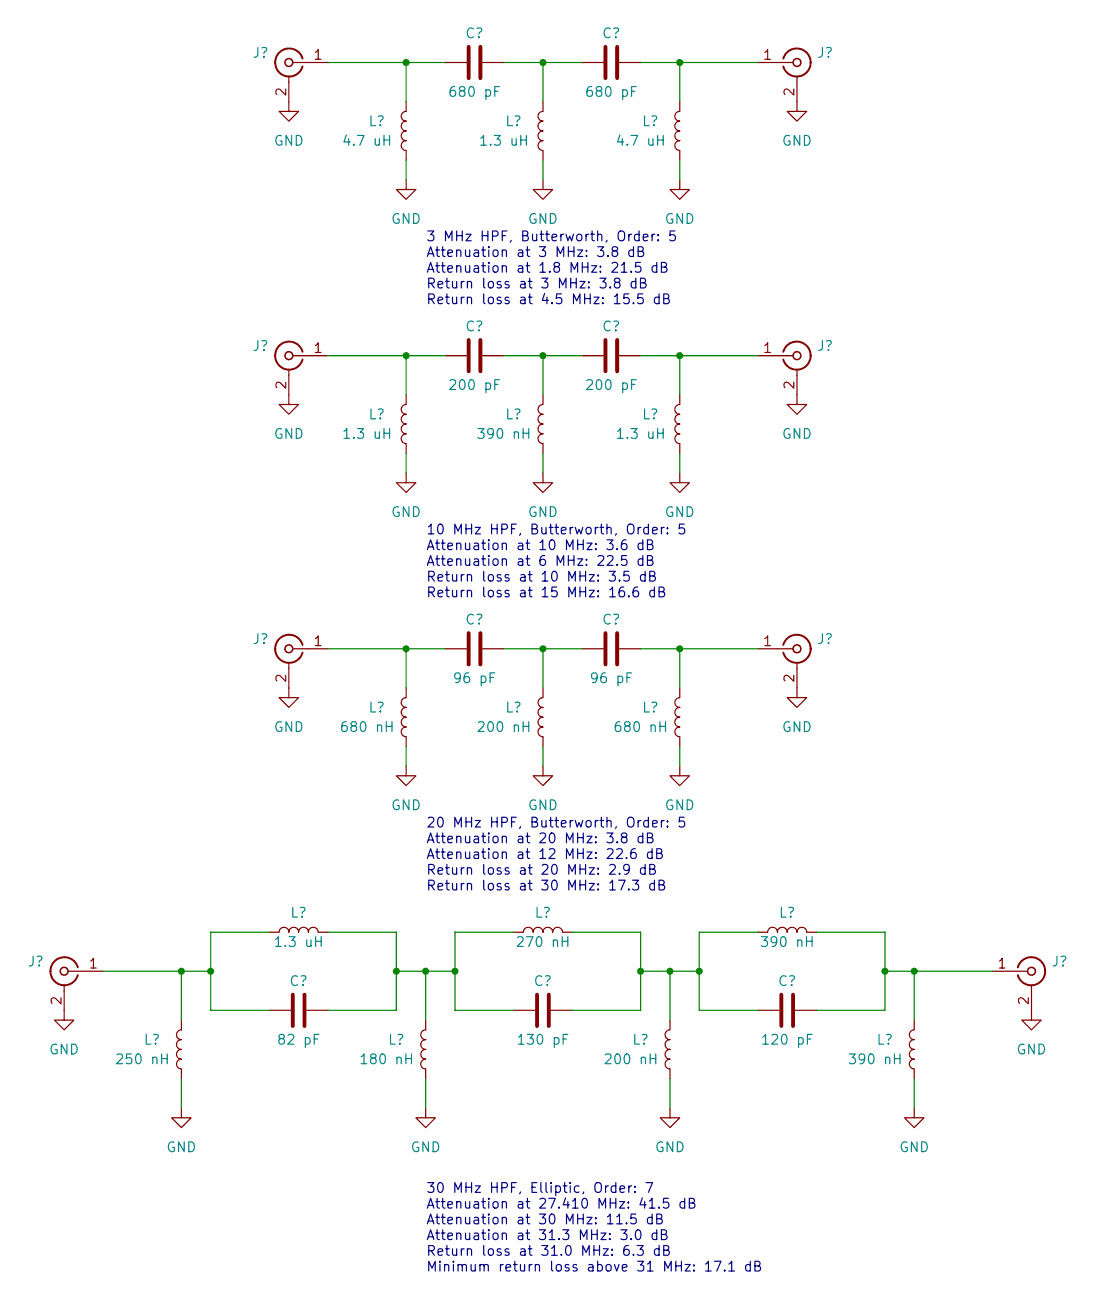
[picture p105: schematic ARX_HIgh Pass Filters.kicad_sch]

Parts:
C19: 82 pF; C_0805_2012Metric_Pad1.27x1.45mm_HandSolder; Tolerance 2%; Voltage Rating 50V; MPN 0805N820G500CT
C20, C24: 680 pF; C_0805_2012Metric_Pad1.27x1.45mm_HandSolder; Voltage Rating 50V; Tolerance 2%; MPN CC0805GRNPO9BN681
C21, C25: 200 pF; C_0805_2012Metric_Pad1.27x1.45mm_HandSolder; Tolerance 2%; MPN 08051A201GAT2A
C22, C26: 96 pF; C_0805_2012Metric_Pad1.27x1.45mm_HandSolder; Voltage Rating 50V; Tolerance 2%; MPN 08055A960FAT2A
C23: 130 pF; C_0805_2012Metric_Pad1.27x1.45mm_HandSolder; Tolerance 2%; Voltage Rating 50V; MPN 08055A131GAT2A
C27: 120 pF; C_0805_2012Metric_Pad1.27x1.45mm_HandSolder; Tolerance 2%; Voltage Rating 50V; MPN CC0805GRNPO9BN121
J7, J8, J9, J10, J11, J12, J13, J14: Conn_Coaxial; LINX_SMA_EL
L7: 250 nH; L_0805_2012Metric_Pad1.15x1.40mm_HandSolder; Tolerance 2%; MPN 0805HP-251XGRC
L8, L10, L13, L19: 1.3 uH; 1008CS_Handsolder; MPN 1008CS-132XGRC
L9, L18: 4.7 uH; 1008CS_Handsolder; MPN 1008CS-472XGRC
L11, L20: 680 nH; 1008CS_Handsolder; Tolerance 2%; MPN 1008CS-681XGRC
L12: 180 nH; L_0805_2012Metric_Pad1.15x1.40mm_HandSolder; Tolerance 2%; MPN 0805HP-181XGRC
L14, L21, L22: 390 nH; L_0805_2012Metric_Pad1.15x1.40mm_HandSolder; Tolerance 2%; MPN 0805HP-391XGRC
L15, L17: 200 nH; L_0805_2012Metric_Pad1.15x1.40mm_HandSolder; Tolerance 2%; MPN 0805HP-201XGRC
L16: 270 nH; L_0805_2012Metric_Pad1.15x1.40mm_HandSolder; Tolerance 2%; MPN 0805HP-271XGRC

Connections:
GND: J7.2 (Ext), J8.2 (Ext), J9.2 (Ext), J10.2 (Ext), J11.2 (Ext), J12.2 (Ext), J13.2 (Ext), J14.2 (Ext), L7.1, L9.1, L10.1, L11.1, L12.1, L13.1, L14.1, L15.1, L17.1, L18.1, L19.1, L20.1, L22.1
unnamed: C19.1, J7.1 (In), L7.2, L8.1
unnamed: C19.2, C23.1, L8.2, L12.2, L16.1
unnamed: C20.1, J8.1 (In), L9.2
unnamed: C20.2, C24.1, L13.2
unnamed: C21.1, J9.1 (In), L10.2
unnamed: C21.2, C25.1, L14.2
unnamed: C22.1, J10.1 (In), L11.2
unnamed: C22.2, C26.1, L15.2
unnamed: C23.2, C27.1, L16.2, L17.2, L21.1
unnamed: C24.2, J11.1 (In), L18.2
unnamed: C25.2, J12.1 (In), L19.2
unnamed: C26.2, J13.1 (In), L20.2
unnamed: C27.2, J14.1 (In), L21.2, L22.2

Notes on the sheet:
10 MHz HPF, Butterworth, Order: 5 Attenuation at 10 MHz: 3.6 dB Attenuation at 6 MHz: 22.5 dB Return loss at 10 MHz: 3.5 dB Return loss at 15 MHz: 16.6 dB
3 MHz HPF, Butterworth, Order: 5 Attenuation at 3 MHz: 3.8 dB Attenuation at 1.8 MHz: 21.5 dB Return loss at 3 MHz: 3.8 dB Return loss at 4.5 MHz: 15.5 dB
30 MHz HPF, Elliptic, Order: 7 Attenuation at 27.410 MHz: 41.5 dB Attenuation at 30 MHz: 11.5 dB Attenuation at 31.3 MHz: 3.0 dB Return loss at 31.0 MHz: 6.3 dB Minimum return loss above 31 MHz: 17.1 dB
20 MHz HPF, Butterworth, Order: 5 Attenuation at 20 MHz: 3.8 dB Attenuation at 12 MHz: 22.6 dB Return loss at 20 MHz: 2.9 dB Return loss at 30 MHz: 17.3 dB
