lwa-project/analog_receiver/ARX Rev I/ARX_Low Pass Filters.kicad_sch

## KiCad design ARX Rev I/ARX_Low Pass Filters.kicad_sch (2025-10-08)

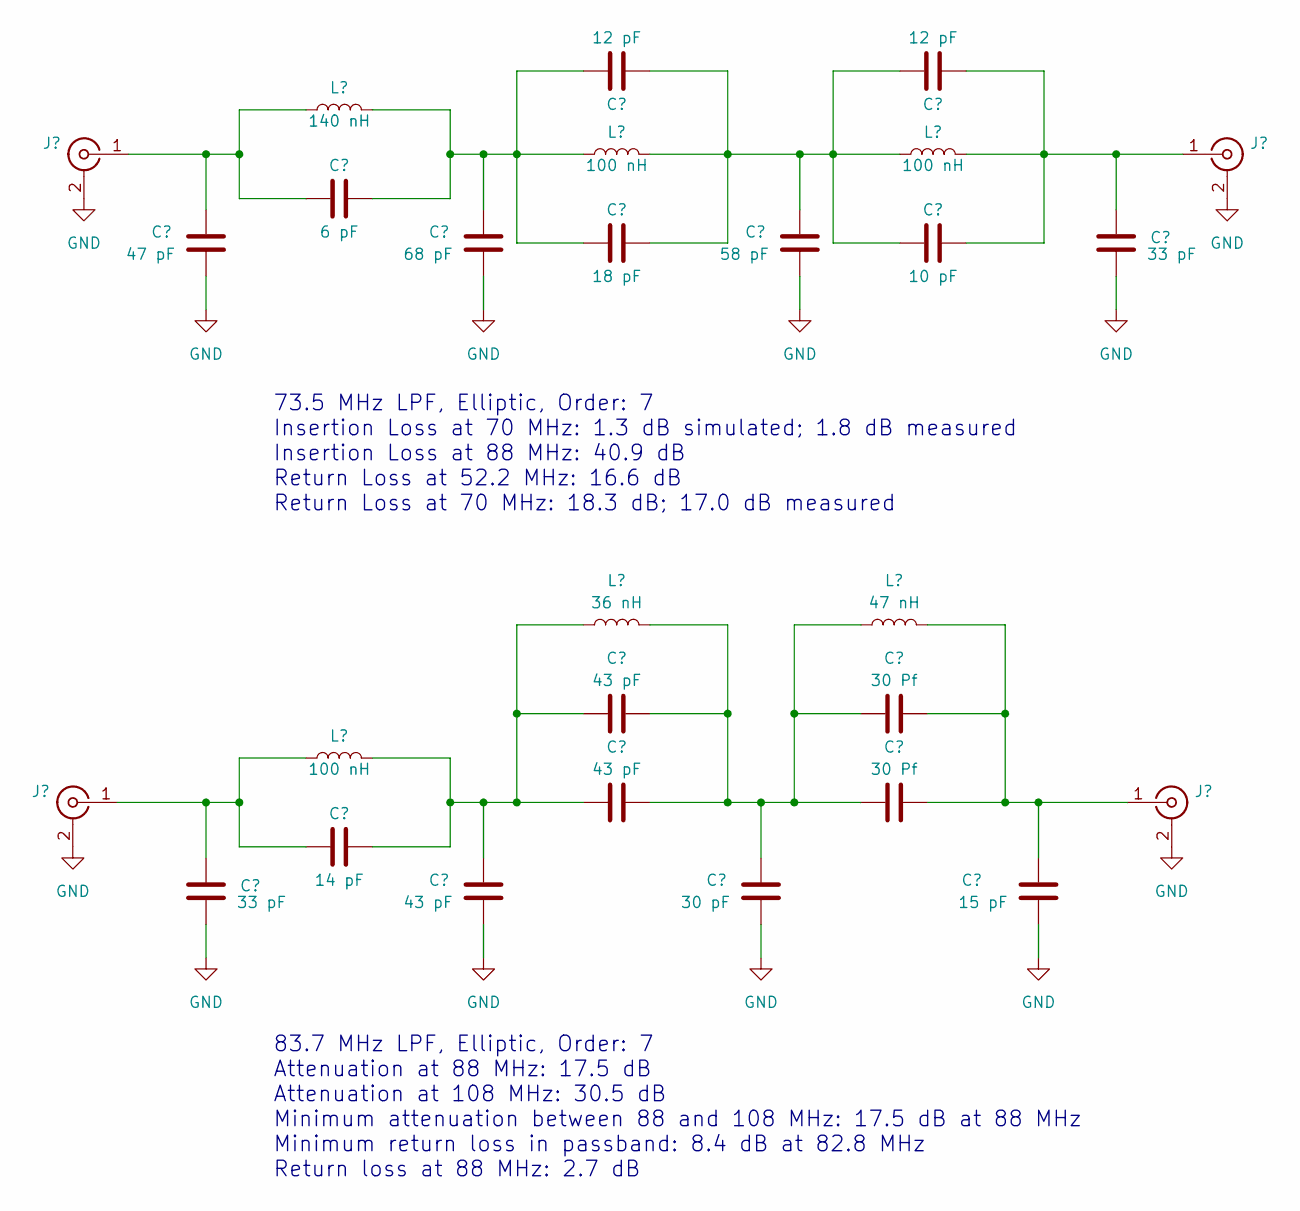
[picture p106: schematic ARX_Low Pass Filters.kicad_sch]

Parts:
C1: 47 pF; C_0805_2012Metric_Pad1.27x1.45mm_HandSolder; Voltage Rating 16V; MPN 0805N470G160CT
C2, C18: 33 pF; C_0805_2012Metric_Pad1.27x1.45mm_HandSolder; Tolerance 2%; Voltage Rating 50V; MPN CC0805GRNPO9BN330
C3: 6 pF; C_0805_2012Metric_Pad1.27x1.45mm_HandSolder; Tolerance +/- 0.25 pF; Voltage Rating 50V; MPN 08055A6R0CAT2A
C4: 14 pF; C_0805_2012Metric_Pad1.27x1.45mm_HandSolder; Tolerance 5%; Voltage Rating 250V; MPN GQM2195C2E140JB12D
C5: 68 pF; C_0805_2012Metric_Pad1.27x1.45mm_HandSolder
C6: 43 pF; C_0805_2012Metric_Pad1.27x1.45mm_HandSolder
C7, C15: 12 pF; C_0805_2012Metric_Pad1.27x1.45mm_HandSolder; Tolerance 2%; Voltage Rating 16V; MPN VJ0805A120GXJCW1BC
C8: 18 pF; C_0805_2012Metric_Pad1.27x1.45mm_HandSolder; Tolerance 2%; Voltage Rating 50V; MPN 0805N180F500CT
C9, C10: 43 pF; C_0805_2012Metric_Pad1.27x1.45mm_HandSolder; Tolerance 2%; Voltage Rating 50V; MPN C0805C430G5GAC7800
C11: 30 pF; C_0805_2012Metric_Pad1.27x1.45mm_HandSolder
C12: 58 pF; C_0805_2012Metric_Pad1.27x1.45mm_HandSolder; Tolerance 2%; Voltage Rating 50V; MPN 08055A580FAT2A
C13, C14: 30 Pf; C_0805_2012Metric_Pad1.27x1.45mm_HandSolder; Tolerance 1%; Voltage Rating 16V; MPN 0805YA300FAT2A
C16: 10 pF; C_0805_2012Metric_Pad1.27x1.45mm_HandSolder; Tolerance +/-0.1 pF; Voltage Rating 50V; MPN 08055A100BAT2A
C17: 15 pF; C_0805_2012Metric_Pad1.27x1.45mm_HandSolder; Tolerance 2%; Voltage Rating 200V; MPN KGQ21HCG2D150GT
J3, J4, J5, J6: Conn_Coaxial; LINX_SMA_EL
L1: 140 nH; L_0805_2012Metric_Pad1.15x1.40mm_HandSolder; Tolerance 2%; MPN 1008HT-R14TGRC
L2, L3, L6: 100 nH; L_0805_2012Metric_Pad1.15x1.40mm_HandSolder; Tolerance 2%; MPN 0805HP-101XGRC
L4: 36 nH; L_0805_2012Metric_Pad1.15x1.40mm_HandSolder; Tolerance 2%; MPN 0805CS-360XGRC
L5: 47 nH; L_0805_2012Metric_Pad1.15x1.40mm_HandSolder; Tolerance 2%; MPN 0805HP-47NXGRC

Connections:
GND: C1.1, C2.1, C5.1, C6.1, C11.1, C12.1, C17.1, C18.1, J3.2 (Ext), J4.2 (Ext), J5.2 (Ext), J6.2 (Ext)
unnamed: C1.2, C3.1, J4.1 (In), L1.1
unnamed: C2.2, C4.1, J3.1 (In), L2.1
unnamed: C3.2, C5.2, C7.1, C8.1, L1.2, L3.1
unnamed: C4.2, C6.2, C9.1, C10.1, L2.2, L4.1
unnamed: C9.2, C10.2, C11.2, C13.1, C14.1, L4.2, L5.1
unnamed: C7.2, C8.2, C12.2, C15.1, C16.1, L3.2, L6.1
unnamed: C13.2, C14.2, C17.2, J5.1 (In), L5.2
unnamed: C15.2, C16.2, C18.2, J6.1 (In), L6.2

Notes on the sheet:
73.5 MHz LPF, Elliptic, Order: 7 Insertion Loss at 70 MHz: 1.3 dB simulated; 1.8 dB measured Insertion Loss at 88 MHz: 40.9 dB Return Loss at 52.2 MHz: 16.6 dB Return Loss at 70 MHz: 18.3 dB; 17.0 dB measured
83.7 MHz LPF, Elliptic, Order: 7 Attenuation at 88 MHz: 17.5 dB Attenuation at 108 MHz: 30.5 dB Minimum attenuation between 88 and 108 MHz: 17.5 dB at 88 MHz Minimum return loss in passband: 8.4 dB at 82.8 MHz Return loss at 88 MHz: 2.7 dB
