lwa-project/analog_receiver/ARX Rev I/Dual_Polarization.kicad_sch

## KiCad design ARX Rev I/Dual_Polarization.kicad_sch (2025-10-08)

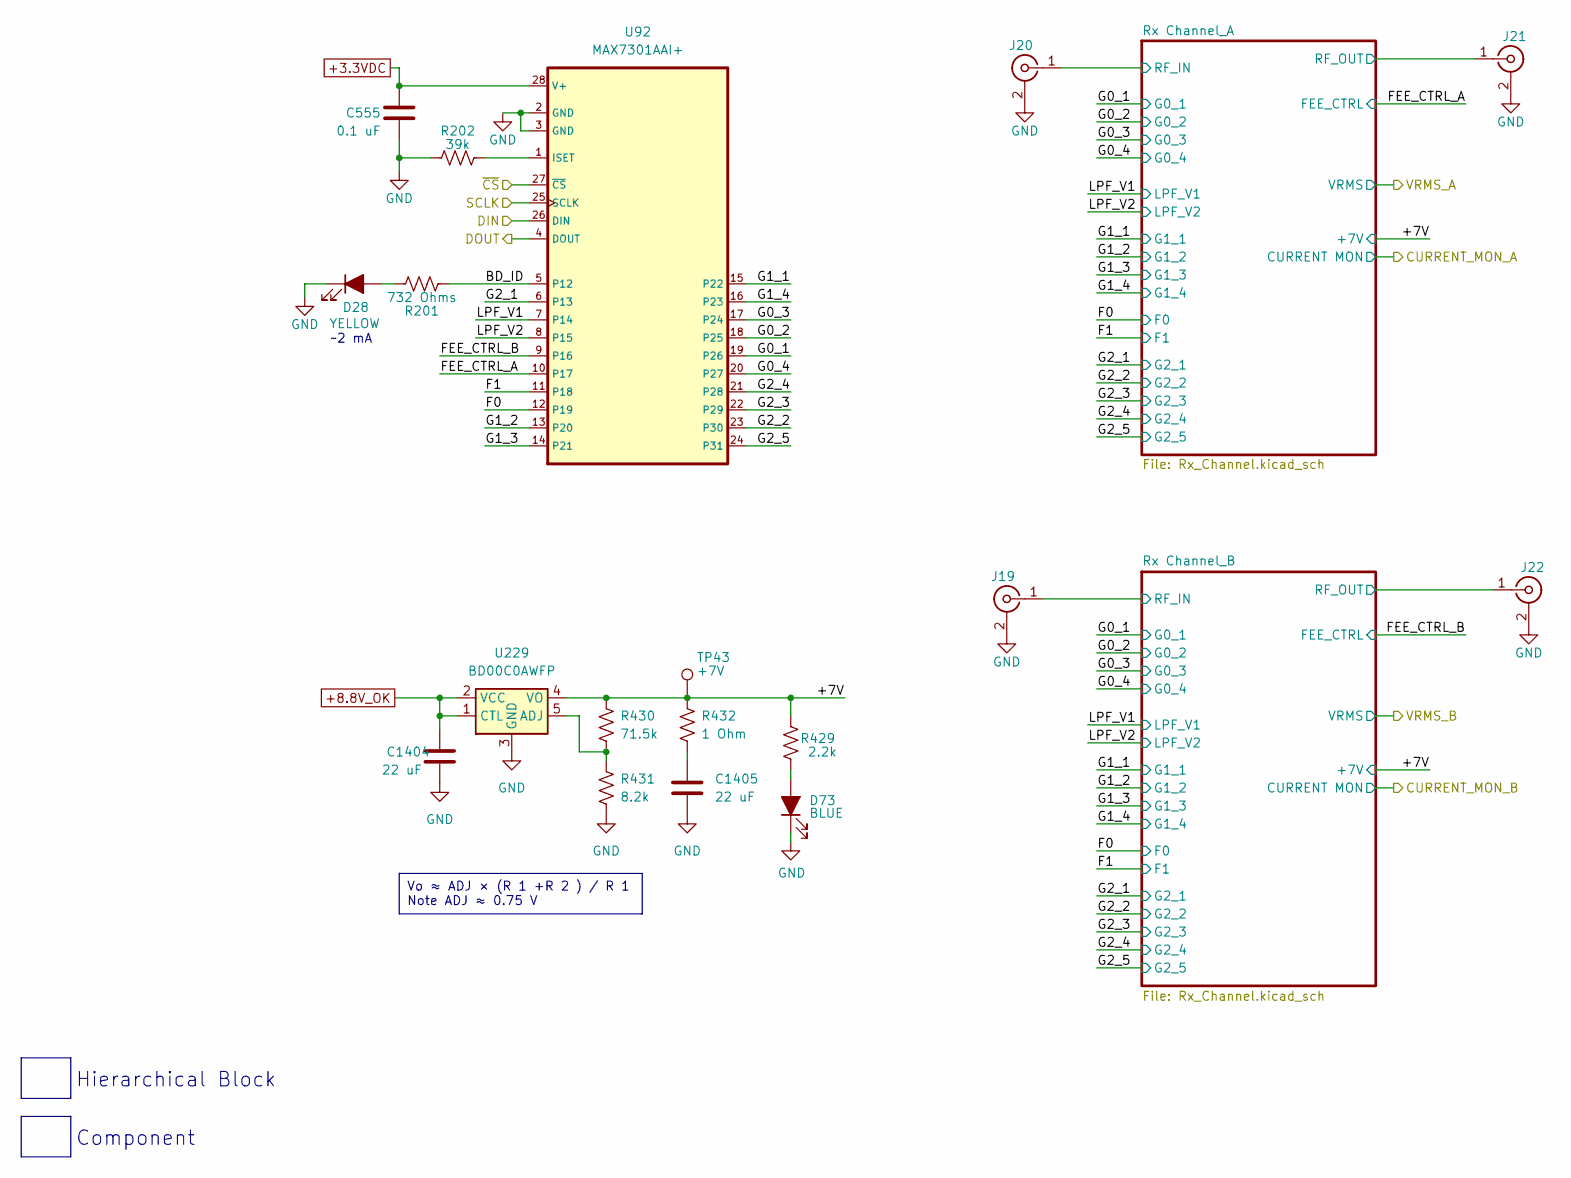
[picture p107: schematic Dual_Polarization.kicad_sch]

Parts:
C555: 0.1 uF; C_0805_2012Metric_Pad1.18x1.45mm_HandSolder; Tolerance 10%; Voltage Rating 25 V; MPN CC0805KRX7R8BB104
C1404, C1405: 22 uF; C_1206_3216Metric_Pad1.33x1.80mm_HandSolder; Tolerance 10%; Voltage Rating 16 V; MPN EMK316BB7226ML-T
D28: YELLOW; LED_1206_3216Metric_Pad1.42x1.75mm_HandSolder; Voltage Rating 1.85V Forward; MPN APT3216LSYCK/J3-PRV
D73: BLUE; LED_1206_3216Metric_Pad1.42x1.75mm_HandSolder; Voltage Rating 2.65 V Forward; MPN APT3216LVBC/D
J19, J20, J21, J22: Conn_Coaxial_Wiretie; MMCX_Molex_73415-1471_Vertical_Ties; MPN 0734151471
R201: 732 Ohms; R_0805_2012Metric_Pad1.20x1.40mm_HandSolder; Tolerance 1%; Voltage Rating 150 V; MPN RC0805FR-07732RL
R202: 39k; R_0805_2012Metric_Pad1.20x1.40mm_HandSolder; Tolerance 1%; Voltage Rating 150 V; MPN RC0805FR-0739KL
R429: 2.2k; R_0805_2012Metric_Pad1.20x1.40mm_HandSolder; Tolerance 1%; Voltage Rating 150 V; MPN RMCF0805FT2K20
R430: 71.5k; R_0805_2012Metric_Pad1.20x1.40mm_HandSolder; Tolerance 1%; MPN RC0805FR-0771K5L
R431: 8.2k; R_0805_2012Metric_Pad1.20x1.40mm_HandSolder; Tolerance 1%; MPN RC0805JR-078K2L
R432: 1 Ohm; R_0805_2012Metric_Pad1.20x1.40mm_HandSolder; Tolerance 1%; MPN RC0805FR-071RL
TP43: +7V; Harwin_TP_S1751-46R; MPN S1751-46R
U92: MAX7301AAI+; SSOP-28_5.3x10.2mm_P0.65mm; MPN MAX7301AAI+
U229: BD00C0AWFP; TO-252-4_Thermal_Vias; MPN BD00C0AWFP-CE2

Connections:
+3.3VDC: C555.1, U92.28 (V+)
+7V: R429.2, R430.1, R432.1, TP43.1, U229.4 (VO)
+8.8V_OK: C1404.1, U229.1 (CTL), U229.2 (VCC)
BD_ID: R201.2, U92.5 (P12)
DIN: U92.26 (DIN)
DOUT: U92.4 (DOUT)
F0: U92.12 (P19)
F1: U92.11 (P18)
FEE_CTRL_A: U92.10 (P17)
FEE_CTRL_B: U92.9 (P16)
G0_1: U92.19 (P26)
G0_2: U92.18 (P25)
G0_3: U92.17 (P24)
G0_4: U92.20 (P27)
G1_1: U92.15 (P22)
G1_2: U92.13 (P20)
G1_3: U92.14 (P21)
G1_4: U92.16 (P23)
G2_1: U92.6 (P13)
G2_2: U92.23 (P30)
G2_3: U92.22 (P29)
G2_4: U92.21 (P28)
G2_5: U92.24 (P31)
GND: C555.2, C1404.2, C1405.2, D28.1 (K), D73.1 (K), J19.2 (Ext), J20.2 (Ext), J21.2 (Ext), J22.2 (Ext), R202.2, R431.2, U92.2 (GND), U92.3 (GND), U229.3 (GND)
LPF_V1: U92.7 (P14)
LPF_V2: U92.8 (P15)
unnamed: C1405.1, R432.2
unnamed: D28.2 (A), R201.1
unnamed: D73.2 (A), R429.1
unnamed: R202.1, U92.1 (ISET)
unnamed: R430.2, R431.1, U229.5 (ADJ)
RF_IN: J19.1 (In), J20.1 (In)
RF_OUT: J21.1 (In), J22.1 (In)
SCLK: U92.25 (SCLK)
~CS: U92.27 (~CS)

Notes on the sheet:
Vo ≈ ADJ × (R 1 +R 2 ) / R 1 Note ADJ ≈ 0.75 V
Hierarchical Block
~2 mA
Component
