lwa-project/analog_receiver/ARX Rev I/HPF_3_MHz.kicad_sch

## KiCad design ARX Rev I/HPF_3_MHz.kicad_sch (2025-10-08)

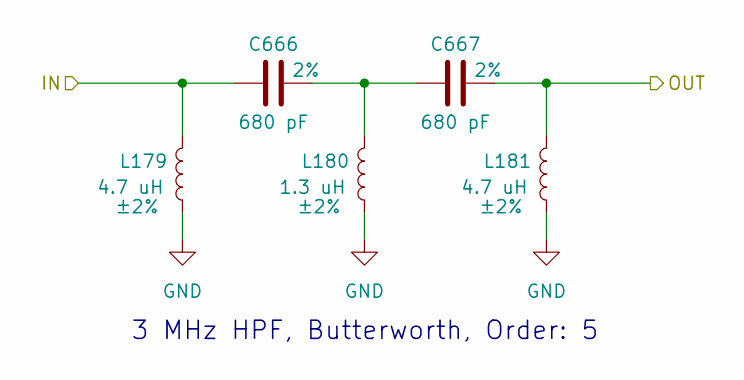
[picture p108: schematic HPF_3_MHz.kicad_sch]

Parts:
C666, C667: 680 pF; C_0805_2012Metric_Pad1.27x1.45mm_HandSolder; Voltage Rating 50V; Tolerance 2%; MPN CC0805GRNPO9BN681
L179, L181: 4.7 uH; 1008CS_Handsolder; Tolerance ±2%; MPN 1008CS-472XGRC
L180: 1.3 uH; 1008CS_Handsolder; Tolerance ±2%; MPN 1008CS-132XGRC

Connections:
GND: L179.1, L180.1, L181.1
IN: C666.1, L179.2
unnamed: C666.2, C667.1, L180.2
OUT: C667.2, L181.2

Notes on the sheet:
3 MHz HPF, Butterworth, Order: 5
