lwa-project/analog_receiver/ARX Rev I/HPF_10_MHz.kicad_sch

## KiCad design ARX Rev I/HPF_10_MHz.kicad_sch (2025-10-08)

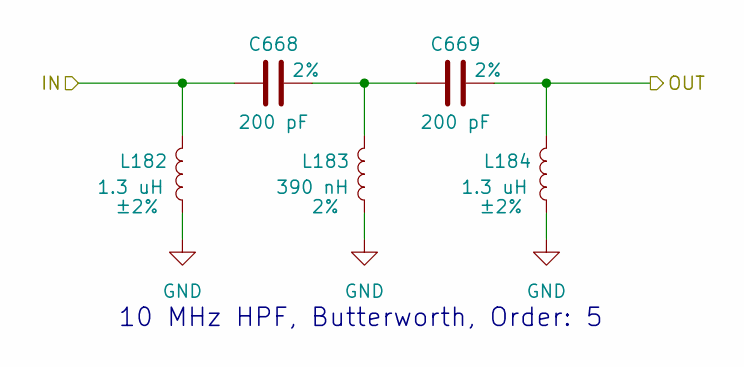
[picture p109: schematic HPF_10_MHz.kicad_sch]

Parts:
C668, C669: 200 pF; C_0805_2012Metric_Pad1.27x1.45mm_HandSolder; Tolerance 2%; MPN 08051A201GAT2A
L182, L184: 1.3 uH; 1008CS_Handsolder; Tolerance ±2%; MPN 1008CS-132XGRC
L183: 390 nH; L_0805_2012Metric_Pad1.15x1.40mm_HandSolder; Tolerance 2%; MPN 0805HP-391XGRC

Connections:
GND: L182.1, L183.1, L184.1
IN: C668.1, L182.2
unnamed: C668.2, C669.1, L183.2
OUT: C669.2, L184.2

Notes on the sheet:
10 MHz HPF, Butterworth, Order: 5
