lwa-project/analog_receiver/ARX Rev I/HPF_20_MHz.kicad_sch

## KiCad design ARX Rev I/HPF_20_MHz.kicad_sch (2025-10-08)

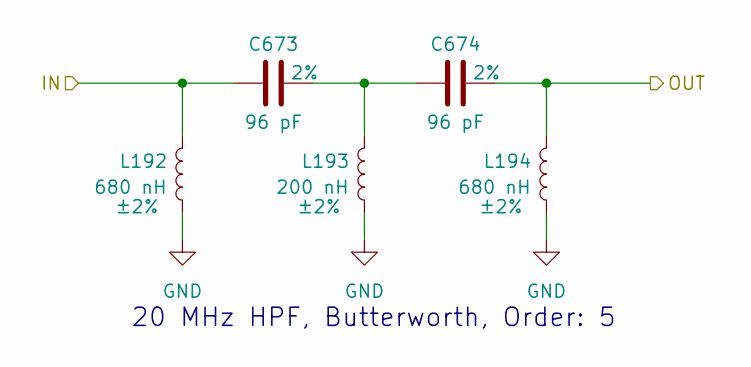
[picture p110: schematic HPF_20_MHz.kicad_sch]

Parts:
C673, C674: 96 pF; C_0805_2012Metric_Pad1.27x1.45mm_HandSolder; Voltage Rating 50V; Tolerance 2%; MPN 08055A960FAT2A
L192, L194: 680 nH; 1008CS_Handsolder; Tolerance ±2%; MPN 1008CS-681XGRC
L193: 200 nH; L_0805_2012Metric_Pad1.15x1.40mm_HandSolder; Tolerance ±2%; MPN 0805HP-201XGRC

Connections:
GND: L192.1, L193.1, L194.1
IN: C673.1, L192.2
unnamed: C673.2, C674.1, L193.2
OUT: C674.2, L194.2

Notes on the sheet:
20 MHz HPF, Butterworth, Order: 5
