lwa-project/analog_receiver/ARX Rev I/HPF_30_MHz.kicad_sch

## KiCad design ARX Rev I/HPF_30_MHz.kicad_sch (2025-10-08)

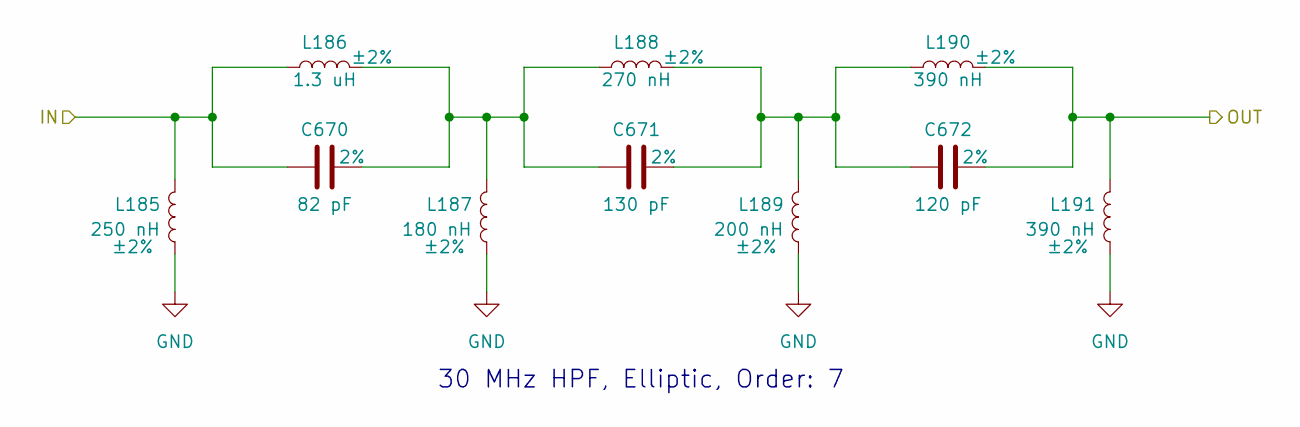
[picture p111: schematic HPF_30_MHz.kicad_sch]

Parts:
C670: 82 pF; C_0805_2012Metric_Pad1.27x1.45mm_HandSolder; Tolerance 2%; Voltage Rating 50V; MPN 0805N820G500CT
C671: 130 pF; C_0805_2012Metric_Pad1.27x1.45mm_HandSolder; Tolerance 2%; Voltage Rating 50V; MPN 08055A131GAT2A
C672: 120 pF; C_0805_2012Metric_Pad1.27x1.45mm_HandSolder; Tolerance 2%; Voltage Rating 50V; MPN CC0805GRNPO9BN121
L185: 250 nH; L_0805_2012Metric_Pad1.15x1.40mm_HandSolder; Tolerance ±2%; MPN 0805HP-251XGRC
L186: 1.3 uH; 1008CS_Handsolder; Tolerance ±2%; MPN 1008CS-132XGRC
L187: 180 nH; L_0805_2012Metric_Pad1.15x1.40mm_HandSolder; Tolerance ±2%; MPN 0805HP-181XGRC
L188: 270 nH; L_0805_2012Metric_Pad1.15x1.40mm_HandSolder; Tolerance ±2%; MPN 0805HP-271XGRC
L189: 200 nH; L_0805_2012Metric_Pad1.15x1.40mm_HandSolder; Tolerance ±2%; MPN 0805HP-201XGRC
L190, L191: 390 nH; L_0805_2012Metric_Pad1.15x1.40mm_HandSolder; Tolerance ±2%; MPN 0805HP-391XGRC

Connections:
GND: L185.1, L187.1, L189.1, L191.1
IN: C670.1, L185.2, L186.1
unnamed: C670.2, C671.1, L186.2, L187.2, L188.1
unnamed: C671.2, C672.1, L188.2, L189.2, L190.1
OUT: C672.2, L190.2, L191.2

Notes on the sheet:
30 MHz HPF, Elliptic, Order: 7
