lwa-project/analog_receiver/ARX Rev I/IO_Filter.kicad_sch

## KiCad design ARX Rev I/IO_Filter.kicad_sch (2025-10-08)

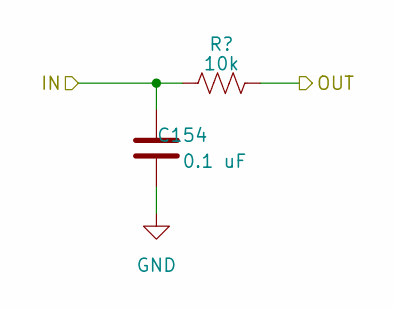
[picture p112: schematic IO_Filter.kicad_sch]

Parts:
C154: 0.1 uF; C_1206_3216Metric_Pad1.6x1.8mm; Tolerance 10%; Voltage Rating 250 V; MPN CC1206KKX7RYBB104
R64: 10k; R_0805_2012Metric_Pad1.20x1.40mm_HandSolder; Tolerance 1%; Voltage Rating 150 V; MPN RC0805FR-0710KL

Connections:
GND: C154.1
IN: C154.2, R64.2
OUT: R64.1
