lwa-project/analog_receiver/ARX Rev I/LPF_73_5_MHz.kicad_sch

## KiCad design ARX Rev I/LPF_73_5_MHz.kicad_sch (2025-10-08)

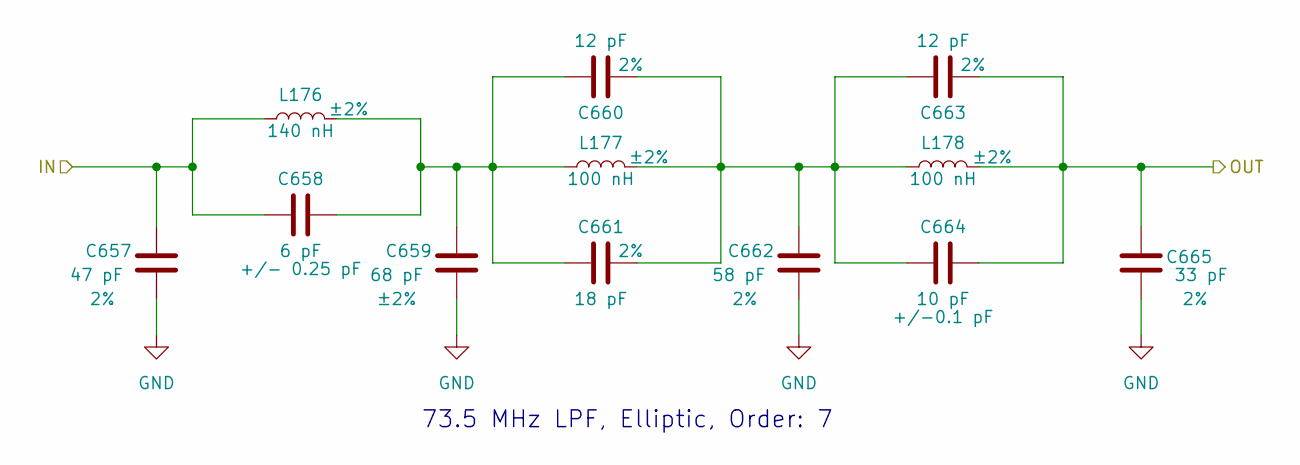
[picture p113: schematic LPF_73_5_MHz.kicad_sch]

Parts:
C657: 47 pF; C_0805_2012Metric_Pad1.27x1.45mm_HandSolder; Voltage Rating 16V; Tolerance 2%; MPN 0805N470G160CT
C658: 6 pF; C_0805_2012Metric_Pad1.27x1.45mm_HandSolder; Tolerance +/- 0.25 pF; Voltage Rating 50V; MPN 08055A6R0CAT2A
C659: 68 pF; C_0805_2012Metric_Pad1.27x1.45mm_HandSolder; Voltage Rating 50V; Tolerance ±2%; MPN VJ0805A680GXAPW1BC
C660, C663: 12 pF; C_0805_2012Metric_Pad1.27x1.45mm_HandSolder; Tolerance 2%; Voltage Rating 16V; MPN VJ0805A120GXJCW1BC
C661: 18 pF; C_0805_2012Metric_Pad1.27x1.45mm_HandSolder; Tolerance 2%; Voltage Rating 50V; MPN 0805N180F500CT
C662: 58 pF; C_0805_2012Metric_Pad1.27x1.45mm_HandSolder; Tolerance 2%; Voltage Rating 50V; MPN 08055A580FAT2A
C664: 10 pF; C_0805_2012Metric_Pad1.27x1.45mm_HandSolder; Tolerance +/-0.1 pF; Voltage Rating 50V; MPN 08055A100BAT2A
C665: 33 pF; C_0805_2012Metric_Pad1.27x1.45mm_HandSolder; Tolerance 2%; Voltage Rating 50V; MPN CC0805GRNPO9BN330
L176: 140 nH; 1008HT_Handsolder; Tolerance ±2%; MPN 1008HT-R14TGRC
L177, L178: 100 nH; L_0805_2012Metric_Pad1.15x1.40mm_HandSolder; Tolerance ±2%; MPN 0805HP-101XGRC

Connections:
GND: C657.1, C659.1, C662.1, C665.1
IN: C657.2, C658.1, L176.1
unnamed: C658.2, C659.2, C660.1, C661.1, L176.2, L177.1
unnamed: C660.2, C661.2, C662.2, C663.1, C664.1, L177.2, L178.1
OUT: C663.2, C664.2, C665.2, L178.2

Notes on the sheet:
73.5 MHz LPF, Elliptic, Order: 7
