lwa-project/analog_receiver/ARX Rev I/LPF_83_7_MHz.kicad_sch

## KiCad design ARX Rev I/LPF_83_7_MHz.kicad_sch (2025-10-08)

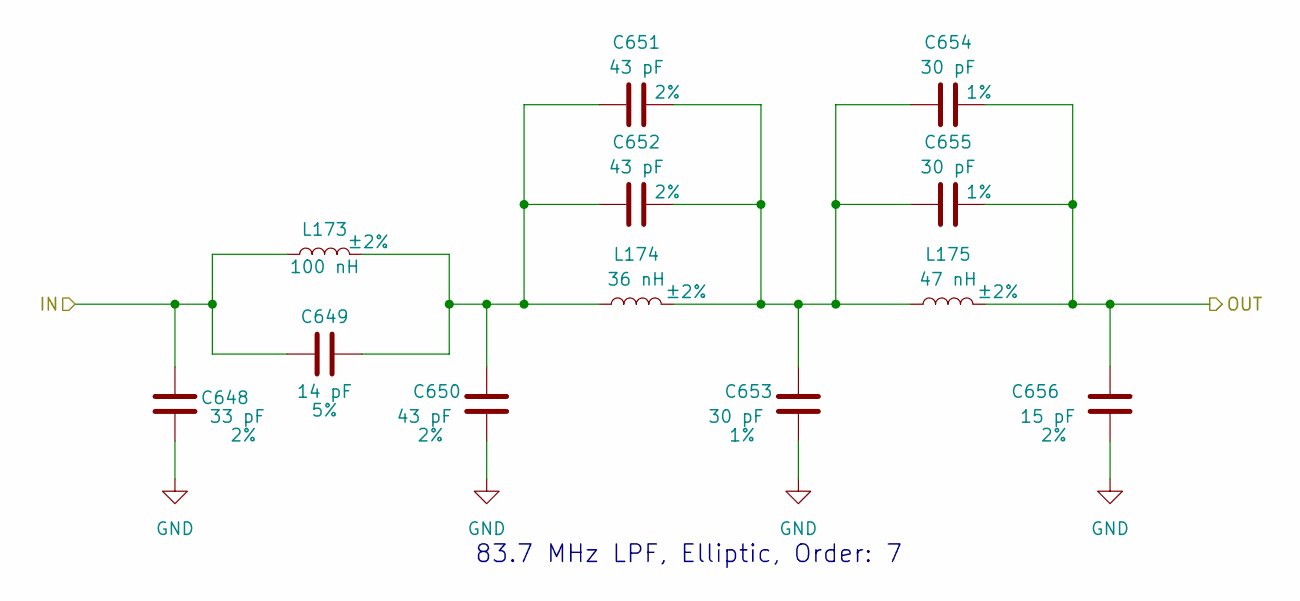
[picture p114: schematic LPF_83_7_MHz.kicad_sch]

Parts:
C648: 33 pF; C_0805_2012Metric_Pad1.27x1.45mm_HandSolder; Tolerance 2%; Voltage Rating 50V; MPN CC0805GRNPO9BN330
C649: 14 pF; C_0805_2012Metric_Pad1.27x1.45mm_HandSolder; Tolerance 5%; Voltage Rating 250V; MPN GQM2195C2E140JB12D
C650: 43 pF; C_0805_2012Metric_Pad1.27x1.45mm_HandSolder; Tolerance 2%; Voltage Rating 50V; MPN C0805C430G5GACTU
C651, C652: 43 pF; C_0805_2012Metric_Pad1.27x1.45mm_HandSolder; Tolerance 2%; Voltage Rating 50V; MPN C0805C430G5GAC7800
C653, C654, C655: 30 pF; C_0805_2012Metric_Pad1.27x1.45mm_HandSolder; Tolerance 1%; Voltage Rating 16V; MPN 0805YA300FAT2A
C656: 15 pF; C_0805_2012Metric_Pad1.27x1.45mm_HandSolder; Tolerance 2%; Voltage Rating 200V; MPN KGQ21HCG2D150GT
L173: 100 nH; L_0805_2012Metric_Pad1.15x1.40mm_HandSolder; Tolerance ±2%; MPN 0805HP-101XGRC
L174: 36 nH; L_0805_2012Metric_Pad1.15x1.40mm_HandSolder; Tolerance ±2%; MPN 0805CS-360XGRC
L175: 47 nH; L_0805_2012Metric_Pad1.15x1.40mm_HandSolder; Tolerance ±2%; MPN 0805HP-47NXGRC

Connections:
GND: C648.1, C650.1, C653.1, C656.1
IN: C648.2, C649.1, L173.1
unnamed: C649.2, C650.2, C651.1, C652.1, L173.2, L174.1
unnamed: C651.2, C652.2, C653.2, C654.1, C655.1, L174.2, L175.1
OUT: C654.2, C655.2, C656.2, L175.2

Notes on the sheet:
83.7 MHz LPF, Elliptic, Order: 7
