lwa-project/analog_receiver/ARX Rev I/Monitoring.kicad_sch

## KiCad design ARX Rev I/Monitoring.kicad_sch (2025-10-08)

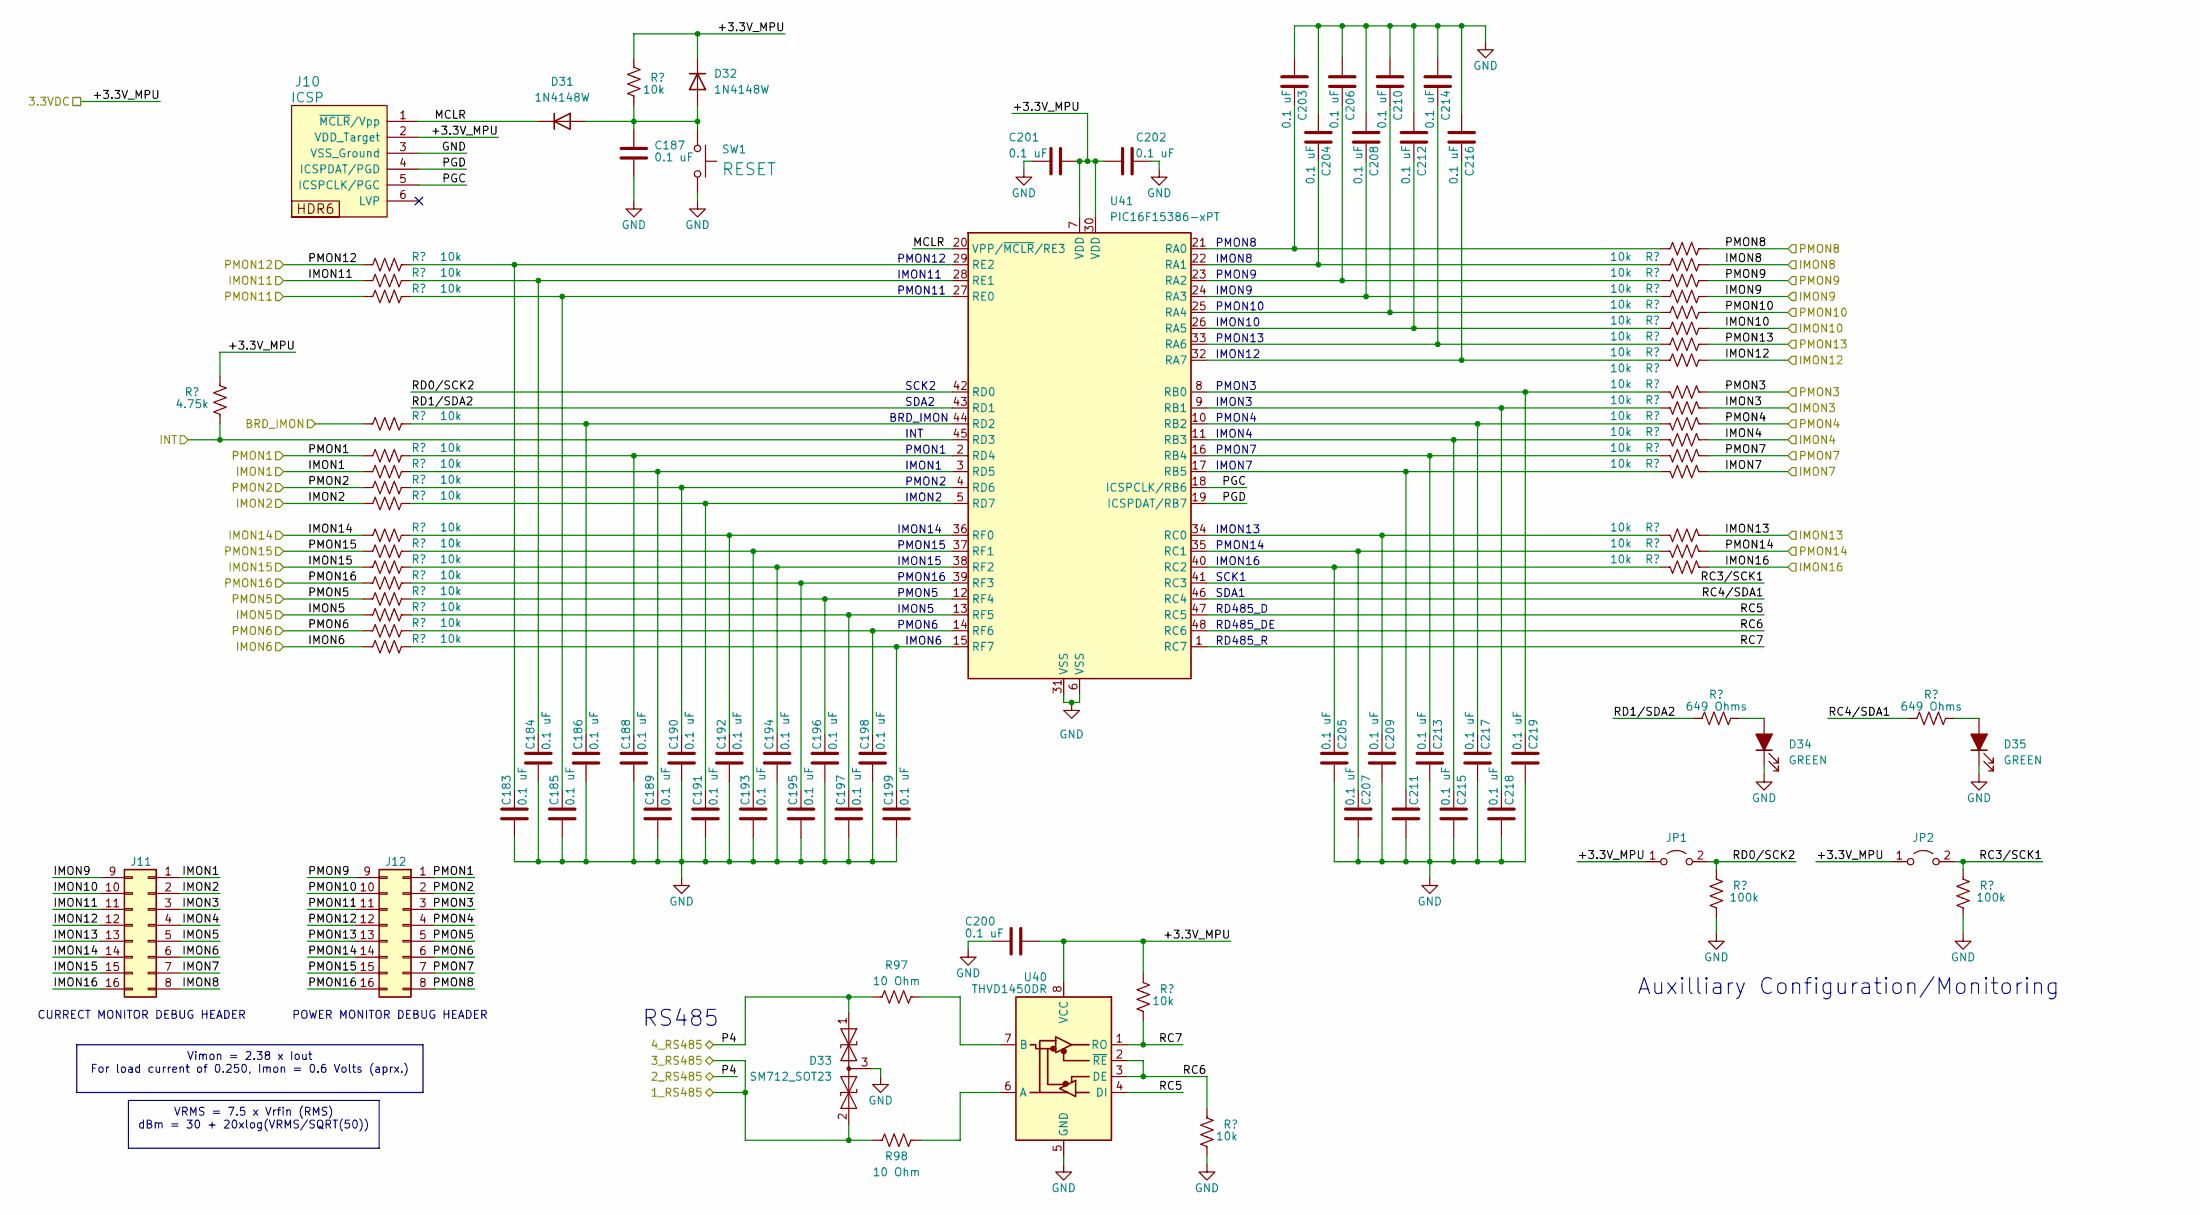
[picture p115: schematic Monitoring.kicad_sch]

Parts:
C183, C184, C185, C186, C187, C188, C189, C190, C191, C192, C193, C194, C195, C196, C197, C198, C199, C200, C201, C202, C203, C204, C205, C206, C207, C208, C209, C210, C211, C212, C213, C214, C215, C216, C217, C218, C219: 0.1 uF; C_1206_3216Metric_Pad1.6x1.8mm; Tolerance 10%; Voltage Rating 250 V; MPN CC1206KKX7RYBB104
D31, D32: 1N4148W; D_SOD-123; MPN 1N4148W
D33: SM712_SOT23; SOT-23; Voltage Rating 12/7; MPN SM712
D34, D35: GREEN; LED_0805_2012Metric_Pad1.15x1.40mm_HandSolder; MPN DNI
J10: ICSP; MPN 61300611021
J11, J12: Conn_02x08_Top_Bottom; Debug_Header_2x08_P2.54mm_Vertical; MPN DNI
JP1, JP2: 61300211121; PinHeader_1x02_P2.54mm_Vertical; MPN DNI
R79: 4.75k; R_0805_2012Metric_Pad1.20x1.40mm_HandSolder; Tolerance 1%; Voltage Rating 150 V; MPN RC0805FR-074K75L
R80, R81, R82, R83, R84, R85, R86, R87, R88, R89, R90, R91, R92, R93, R94, R95, R96, R99, R100, R101, R102, R103, R104, R105, R106, R107, R108, R109, R110, R111, R112, R113, R114, R115, R116, R117: 10k; R_0805_2012Metric_Pad1.20x1.40mm_HandSolder; Tolerance 1%; Voltage Rating 150 V; MPN RC0805FR-0710KL
R97, R98: 10 Ohm; R_0805_2012Metric_Pad1.20x1.40mm_HandSolder; Tolerance 1%; Voltage Rating 300V; MPN CMP0805-FX-10R0ELF
R118, R120: 649 Ohms; R_0805_2012Metric_Pad1.20x1.40mm_HandSolder; Tolerance 1%; Voltage Rating 150 V; MPN RC0805FR-07649RL
R119, R121: 100k; R_0805_2012Metric_Pad1.20x1.40mm_HandSolder; Tolerance 1%; Voltage Rating 150 V; MPN RC0805FR-07100KL
SW1: RESET; SW_SPST_Omron_B3FS-1012P; Voltage Rating 24V; MPN B3FS-1012P
U40: THVD1450DR; SOIC-8_3.9x4.9mm_P1.27mm; MPN THVD1450DR
U41: PIC16F15386-xPT; TQFP-48_7x7mm_P0.5mm; MPN PIC16F15386-I/PT

Connections:
1_RS485: D33.2 (A2), R98.1
2_RS485: D33.1 (A1), R97.1
+3.3V_MPU: C200.1, C201.1, C202.1, D32.1 (K), J10.2 (VDD_Target), JP1.1 (A), JP2.1 (A), R79.1, R96.1, R99.1, U40.8 (VCC), U41.7 (VDD), U41.30 (VDD)
BRD_IMON: R83.2
GND: C183.1, C184.1, C185.1, C186.1, C187.2, C188.1, C189.1, C190.1, C191.1, C192.1, C193.1, C194.1, C195.1, C196.1, C197.1, C198.1, C199.1, C200.2, C201.2, C202.2, C203.1, C204.1, C205.1, C206.1, C207.1, C208.1, C209.1, C210.1, C211.1, C212.1, C213.1, C214.1, C215.1, C216.1, C217.1, C218.1, C219.1, D33.3 (common), D34.1 (K), D35.1 (K), J10.3 (VSS_Ground), R100.2, R119.2, R121.2, SW1.2, U40.5 (GND), U41.6 (VSS), U41.31 (VSS)
IMON1: J11.1, R85.2
IMON2: J11.2, R87.2
IMON3: J11.3, R110.2
IMON4: J11.4, R112.2
IMON5: J11.5, R93.2
IMON6: J11.6, R95.2
IMON7: J11.7, R114.2
IMON8: J11.8, R102.2
IMON9: J11.9, R104.2
IMON10: J11.10, R106.2
IMON11: J11.11, R81.2
IMON12: J11.12, R108.2
IMON13: J11.13, R115.2
IMON14: J11.14, R88.2
IMON15: J11.15, R90.2
IMON16: J11.16, R117.2
INT: R79.2, U41.45 (RD3)
MCLR: D31.1 (K), J10.1 (~MCLR/Vpp), U41.20 (VPP/~MCLR/RE3)
unnamed: C183.2, R80.1, U41.29 (RE2)
unnamed: C184.2, R81.1, U41.28 (RE1)
unnamed: C185.2, R82.1, U41.27 (RE0)
unnamed: C186.2, R83.1, U41.44 (RD2)
unnamed: C187.1, D31.2 (A), D32.2 (A), R96.2, SW1.1
unnamed: C188.2, R84.1, U41.2 (RD4)
unnamed: C189.2, R85.1, U41.3 (RD5)
unnamed: C190.2, R86.1, U41.4 (RD6)
unnamed: C191.2, R87.1, U41.5 (RD7)
unnamed: C192.2, R88.1, U41.36 (RF0)
unnamed: C193.2, R89.1, U41.37 (RF1)
unnamed: C194.2, R90.1, U41.38 (RF2)
unnamed: C195.2, R91.1, U41.39 (RF3)
unnamed: C196.2, R92.1, U41.12 (RF4)
unnamed: C197.2, R93.1, U41.13 (RF5)
unnamed: C198.2, R94.1, U41.14 (RF6)
unnamed: C199.2, R95.1, U41.15 (RF7)
unnamed: C203.2, R101.1, U41.21 (RA0)
unnamed: C204.2, R102.1, U41.22 (RA1)
unnamed: C205.2, R117.1, U41.40 (RC2)
unnamed: C206.2, R103.1, U41.23 (RA2)
unnamed: C207.2, R116.1, U41.35 (RC1)
unnamed: C208.2, R104.1, U41.24 (RA3)
unnamed: C209.2, R115.1, U41.34 (RC0)
unnamed: C210.2, R105.1, U41.25 (RA4)
unnamed: C211.2, R114.1, U41.17 (RB5)
unnamed: C212.2, R106.1, U41.26 (RA5)
unnamed: C213.2, R113.1, U41.16 (RB4)
unnamed: C214.2, R107.1, U41.33 (RA6)
unnamed: C215.2, R112.1, U41.11 (RB3)
unnamed: C216.2, R108.1, U41.32 (RA7)
unnamed: C217.2, R111.1, U41.10 (RB2)
unnamed: C218.2, R110.1, U41.9 (RB1)
unnamed: C219.2, R109.1, U41.8 (RB0)
unnamed: D34.2 (A), R118.1
unnamed: D35.2 (A), R120.1
unnamed: R97.2, U40.7 (B)
unnamed: R98.2, U40.6 (A)
PGC: J10.5 (ICSPCLK/PGC), U41.18 (ICSPCLK/RB6)
PGD: J10.4 (ICSPDAT/PGD), U41.19 (ICSPDAT/RB7)
PMON1: J12.1, R84.2
PMON2: J12.2, R86.2
PMON3: J12.3, R109.2
PMON4: J12.4, R111.2
PMON5: J12.5, R92.2
PMON6: J12.6, R94.2
PMON7: J12.7, R113.2
PMON8: J12.8, R101.2
PMON9: J12.9, R103.2
PMON10: J12.10, R105.2
PMON11: J12.11, R82.2
PMON12: J12.12, R80.2
PMON13: J12.13, R107.2
PMON14: J12.14, R116.2
PMON15: J12.15, R89.2
PMON16: J12.16, R91.2
RC3/SCK1: JP2.2 (B), R121.1, U41.41 (RC3)
RC4/SDA1: R120.2, U41.46 (RC4)
RC5: U40.4 (DI), U41.47 (RC5)
RC6: R100.1, U40.2 (~RE), U40.3 (DE), U41.48 (RC6)
RC7: R99.2, U40.1 (RO), U41.1 (RC7)
RD0/SCK2: JP1.2 (B), R119.1, U41.42 (RD0)
RD1/SDA2: R118.2, U41.43 (RD1)

Notes on the sheet:
Vimon = 2.38 x Iout For load current of 0.250, Imon = 0.6 Volts (aprx.)
VRMS = 7.5 x Vrfin (RMS) dBm = 30 + 20xlog(VRMS/SQRT(50))
SCK2
PMON2
IMON12
CURRECT MONITOR DEBUG HEADER
PMON10
IMON11
IMON13
Auxilliary Configuration/Monitoring
PMON9
IMON6
RD485_DE
IMON8
RD485_R
IMON10
RS485
PMON1
IMON4
PMON8
PMON7
IMON16
IMON14
SDA1
PMON11
POWER MONITOR DEBUG HEADER
IMON7
PMON12
IMON5
IMON3
IMON1
SDA2
PMON16
RD485_D
PMON15
PMON6
IMON9
PMON3
PMON4
PMON13
BRD_IMON
PMON14
INT
PMON5
IMON15
IMON2
SCK1
