lwa-project/analog_receiver/ARX Rev I/Power.kicad_sch

## KiCad design ARX Rev I/Power.kicad_sch (2025-10-08)

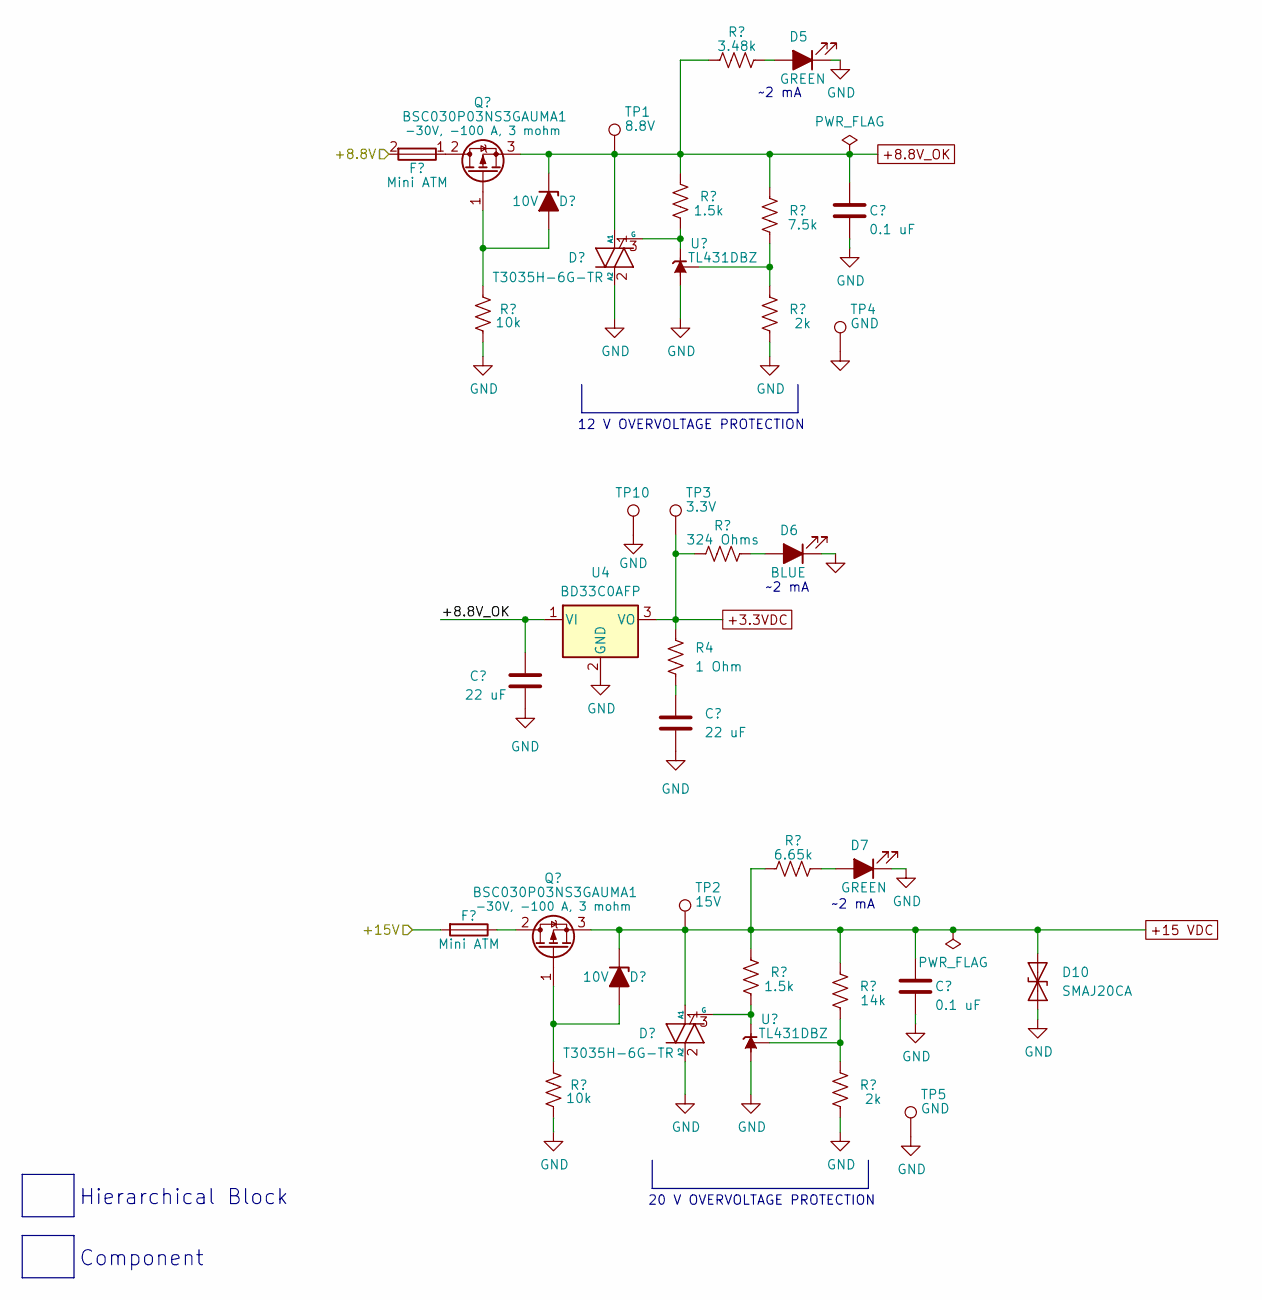
[picture p116: schematic Power.kicad_sch]

Parts:
C1, C2: 22 uF; C_1206_3216Metric_Pad1.33x1.80mm_HandSolder; Tolerance 10%; Voltage Rating 16 V; MPN EMK316BB7226ML-T
C3, C4: 0.1 uF; C_0805_2012Metric_Pad1.18x1.45mm_HandSolder; Tolerance 10%; Voltage Rating 25 V; MPN CC0805KRX7R8BB104
D1, D2: 10V; D_SMB; Tolerance NA; Voltage Rating 10 V; MPN 3SMBJ5925B-TP
D3, D4: T3035H-6G-TR; TO-263-2; Tolerance NA; Voltage Rating 600 V; MPN T3035H-6G-TR
D5, D7: GREEN; LED_1206_3216Metric_Pad1.42x1.75mm_HandSolder; Voltage Rating 1.9 V Forward; MPN APTD3216LCGCK
D6: BLUE; LED_1206_3216Metric_Pad1.42x1.75mm_HandSolder; Voltage Rating 2.65 V Forward; MPN APT3216LVBC/D
D10: SMAJ20CA; D_SMA; Voltage Rating 20 V Standoff, 22.2 V Breakdown, 32.4 V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; MPN SMAJ20CA
F1, F2: Mini ATM; Fuseholder_Blade_Mini_Keystone_3568_3D_Fuse; Tolerance NA; Voltage Rating 500 V; MPN 3568
Q1, Q2: BSC030P03NS3GAUMA1; TDSON-8-1_3_PIN; Tolerance NA; Voltage Rating 20 v; MPN DMP2002UPS-13
R1, R2: 10k; R_0805_2012Metric_Pad1.20x1.40mm_HandSolder; Tolerance 1%; Voltage Rating 150 V; MPN RC0805FR-0710KL
R3, R7: 1.5k; R_0805_2012Metric_Pad1.20x1.40mm_HandSolder; Tolerance 1%; Voltage Rating 150 V; MPN RNCP0805FTD1K50
R4: 1 Ohm; R_0805_2012Metric_Pad1.20x1.40mm_HandSolder; Tolerance 1%; MPN RC0805FR-071RL
R5: 3.48k; R_0805_2012Metric_Pad1.20x1.40mm_HandSolder; Tolerance 1%; Voltage Rating 150 V; MPN RC0805FR-073K48L
R6: 324 Ohms; R_0805_2012Metric_Pad1.20x1.40mm_HandSolder; Tolerance 1%; Voltage Rating 150 V; MPN RC0805FR-07324RL
R8: 7.5k; R_0805_2012Metric_Pad1.20x1.40mm_HandSolder; Tolerance 1%; Voltage Rating 150 V; MPN RC0805FR-077K5L
R9, R12: 2k; R_0805_2012Metric_Pad1.20x1.40mm_HandSolder; Tolerance 1%; Voltage Rating 150 V; MPN RC0805FR-072KL
R10: 6.65k; R_0805_2012Metric_Pad1.20x1.40mm_HandSolder; Tolerance 1%; Voltage Rating 150 V; MPN RMCF0805FT6K65
R11: 14k; R_0805_2012Metric_Pad1.20x1.40mm_HandSolder; Tolerance 1%; Voltage Rating 150 V; MPN RC0805FR-0714KL
TP1: 8.8V; Harwin_TP_S1751-46R; MPN S1751-46R
TP2: 15V; Harwin_TP_S1751-46R; MPN S1751-46R
TP3: 3.3V; Harwin_TP_S1751-46R; MPN S1751-46R
TP4, TP5, TP10: GND; Harwin_TP_S1751-46R; MPN S1751-46R
U4: BD33C0AFP; TO-252-3; MPN BD33C0AFP-CE2
U5, U6: TL431DBZ; SOT-23; Tolerance NA; Voltage Rating NA; MPN TL431CDBZR

Connections:
+3.3VDC: R4.1, R6.2, TP3.1, U4.3 (VO)
+8.8V: F1.2
+8.8V_OK: C1.1, C3.1, D1.1 (K), D3.1 (A1), Q1.3 (S), R3.2, R5.2, R8.2, TP1.1, U4.1 (VI)
+15 VDC: C4.1, D2.1 (K), D4.1 (A1), D10.2 (A2), Q2.3 (S), R7.2, R10.2, R11.2, TP2.1
+15V: F2.2
GND: C1.2, C2.2, C3.2, C4.2, D3.2 (A2), D4.2 (A2), D5.1 (K), D6.1 (K), D7.1 (K), D10.1 (A1), R1.1, R2.1, R9.1, R12.1, TP4.1, TP5.1, TP10.1, U4.2 (GND), U5.3 (A), U6.3 (A)
unnamed: C2.1, R4.2
unnamed: D1.2 (A), Q1.1 (G), R1.2
unnamed: D2.2 (A), Q2.1 (G), R2.2
unnamed: D3.3 (G), R3.1, U5.1 (K)
unnamed: D4.3 (G), R7.1, U6.1 (K)
unnamed: D5.2 (A), R5.1
unnamed: D6.2 (A), R6.1
unnamed: D7.2 (A), R10.1
unnamed: F1.1, Q1.2 (D)
unnamed: F2.1, Q2.2 (D)
unnamed: R8.1, R9.2, U5.2 (REF)
unnamed: R11.1, R12.2, U6.2 (REF)

Notes on the sheet:
~2 mA
12 V OVERVOLTAGE PROTECTION
20 V OVERVOLTAGE PROTECTION
Component
Hierarchical Block
