lwa-project/analog_receiver/ARX Rev I/Power_Montior.kicad_sch

## KiCad design ARX Rev I/Power_Montior.kicad_sch (2025-10-08)

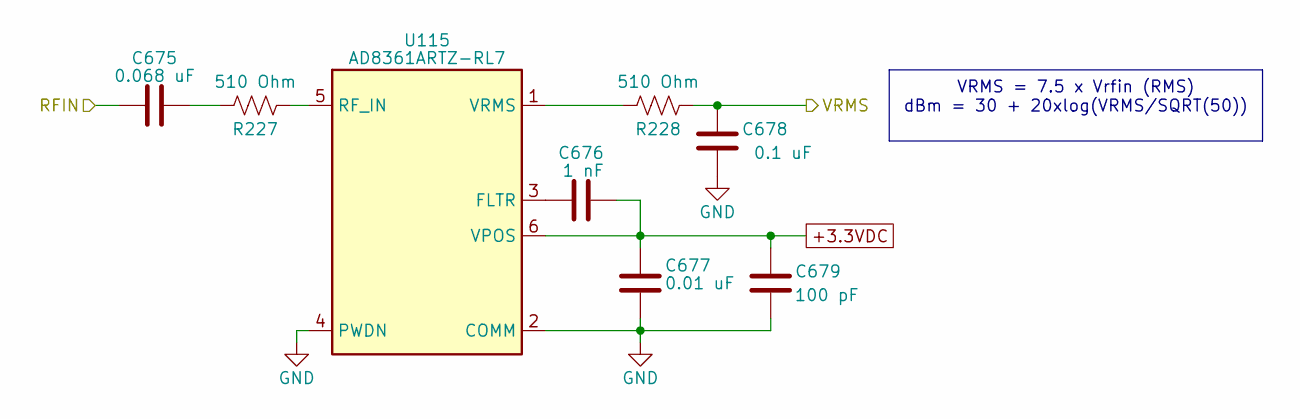
[picture p117: schematic Power_Montior.kicad_sch]

Parts:
C675: 0.068 uF; C_0805_2012Metric_Pad1.18x1.45mm_HandSolder; Tolerance 10%; Voltage Rating 50V; MPN DNI
C676: 1 nF; C_0805_2012Metric_Pad1.18x1.45mm_HandSolder; Tolerance 10%; Voltage Rating 50V; MPN KGM21NR71H102KT
C677: 0.01 uF; C_0805_2012Metric_Pad1.18x1.45mm_HandSolder; Tolerance 10%; Voltage Rating 50V; MPN CC0805KRX7R9BB103
C678: 0.1 uF; C_0805_2012Metric_Pad1.18x1.45mm_HandSolder; Tolerance 10%; Voltage Rating 25 V; MPN CC0805KRX7R8BB104
C679: 100 pF; C_1206_3216Metric_Pad1.6x1.8mm; Tolerance 10%; Voltage Rating 250 V; MPN C1206X101KDRACTU
R227, R228: 510 Ohm; R_0805_2012Metric_Pad1.20x1.40mm_HandSolder; Tolerance 1%; Voltage Rating 150 V; MPN RC0805FR-07510RL
U115: AD8361ARTZ-RL7; SOT-23-6; MPN DNI

Connections:
+3.3VDC: C676.2, C677.2, C679.2, U115.6 (VPOS)
GND: C677.1, C678.1, C679.1, U115.2 (COMM), U115.4 (PWDN)
unnamed: C675.2, R227.2
unnamed: C676.1, U115.3 (FLTR)
unnamed: R227.1, U115.5 (RF_IN)
unnamed: R228.2, U115.1 (VRMS)
RFIN: C675.1
VRMS: C678.2, R228.1

Notes on the sheet:
VRMS = 7.5 x Vrfin (RMS) dBm = 30 + 20xlog(VRMS/SQRT(50))
