lwa-project/analog_receiver/ARX Rev I/Rx_Channel.kicad_sch

## KiCad design ARX Rev I/Rx_Channel.kicad_sch (2025-10-08)

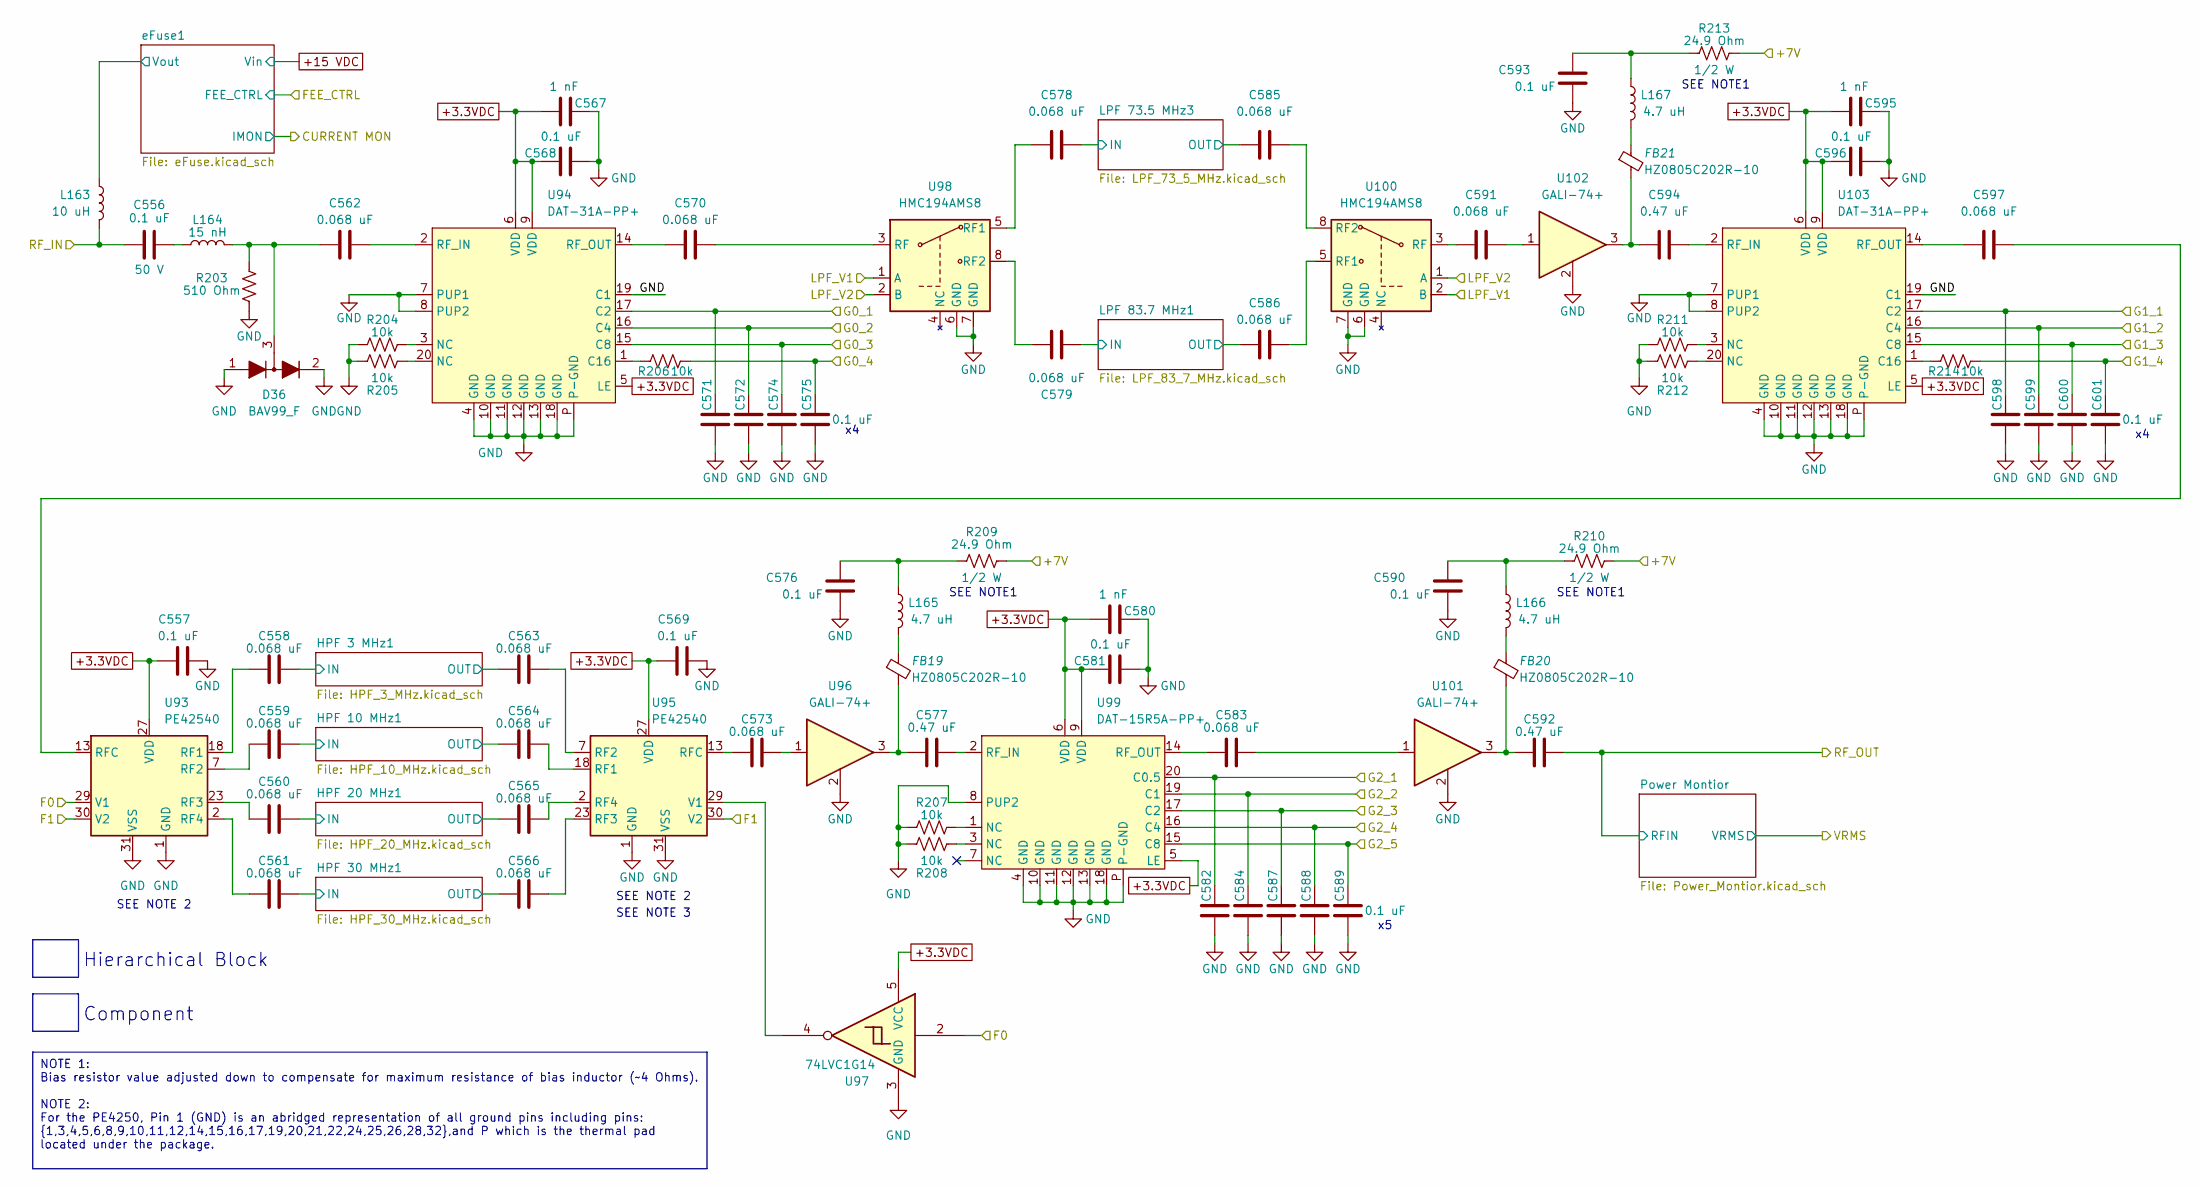
[picture p118: schematic Rx_Channel.kicad_sch]

Parts:
C556: 0.1 uF; C_0603_1608Metric_Pad1.08x0.95mm_HandSolder; Tolerance 10%; Voltage Rating 50 V; MPN 885012206095
C557, C568, C569, C581, C596: 0.1 uF; C_0805_2012Metric_Pad1.18x1.45mm_HandSolder; Tolerance 10%; Voltage Rating 25 V; MPN CC0805KRX7R8BB104
C558, C559, C560, C561, C562, C563, C564, C565, C566, C570, C573, C578, C579, C583, C585, C586, C591, C597: 0.068 uF; C_0603_1608Metric_Pad1.08x0.95mm_HandSolder; Tolerance 10%; Voltage Rating 16 V; MPN 885012206045
C567, C580, C595: 1 nF; C_0805_2012Metric_Pad1.18x1.45mm_HandSolder; Tolerance 10%; Voltage Rating 50V; MPN KGM21NR71H102KT
C571, C572, C574, C575, C576, C582, C584, C587, C588, C589, C590, C593, C598, C599, C600, C601: 0.1 uF; C_1206_3216Metric_Pad1.6x1.8mm; Tolerance 10%; Voltage Rating 250 V; MPN CC1206KKX7RYBB104
C577, C592, C594: 0.47 uF; C_0603_1608Metric_Pad1.08x0.95mm_HandSolder; Tolerance 10%; Voltage Rating 16 V; MPN 885012206050
D36: BAV99_F; SOT-23; MPN BAV99-7-F
FB19, FB20, FB21: HZ0805C202R-10; L_0805_2012Metric_Pad1.15x1.40mm_HandSolder; Tolerance NA; Voltage Rating NA; MPN HZ0805C202R-10
L163: 10 uH; 1205POC; Tolerance 20%; MPN 1205POC-103
L164: 15 nH; L_0805_2012Metric_Pad1.15x1.40mm_HandSolder; Tolerance 2%; MPN 0805HP-15NXGRC
L165, L166, L167: 4.7 uH; 1008CS; Tolerance 5%; Voltage Rating NA; MPN 1008CS-472XJLC
R203: 510 Ohm; R_0805_2012Metric_Pad1.20x1.40mm_HandSolder; Tolerance 1%; Voltage Rating 150 V; MPN RC0805FR-07510RL
R204, R205, R206, R207, R208, R211, R212, R214: 10k; R_0805_2012Metric_Pad1.20x1.40mm_HandSolder; Tolerance 1%; Voltage Rating 150 V; MPN RC0805FR-0710KL
R209, R210, R213: 24.9 Ohm; R_1210_3225Metric_Pad1.30x2.65mm_HandSolder; Tolerance 1%; Voltage Rating NA; MPN ESR18EZPF24R9
U93, U95: PE42540; LGA-32-1EP_5x5mm_P0.5mm_EP3.08x3.08mm; MPN PE42540G-Z
U94, U103: DAT-31A-PP+; DG983-2; MPN DAT-31A-PP+
U96, U101, U102: GALI-74+; MCL_Gali; MPN GALI-74+
U97: 74LVC1G14; SOT-23-5_HandSoldering; MPN SN74LVC1G14DBVT
U98, U100: HMC194AMS8; MSOP-8_3x3mm_P0.65mm; MPN HMC194AMS8ETR
U99: DAT-15R5A-PP+; DG983-2; MPN DAT-15R5A-PP+

Connections:
+3.3VDC: C557.1, C567.2, C568.1, C569.1, C580.2, C581.1, C595.2, C596.1, U93.27 (VDD), U94.5 (LE), U94.6 (VDD), U94.9 (VDD), U95.27 (VDD), U97.5 (VCC), U99.5 (LE), U99.6 (VDD), U99.9 (VDD), U103.5 (LE), U103.6 (VDD), U103.9 (VDD)
+7V: R209.1, R210.1, R213.1
F0: U93.29 (V1), U97.2
F1: U93.30 (V2), U95.30 (V2)
G0_1: C571.2, U94.17 (C2)
G0_2: C572.2, U94.16 (C4)
G0_3: C574.2, U94.15 (C8)
G0_4: C575.2, R206.1
G1_1: C598.2, U103.17 (C2)
G1_2: C599.2, U103.16 (C4)
G1_3: C600.2, U103.15 (C8)
G1_4: C601.2, R214.1
G2_1: C582.2, U99.20 (C0.5)
G2_2: C584.2, U99.19 (C1)
G2_3: C587.2, U99.17 (C2)
G2_4: C588.2, U99.16 (C4)
G2_5: C589.2, U99.15 (C8)
GND: C557.2, C567.1, C568.2, C569.2, C571.1, C572.1, C574.1, C575.1, C576.1, C580.1, C581.2, C582.1, C584.1, C587.1, C588.1, C589.1, C590.1, C593.1, C595.1, C596.2, C598.1, C599.1, C600.1, C601.1, D36.1 (K), D36.2 (A), R203.2, R204.2, R205.2, R207.2, R208.2, R211.2, R212.2, U93.1 (GND), U93.3 (GND), U93.4 (GND), U93.5 (GND), U93.6 (GND), U93.8 (GND), U93.9 (GND), U93.10 (GND), U93.11 (GND), U93.12 (GND), U93.14 (GND), U93.15 (GND), U93.16 (GND), U93.17 (GND), U93.19 (GND), U93.20 (GND), U93.21 (GND), U93.22 (GND), U93.24 (GND), U93.25 (GND), U93.26 (GND), U93.28 (GND), U93.31 (VSS), U93.32 (GND), U93.P (GND), U94.4 (GND), U94.7 (PUP1), U94.8 (PUP2), U94.10 (GND), U94.11 (GND), U94.12 (GND), U94.13 (GND), U94.18 (GND), U94.19 (C1), U94.P (P-GND), U95.1 (GND), U95.3 (GND), U95.4 (GND), U95.5 (GND), U95.6 (GND), U95.8 (GND), U95.9 (GND), U95.10 (GND), U95.11 (GND), U95.12 (GND), U95.14 (GND), U95.15 (GND), U95.16 (GND), U95.17 (GND), U95.19 (GND), U95.20 (GND), U95.21 (GND), U95.22 (GND), U95.24 (GND), U95.25 (GND), U95.26 (GND), U95.28 (GND), U95.31 (VSS), U95.32 (GND), U95.P (GND), U96.2, U97.3 (GND), U98.6 (GND), U98.7 (GND), U99.4 (GND), U99.8 (PUP2), U99.10 (GND), U99.11 (GND), U99.12 (GND), U99.13 (GND), U99.18 (GND), U99.P (P-GND), U100.6 (GND), U100.7 (GND), U101.2, U102.2, U103.4 (GND), U103.7 (PUP1), U103.8 (PUP2), U103.10 (GND), U103.11 (GND), U103.12 (GND), U103.13 (GND), U103.18 (GND), U103.19 (C1), U103.P (P-GND)
IN: C558.1, C559.1, C560.1, C561.1, C578.2, C579.2
LPF_V1: U98.1 (A), U100.2 (B)
LPF_V2: U98.2 (B), U100.1 (A)
unnamed: C556.2, L164.1
unnamed: C558.2, U93.18 (RF1)
unnamed: C559.2, U93.7 (RF2)
unnamed: C560.2, U93.23 (RF3)
unnamed: C561.2, U93.2 (RF4)
unnamed: C562.1, D36.3 (K), L164.2, R203.1
unnamed: C562.2, U94.2 (RF_IN)
unnamed: C563.2, U95.7 (RF2)
unnamed: C564.2, U95.18 (RF1)
unnamed: C565.2, U95.2 (RF4)
unnamed: C566.2, U95.23 (RF3)
unnamed: C570.1, U94.14 (RF_OUT)
unnamed: C570.2, U98.3 (RF)
unnamed: C573.1, U95.13 (RFC)
unnamed: C573.2, U96.1
unnamed: C576.2, L165.1, R209.2
unnamed: C577.1, FB19.2, U96.3
unnamed: C577.2, U99.2 (RF_IN)
unnamed: C578.1, U98.5 (RF1)
unnamed: C579.1, U98.8 (RF2)
unnamed: C583.1, U99.14 (RF_OUT)
unnamed: C583.2, U101.1
unnamed: C585.1, U100.8 (RF2)
unnamed: C586.1, U100.5 (RF1)
unnamed: C590.2, L166.1, R210.2
unnamed: C591.1, U100.3 (RF)
unnamed: C591.2, U102.1
unnamed: C592.1, FB20.2, U101.3
unnamed: C593.2, L167.1, R213.2
unnamed: C594.1, FB21.2, U102.3
unnamed: C594.2, U103.2 (RF_IN)
unnamed: C597.1, U103.14 (RF_OUT)
unnamed: C597.2, U93.13 (RFC)
unnamed: FB19.1, L165.2
unnamed: FB20.1, L166.2
unnamed: FB21.1, L167.2
unnamed: R204.1, U94.3 (NC)
unnamed: R205.1, U94.20 (NC)
unnamed: R206.2, U94.1 (C16)
unnamed: R207.1, U99.1 (NC)
unnamed: R208.1, U99.3 (NC)
unnamed: R211.1, U103.3 (NC)
unnamed: R212.1, U103.20 (NC)
unnamed: R214.2, U103.1 (C16)
unnamed: U95.29 (V1), U97.4
OUT: C563.1, C564.1, C565.1, C566.1, C585.2, C586.2
RF_IN: C556.1, L163.1
RF_OUT: C592.2
Vout: L163.2

Notes on the sheet:
NOTE 1: Bias resistor value adjusted down to compensate for maximum resistance of bias inductor (~4 Ohms). NOTE 2: For the PE4250, Pin 1 (GND) is an abridged representation of all ground pins including pins: {1,3,4,5,6,8,9,10,11,12,14,15,16,17,19,20,21,22,24,25,26,28,32},and P which is the thermal 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
SEE NOTE1
Hierarchical Block
SEE NOTE 2
Component
SEE NOTE 3
