lwa-project/analog_receiver/ARX Rev I/SPI_Buffer.kicad_sch

## KiCad design ARX Rev I/SPI_Buffer.kicad_sch (2025-10-08)

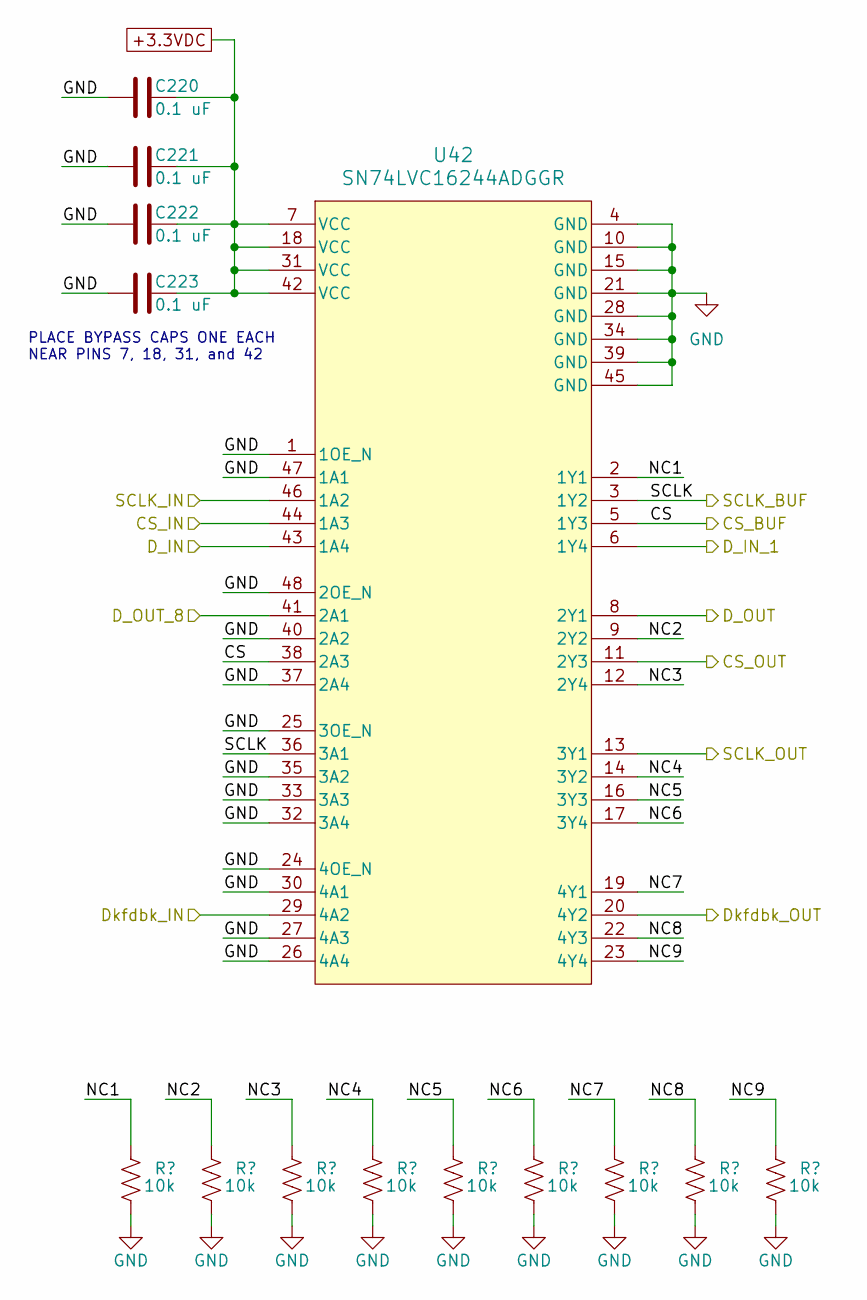
[picture p119: schematic SPI_Buffer.kicad_sch]

Parts:
C220, C221, C222, C223: 0.1 uF; C_1206_3216Metric_Pad1.6x1.8mm; Tolerance 10%; Voltage Rating 250 V; MPN CC1206KKX7RYBB104
R122, R123, R124, R125, R126, R127, R128, R129, R130: 10k; R_0805_2012Metric_Pad1.20x1.40mm_HandSolder; Tolerance 1%; Voltage Rating 150 V; MPN RC0805FR-0710KL
U42: SN74LVC16244ADGGR; TSSOP-48_6.1x12.5mm_P0.5mm; MPN SN74LVC16244ADGGR

Connections:
+3.3VDC: C220.1, C221.1, C222.1, C223.1, U42.7 (VCC), U42.18 (VCC), U42.31 (VCC), U42.42 (VCC)
CS: U42.5 (1Y3), U42.38 (2A3)
CS_IN: U42.44 (1A3)
CS_OUT: U42.11 (2Y3)
D_IN: U42.43 (1A4)
D_IN_1: U42.6 (1Y4)
D_OUT: U42.8 (2Y1)
D_OUT_8: U42.41 (2A1)
Dkfdbk_IN: U42.29 (4A2)
Dkfdbk_OUT: U42.20 (4Y2)
GND: C220.2, C221.2, C222.2, C223.2, R122.2, R123.2, R124.2, R125.2, R126.2, R127.2, R128.2, R129.2, R130.2, U42.1 (1OE_N), U42.4 (GND), U42.10 (GND), U42.15 (GND), U42.21 (GND), U42.24 (4OE_N), U42.25 (3OE_N), U42.26 (4A4), U42.27 (4A3), U42.28 (GND), U42.30 (4A1), U42.32 (3A4), U42.33 (3A3), U42.34 (GND), U42.35 (3A2), U42.37 (2A4), U42.39 (GND), U42.40 (2A2), U42.45 (GND), U42.47 (1A1), U42.48 (2OE_N)
NC1: R122.1, U42.2 (1Y1)
NC2: R123.1, U42.9 (2Y2)
NC3: R124.1, U42.12 (2Y4)
NC4: R125.1, U42.14 (3Y2)
NC5: R126.1, U42.16 (3Y3)
NC6: R127.1, U42.17 (3Y4)
NC7: R128.1, U42.19 (4Y1)
NC8: R129.1, U42.22 (4Y3)
NC9: R130.1, U42.23 (4Y4)
SCLK: U42.3 (1Y2), U42.36 (3A1)
SCLK_IN: U42.46 (1A2)
SCLK_OUT: U42.13 (3Y1)

Notes on the sheet:
PLACE BYPASS CAPS ONE EACH NEAR PINS 7, 18, 31, and 42
