lwa-project/analog_receiver/ARX Rev I/SPI_Cascade.kicad_sch

## KiCad design ARX Rev I/SPI_Cascade.kicad_sch (2025-10-08)

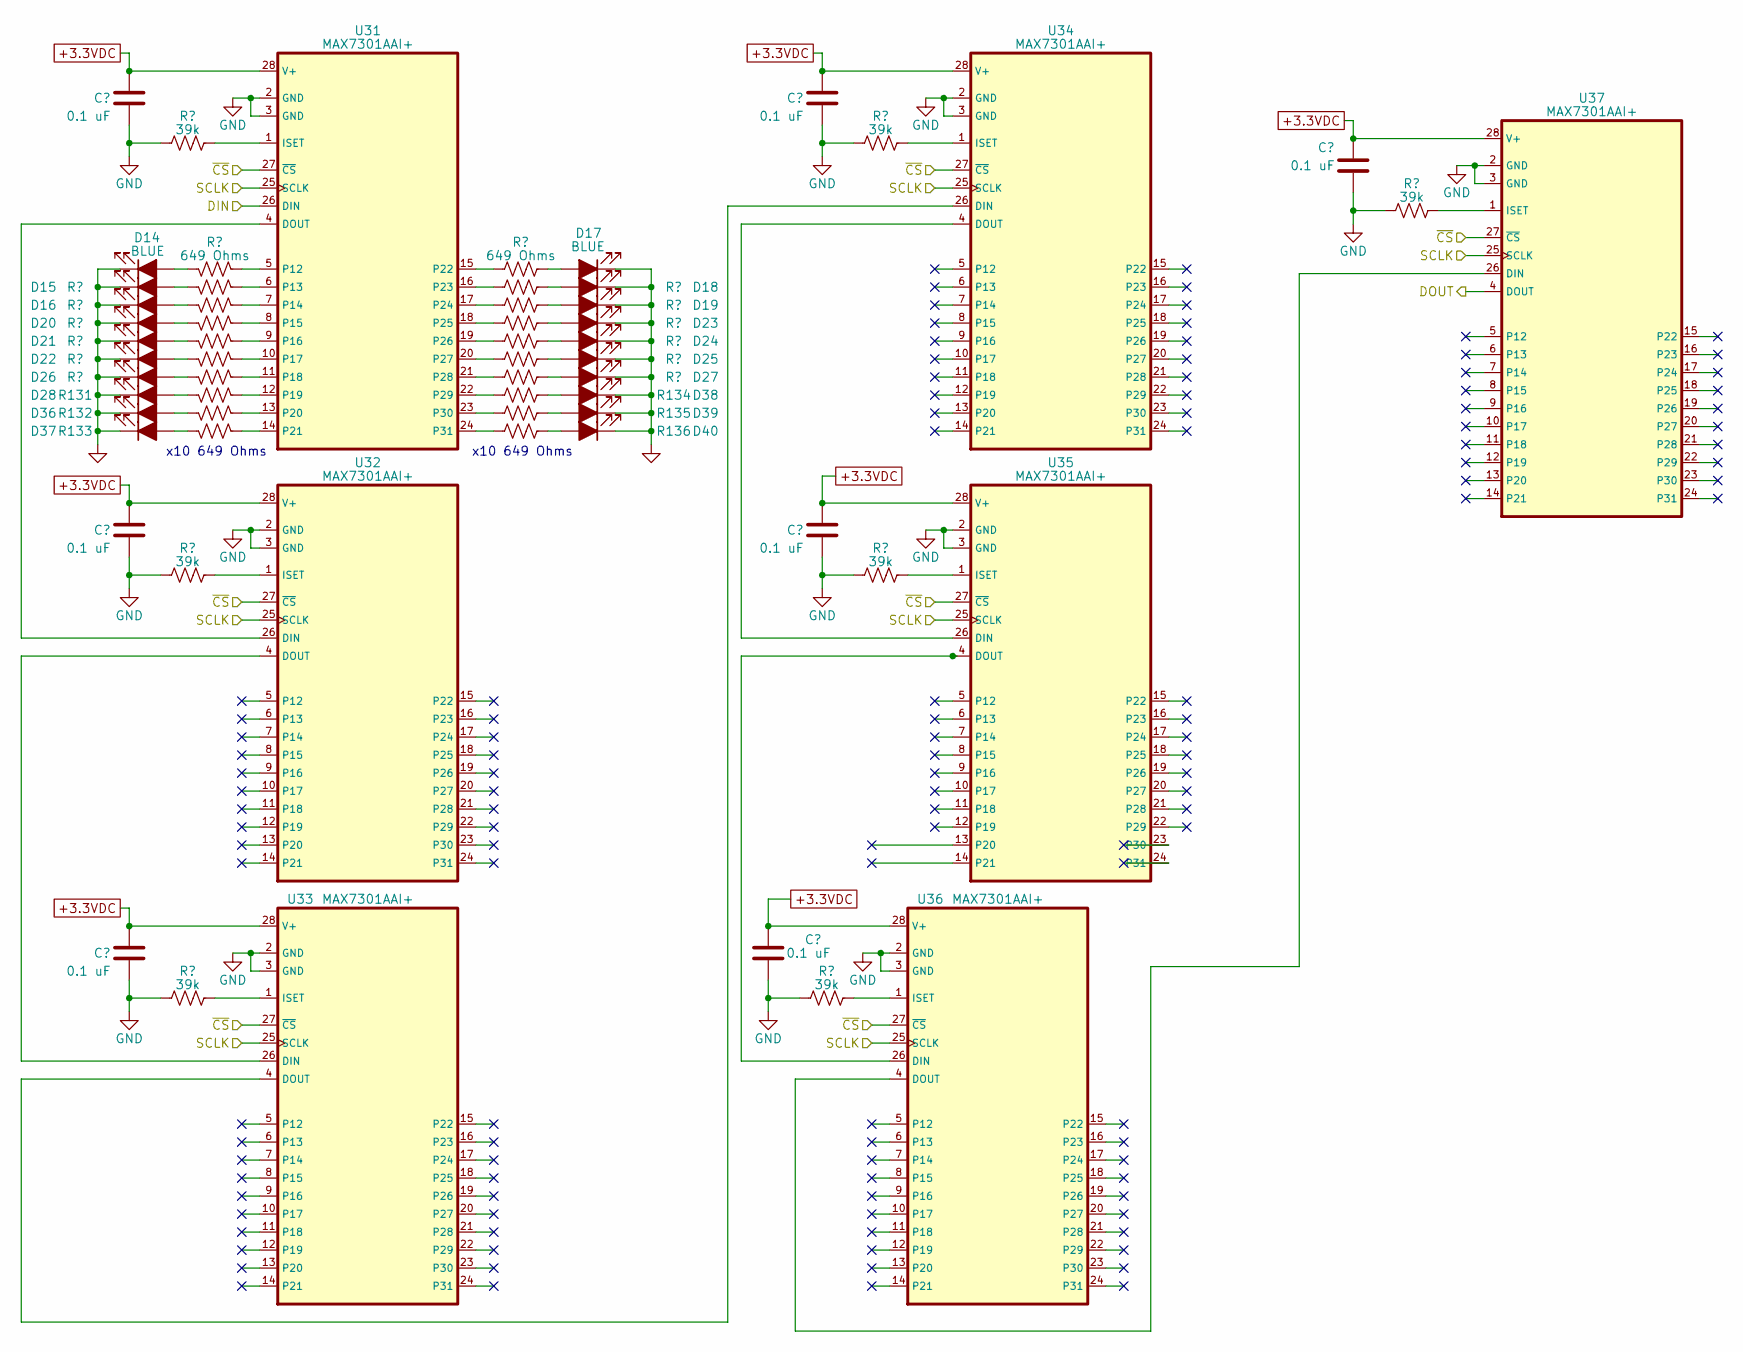
[picture p120: schematic SPI_Cascade.kicad_sch]

Parts:
C160, C161, C162, C163, C164, C165, C166: 0.1 uF; C_0805_2012Metric_Pad1.18x1.45mm_HandSolder; Tolerance 10%; Voltage Rating 25 V; MPN CC0805KRX7R8BB104
D14, D15, D16, D17, D18, D19, D20, D21, D22, D23, D24, D25, D26, D27, D28, D36, D37, D38, D39, D40: BLUE; LED_1206_3216Metric_Pad1.42x1.75mm_HandSolder; Voltage Rating 2.65 V Forward; MPN APT3216LVBC/D
R51, R52, R53, R60, R61, R62, R69: 39k; R_0805_2012Metric_Pad1.20x1.40mm_HandSolder; Tolerance 1%; Voltage Rating 150 V; MPN RC0805FR-0739KL
R54, R55, R56, R57, R58, R59, R63, R64, R65, R66, R67, R68, R70, R71, R131, R132, R133, R134, R135, R136: 649 Ohms; R_0805_2012Metric_Pad1.20x1.40mm_HandSolder; Tolerance 1%; Voltage Rating 150 V; MPN RC0805FR-07649RL
U31, U32, U33, U34, U35, U36, U37: MAX7301AAI+; SSOP-28_5.3x10.2mm_P0.65mm; MPN MAX7301AAI+

Connections:
+3.3VDC: C160.1, C161.1, C162.1, C163.1, C164.1, C165.1, C166.1, U31.28 (V+), U32.28 (V+), U33.28 (V+), U34.28 (V+), U35.28 (V+), U36.28 (V+), U37.28 (V+)
DIN: U31.26 (DIN)
DOUT: U37.4 (DOUT)
GND: C160.2, C161.2, C162.2, C163.2, C164.2, C165.2, C166.2, D14.1 (K), D15.1 (K), D16.1 (K), D17.1 (K), D18.1 (K), D19.1 (K), D20.1 (K), D21.1 (K), D22.1 (K), D23.1 (K), D24.1 (K), D25.1 (K), D26.1 (K), D27.1 (K), D28.1 (K), D36.1 (K), D37.1 (K), D38.1 (K), D39.1 (K), D40.1 (K), R51.2, R52.2, R53.2, R60.2, R61.2, R62.2, R69.2, U31.2 (GND), U31.3 (GND), U32.2 (GND), U32.3 (GND), U33.2 (GND), U33.3 (GND), U34.2 (GND), U34.3 (GND), U35.2 (GND), U35.3 (GND), U36.2 (GND), U36.3 (GND), U37.2 (GND), U37.3 (GND)
unnamed: D14.2 (A), R54.1
unnamed: D15.2 (A), R55.1
unnamed: D16.2 (A), R56.1
unnamed: D17.2 (A), R57.1
unnamed: D18.2 (A), R58.1
unnamed: D19.2 (A), R59.1
unnamed: D20.2 (A), R63.1
unnamed: D21.2 (A), R64.1
unnamed: D22.2 (A), R65.1
unnamed: D23.2 (A), R66.1
unnamed: D24.2 (A), R67.1
unnamed: D25.2 (A), R68.1
unnamed: D26.2 (A), R70.1
unnamed: D27.2 (A), R71.1
unnamed: D28.2 (A), R131.1
unnamed: D36.2 (A), R132.1
unnamed: D37.2 (A), R133.1
unnamed: D38.2 (A), R134.1
unnamed: D39.2 (A), R135.1
unnamed: D40.2 (A), R136.1
unnamed: R51.1, U31.1 (ISET)
unnamed: R52.1, U32.1 (ISET)
unnamed: R53.1, U33.1 (ISET)
unnamed: R54.2, U31.5 (P12)
unnamed: R55.2, U31.6 (P13)
unnamed: R56.2, U31.7 (P14)
unnamed: R57.2, U31.15 (P22)
unnamed: R58.2, U31.16 (P23)
unnamed: R59.2, U31.17 (P24)
unnamed: R60.1, U34.1 (ISET)
unnamed: R61.1, U35.1 (ISET)
unnamed: R62.1, U36.1 (ISET)
unnamed: R63.2, U31.8 (P15)
unnamed: R64.2, U31.9 (P16)
unnamed: R65.2, U31.10 (P17)
unnamed: R66.2, U31.18 (P25)
unnamed: R67.2, U31.19 (P26)
unnamed: R68.2, U31.20 (P27)
unnamed: R69.1, U37.1 (ISET)
unnamed: R70.2, U31.11 (P18)
unnamed: R71.2, U31.21 (P28)
unnamed: R131.2, U31.12 (P19)
unnamed: R132.2, U31.13 (P20)
unnamed: R133.2, U31.14 (P21)
unnamed: R134.2, U31.22 (P29)
unnamed: R135.2, U31.23 (P30)
unnamed: R136.2, U31.24 (P31)
unnamed: U31.4 (DOUT), U32.26 (DIN)
unnamed: U32.4 (DOUT), U33.26 (DIN)
unnamed: U33.4 (DOUT), U34.26 (DIN)
unnamed: U34.4 (DOUT), U35.26 (DIN)
unnamed: U35.4 (DOUT), U36.26 (DIN)
unnamed: U36.4 (DOUT), U37.26 (DIN)
SCLK: U31.25 (SCLK), U32.25 (SCLK), U33.25 (SCLK), U34.25 (SCLK), U35.25 (SCLK), U36.25 (SCLK), U37.25 (SCLK)
~CS: U31.27 (~CS), U32.27 (~CS), U33.27 (~CS), U34.27 (~CS), U35.27 (~CS), U36.27 (~CS), U37.27 (~CS)

Notes on the sheet:
x10 649 Ohms
