lwa-project/analog_receiver/ARX Rev I/eFuse.kicad_sch

## KiCad design ARX Rev I/eFuse.kicad_sch (2025-10-08)

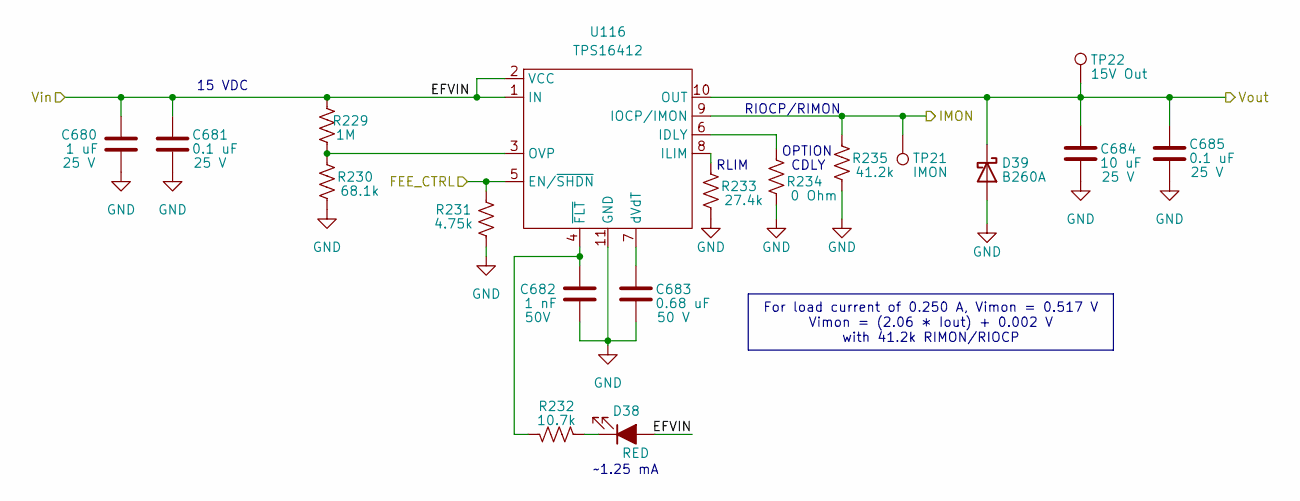
[picture p121: schematic eFuse.kicad_sch]

Parts:
C680: 1 uF; C_0805_2012Metric_Pad1.18x1.45mm_HandSolder; Tolerance 10%; Voltage Rating 25 V; MPN CC0805KFX7R8BB105
C681, C685: 0.1 uF; C_0805_2012Metric_Pad1.18x1.45mm_HandSolder; Tolerance 10%; Voltage Rating 25 V; MPN CC0805KRX7R8BB104
C682: 1 nF; C_0805_2012Metric_Pad1.18x1.45mm_HandSolder; Tolerance 10%; Voltage Rating 50V; MPN KGM21NR71H102KT
C683: 0.68 uF; C_0805_2012Metric_Pad1.18x1.45mm_HandSolder; Tolerance 10%; Voltage Rating 50 V; MPN C0805C684K5RAC7800
C684: 10 uF; C_0805_2012Metric_Pad1.18x1.45mm_HandSolder; Tolerance 10%; Voltage Rating 25 V; MPN GRM21BZ71E106KE15L
D38: RED; LED_1206_3216Metric_Pad1.42x1.75mm_HandSolder; Voltage Rating 1.8 V Forward; MPN APT3216LSECK/J3-PRV
D39: B260A; D_SMA_Handsoldering; MPN B260A-13-F
R229: 1M; R_0805_2012Metric_Pad1.20x1.40mm_HandSolder; Tolerance 1%; Voltage Rating 150 V; MPN RC0805FR-131ML
R230: 68.1k; R_0805_2012Metric_Pad1.20x1.40mm_HandSolder; Tolerance 1%; Voltage Rating 150 V; MPN RC0805FR-0768K1L
R231: 4.75k; R_0805_2012Metric_Pad1.20x1.40mm_HandSolder; Tolerance 1%; Voltage Rating 150 V; MPN RC0805FR-074K75L
R232: 10.7k; R_0805_2012Metric_Pad1.20x1.40mm_HandSolder; Tolerance 1%; Voltage Rating 150 V; MPN RMCF0805FT10K7
R233: 27.4k; R_0805_2012Metric_Pad1.20x1.40mm_HandSolder; Tolerance 1%; Voltage Rating 150 V; MPN RMCF0805FT27K4
R234: 0 Ohm; R_0805_2012Metric_Pad1.20x1.40mm_HandSolder; Tolerance Jumper; Voltage Rating 150 V; MPN RC0805JR-070RL
R235: 41.2k; R_0805_2012Metric_Pad1.20x1.40mm_HandSolder; Tolerance 1%; Voltage Rating 150 V; MPN ERJ-6ENF4122V
TP21: IMON; Harwin_TP_S1751-46R; MPN S1751-46R
TP22: 15V Out; Harwin_TP_S1751-46R; MPN S1751-46R
U116: TPS16412; Texas_S-PVSON-N10_ThermalVias; MPN TPS16412DRCR

Connections:
EFVIN: C680.1, C681.1, D38.2 (A), R229.2, U116.1 (IN), U116.2 (VCC)
FEE_CTRL: R231.1, U116.5 (EN/~SHDN)
GND: C680.2, C681.2, C682.2, C683.2, C684.2, C685.2, D39.2 (A), R230.1, R231.2, R233.1, R234.1, R235.1, U116.11 (GND)
IMON: R235.2, TP21.1, U116.9 (IOCP/IMON)
unnamed: C682.1, R232.1, U116.4 (~FLT)
unnamed: C683.1, U116.7 (dVdT)
unnamed: D38.1 (K), R232.2
unnamed: R229.1, R230.2, U116.3 (OVP)
unnamed: R233.2, U116.8 (ILIM)
unnamed: R234.2, U116.6 (IDLY)
Vout: C684.1, C685.1, D39.1 (K), TP22.1, U116.10 (OUT)

Notes on the sheet:
For load current of 0.250 A, Vimon = 0.517 V Vimon = (2.06 ∗ Iout) + 0.002 V with 41.2k RIMON/RIOCP
RIOCP/RIMON
15 VDC
~1.25 mA
RLIM
CDLY
OPTION
