lwa-project/analog_receiver/ARX Rev I/KiBoM-master/test/kibom-test.sch

## KiCad design ARX Rev I/KiBoM-master/test/kibom-test.sch (2025-10-08)

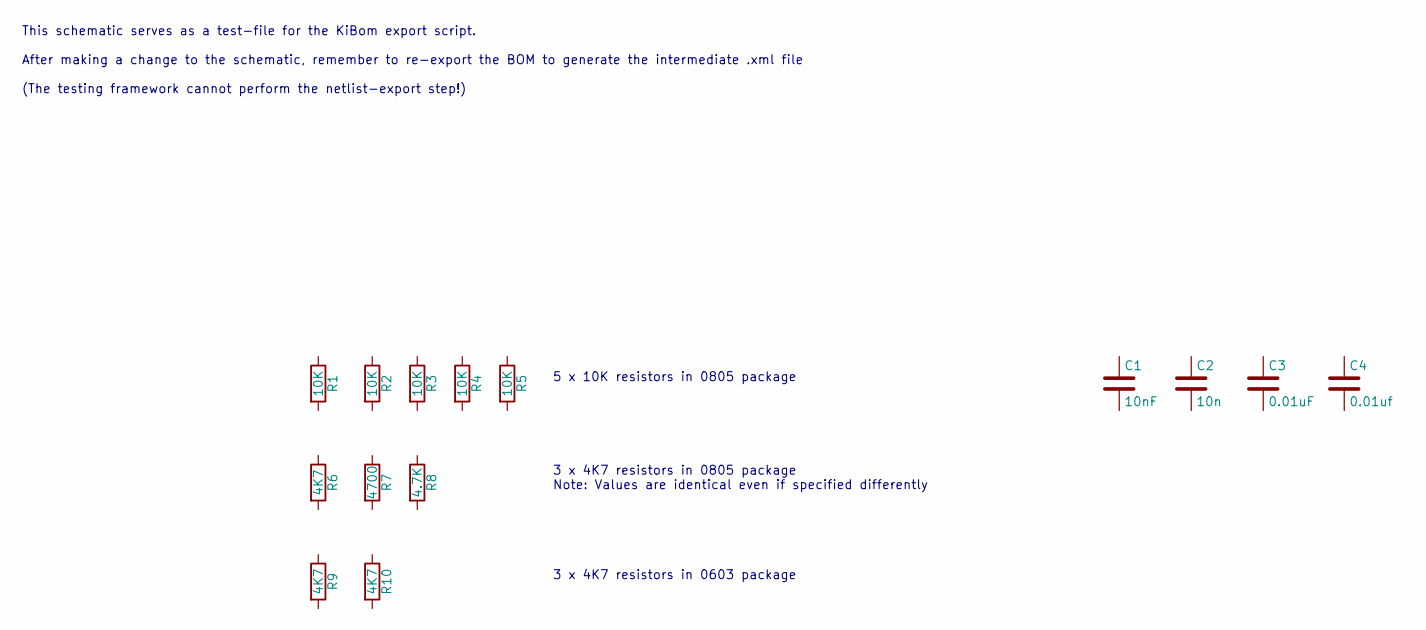
[picture p122: schematic kibom-test.sch]

Parts:
C1: 10nF; C_0603_1608Metric
C2: 10n; C_0603_1608Metric
C3: 0.01uF; C_0603_1608Metric
C4: 0.01uf; C_0603_1608Metric
R1, R2, R3, R4, R5: 10K; R_0805_2012Metric
R6: 4K7; R_0805_2012Metric
R7: 4700; R_0805_2012Metric
R8: 4.7K; R_0805_2012Metric
R9, R10: 4K7; R_0603_1608Metric

Notes on the sheet:
5 x 10K resistors in 0805 package
3 x 4K7 resistors in 0805 package Note: Values are identical even if specified differently
3 x 4K7 resistors in 0603 package
This schematic serves as a test-file for the KiBom export script. After making a change to the schematic, remember to re-export the BOM to generate the intermediate .xml file (The testing framework cannot perform the netlist-export step!)
