lwa-project/analog_receiver/ARX Rev I/Schematic Sheet Backups/ARX_FilterProto_sch (copy).kicad_sch

## KiCad design ARX Rev I/Schematic Sheet Backups/ARX_FilterProto_sch (copy).kicad_sch (2025-10-08)

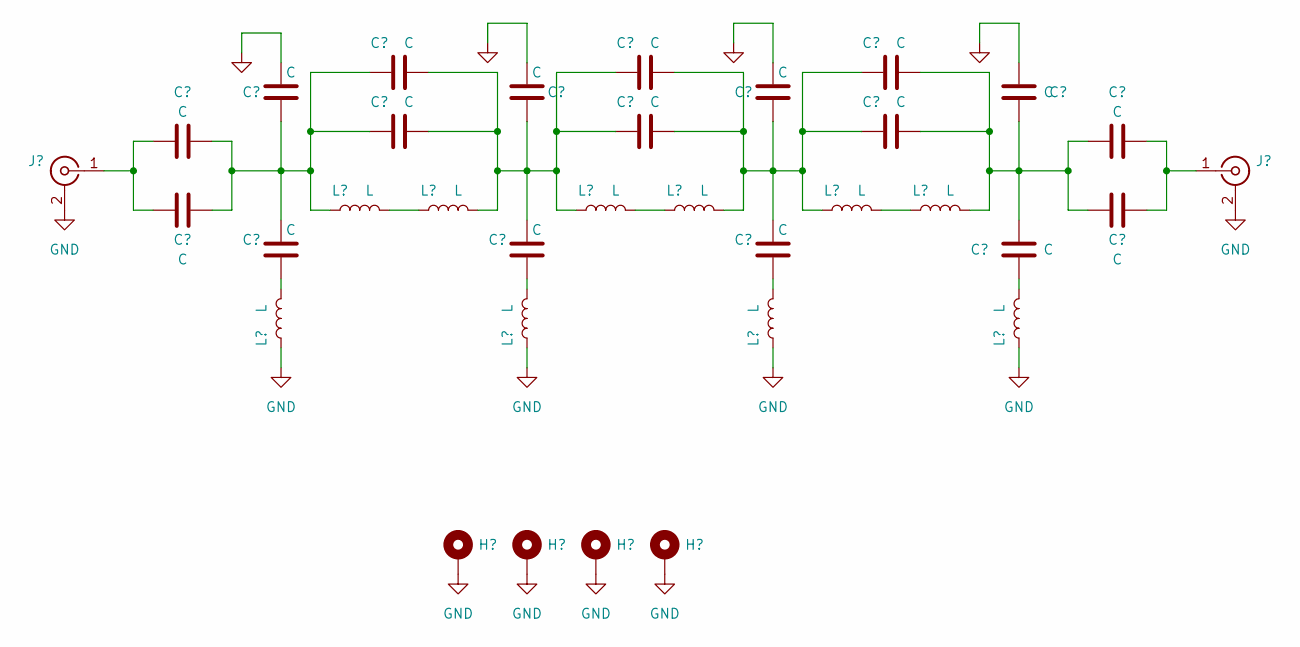
[picture p123: schematic ARX_FilterProto_sch (copy).kicad_sch]

Parts:
C1, C2, C3, C4, C5, C6, C7, C8, C9, C10, C11, C12, C13, C14, C15, C16, C17, C18: C; C_0805_2012Metric_Pad1.27x1.45mm_HandSolder
H1, H2, H3, H4: MountingHole_Pad; MountingHole_3.2mm_M3_Pad_TopBottom
J1, J2: Conn_Coaxial; LINX_SMA_EL
L1, L2, L3, L4, L5, L6, L7, L8, L9, L10: L; 1008CS_Handsolder

Connections:
GND: C3.1, C7.1, C11.1, C15.1, H1.1, H2.1, H3.1, H4.1, J1.2 (Ext), J2.2 (Ext), L1.1, L4.1, L7.1, L10.1
unnamed: C1.1, C2.1, C3.2, C4.2, C5.1, C6.1, L2.1
unnamed: C1.2, C2.2, J1.1 (In)
unnamed: C4.1, L1.2
unnamed: C8.1, L4.2
unnamed: C5.2, C6.2, C7.2, C8.2, C9.1, C10.1, L3.2, L5.1
unnamed: C9.2, C10.2, C11.2, C12.2, C13.1, C14.1, L6.2, L8.1
unnamed: C12.1, L7.2
unnamed: C13.2, C14.2, C15.2, C16.2, C17.1, C18.1, L9.2
unnamed: C16.1, L10.2
unnamed: C17.2, C18.2, J2.1 (In)
unnamed: L2.2, L3.1
unnamed: L5.2, L6.1
unnamed: L8.2, L9.1
