lwa-project/analog_receiver/(commit log)

2025-10-08 As built Rev I boards.
    [022124042.stp, 0ZCJ0050AF2E.STEP, 142-0701-201.stp, 2035-09-sm-rplf.stp, 431601104.stp, 431603104.stp, 431603106.stp, 459120007.stp]
2025-10-08 It's KiCAD.
