lwa-project/analog_receiver/(notices)

Notices in the files:
ARX Rev I/Project PCB Libraries/3D Models/C_1206_3216Metric.step:
Copyright (C) 2017, kicad StepUp
This work is licensed under the [Creative Commons CC-BY-SA 4.0 License](https://creativecommons.org/licenses/by-sa/4.0/legalcode),
with the following exception:
To the extent that the creation of electronic designs that use 'Licensed Material' can be considered to be 'Adapted Material',
You are free to use the library data in your own projects without the obligation to share your project files under this or any other license agreement.
ARX Rev I/Project PCB Libraries/3D Models/R_2512_6332Metric.step:
Copyright (C) 2018, kicad StepUp
